Krishna-Gorai/simtix/docs/v3_plan.md

# SIMTiX v3: closing the gap to the Cortex-A53

Started 2026-10-28. Goal: raise SIMTiX's performance on the application suite
against one Cortex-A53 core at 1.2 GHz (measured on the ZCU102, best of `-O2`
and `-O3` NEON builds; `docs/zcu102_a53_run_O*.txt`), one measured change at a
time, so that every change has its own gain, area and frequency.

## Starting point (medium inputs, 8 lanes, 4 warps, 100 MHz, simulated)

| App | SIMTiX / best A53 time | IPC | Lane util. | L1 hit | Main loss |
|---|---|---|---|---|---|
| GEMM 64^3 | 5.0 | 0.71 | 100% | 93% | 7.4 warp instructions per FMA |
| Stencil 128^2 x4 | 10.1 | 0.54 | 100% | 91% | ~33 lane instructions per point |
| k-means 16384 | 4.6 | 0.72 | 100% | 96% | instruction count, clock |
| BFS 16384 | 4.1 | 0.41 | 43% | 57% | divergence, memory latency |
| SpMV 4096 | 5.6 | 0.34 | 59% | 75% | divergence, gathers |
| Scan 65536 | 47 | 0.51 | 95% | 74% | parallel algorithm, 7 launches |
| MLP b16 | 0.43 (SIMTiX faster) | 0.49 | 100% | 52% | -- |

Sources: `docs/board_sim.csv` (sim/board_sim.py --size board --lat 24) and the
A53 logs. The A53 has 32 KB L1 + 1 MB L2; SIMTiX has a 16 KB L1.

## Phases (in order; each ends with the checks below)

**A. Kernels (software).** Register-blocked GEMM (each thread a 2x4 block,
accumulation order over k unchanged, so bit-exact); stencil with reuse of loaded
neighbours; SpMV with several lanes per row (needs gold in the same summation
order); fewer scan launches; unrolled k-means. Keep the old kernels for the
ablation.

**B1. Banked scratchpad.** One bank per lane, conflicts serialised, instead of one
lane per cycle; enables tiled GEMM and stencil in shared memory.

**B2. Register scoreboard.** A warp keeps issuing independent instructions while
an FP, multiply, dot, shuffle or memory result is pending, instead of parking on
every multi-cycle unit.

**B3. Eight warps.** More latency hiding for BFS, SpMV and k-means (LUTRAM
register files grow with the warp count).

**B4. Memory hierarchy.** L1 to 64 KB in block RAM, 8-16 MSHRs, more tags,
next-line prefetch.

**B5. Clock.** 150-200 MHz: an operand-read stage and a split FPU stage 0 (the
current critical path); only together with B2 and B3.

**C. Multi-core.** Two or three 8-lane cores with a shared L2 and more HP ports
(the lane sweep showed that wider warps grow the memory engine with L^2).

**D. Domain units.** Wider INT8 dot products (two INT8 MACs per DSP), packed
FP16; extends the one application where SIMTiX already wins.

## Status (end of 2026-10-29)

| Phase | Change | State |
|---|---|---|
| A | GEMM register blocking (`gemm_rb.S`) | done 10-28 |
| A | segmented scan (`scan_seg.S`, `scan_segadd.S`) | done 10-29: 2.35x (B2) / 2.95x (B3+B4), bit-exact |
| A | stencil, SpMV, k-means kernels | not started |
| B1 | banked scratchpad | postponed 10-29: no application uses the scratchpad beyond a few words (see Findings) |
| B2 | step 1: FP/mul/dot/shuffle accept an instruction every cycle | done, simulation (xsim 28/28, Verilator, apps) |
| B2 | step 2: register scoreboard, warps sleep on a stall | done, simulation (xsim 28/28, apps); lost wake-up found by B3 and fixed 10-29 |
| B2 | step 3: non-blocking loads, 8 memory contexts | done, simulation (xsim 28/28, apps) |
| B2 | board build (Fmax, area, power on the XCZU7EV) | done 10-29: meets 100 MHz (see Findings) |
| B3 | eight warps | simulation done 10-29 (apps bit-exact, `apps_w8` test); board build to do (`warps8`) |
| B4 | memory hierarchy | sweep done 10-29: 64 KB L1, 16 MSHRs, 16 tags chosen; board build to do |
| B4 | next-line prefetch (`SIMTIX_L1_PF`) | implemented 10-29, L1 tests pass with it on and off; measurement pending |
| B5 | clock 150-200 MHz | planned 10-29 (see worklog): FPU stage 0 via retiming over the delay line; memory-engine request split |
| A | stencil (`stencil_rb.S`), k-means (`kmeans_u.S`), SpMV (`spmv_z.S`) | done 11-04, bit-exact (see Findings) |
| A' | Zba `sh1add`-`sh3add`, Zbb `min`/`max`(`u`), Zicond `czero.*` | done 11-04: decode + writeback mux, `zbtest` case |
| B5 | clock: request, input and resume registers in the memory engine, branch stage B | done 11-04 in simulation; build at 115 MHz to do |
| C | multi-core | not started |
| D | INT8/FP16 units | not started |

Every step's medium-size application results: `docs/v3_steps.csv` (column `step`).
Board builds run from a PowerShell window outside Claude Code (Claude Code stops
background jobs when the 8 GB PC runs low on memory):
`vivado -mode batch -source create_bd_ps.tcl -tclargs build zcu104 tag<name>` from
`fpga/`, after `Remove-Item Env:\NoDefaultCurrentDirectoryInExePath`.

## Findings

**2026-10-28, A (GEMM).** `gemm_rb.S` (a 4x4 block of C per thread, bit-exact
with `gemm.S`) cuts the warp instructions of GEMM 64^3 from 241,152 to 65,632
(3.7x) but its cycles only from 337,591 to 282,884 (1.19x): IPC falls from 0.71
to 0.23. The cause is in the warp pool, not the kernel: the FP unit is a
single-slot scoreboard (`fpc_state`, warp_pool.sv), so one FP warp instruction is
in flight in the whole accelerator and the 5-stage FPU holds one instruction at a
time, about one warp FMA per 7 cycles. The integer multiplier, dot-product,
shuffle and divide/sqrt units are built the same way. B2 therefore comes first
and is widened: the multi-cycle units accept a new warp instruction every cycle
(one result slot per pipeline stage), then a register scoreboard lets a warp keep
issuing independent instructions. Without it the kernel work of A cannot pay off
on FP and multiply-bound applications.

## Checks after every phase

1. xsim regression (sim/run_xsim.py, 28 configurations) and Verilator 5.020
   parity (CI).
2. Application suite bit-exact at small, board and (overnight) dram sizes;
   cycles, IPC, utilisation and L1 hit rate into docs/board_sim.csv.
3. Out-of-context synthesis and implementation on the XCZU7EV (LUT, FF, BRAM,
   DSP, Fmax, power); the board design for the ZCU104 must still close 100 MHz
   (or the new target clock).
4. A table row: phase, change, cycles per app, time at Fmax, ratio to the A53.

## Constraints

- The ZCU102's XCZU9EG needs a Vivado Enterprise license, so the accelerator
  does not run on the board: SIMTiX results come from simulation and XCZU7EV
  implementation; the A53 is measured.
- If SIMTiX becomes multi-core, the A53 comparison should include all four A53
  cores as well.
- Builds on the 8 GB PC: one Vivado run at a time, PC must not sleep.

**2026-10-29, B2 (register scoreboard) in three steps.** Medium inputs, 8 lanes,
4 warps, DDR model latency 24, all outputs bit-exact; cycles:

| App | v2 | Step 1 | Step 2 | Step 3 | Gain | SIMTiX / A53 time |
|---|---|---|---|---|---|---|
| GEMM-RB 64^3 | 282,884 | 145,067 | 96,939 | 80,443 | 3.52x | 4.19 -> 1.19 |
| GEMM 64^3 | 337,591 | 312,499 | 272,634 | 265,127 | 1.27x | 5.00 -> 3.93 |
| Stencil 128^2 x4 | 498,582 | 485,789 | 460,225 | 403,964 | 1.23x | 10.07 -> 8.16 |
| SpMV 4096 | 263,749 | 263,146 | 254,517 | 234,879 | 1.12x | 5.55 -> 4.94 |
| k-means 16384 | 993,810 | 942,594 | 913,366 | 899,601 | 1.10x | 4.63 -> 4.19 |
| Scan 65536 | 1,085,404 | 1,085,413 | 1,088,773 | 1,021,428 | 1.06x | 47.4 -> 44.6 |
| BFS 16384 | 1,771,198 | 1,771,800 | 1,770,554 | 1,724,941 | 1.03x | 4.08 -> 3.97 |
| MLP b16 | 1,973,694 | 2,012,258 | 2,152,311 | 1,936,909 | 1.02x | 0.43 -> 0.42 |

- Step 1. The FP, multiply, dot and shuffle units accept a warp instruction every
  cycle: a result queue per unit (`wp_resq`) carries the op's tag in step with the
  unit (latency FPU 6, multiply 7, dot 6, shuffle 1) and holds finished results until
  their write port is free.
- Step 2. The warp no longer parks on these units. Per-warp pending masks
  (`pend_x`, `pend_f`) hold back an instruction whose sources or destination are
  pending (decoded per opcode, so immediate fields never stall), whose unit is full
  (8 ops in flight per unit), or an ecall with results outstanding. Without more,
  MLP got 7% slower than step 1: the stalled warp was refetched every other cycle
  and took issue slots from the other warps. A stalled warp therefore sleeps until
  one of its own results is written (or, if its unit was full, any result); with
  that MLP recovered a third of the loss (`b2s2b_scoreboard_sleep` rows, measured for
  GEMM, GEMM-RB and MLP only).
- Step 3. Loads do not park the warp: rd is pending until the memory engine
  reports the load finished (`rs_ld`, `rs_rd`, `rs_fp`). Up to 2 loads per warp,
  8 memory contexts. A store, AMO, barrier or ecall waits until the warp has no load
  outstanding (a store never overtakes an earlier load of its warp; a barrier orders
  loads before it against stores after it). MLP is back below v2.
- What is left: GEMM-RB is within 1.19x of the A53 (NEON) at 100 MHz; the
  memory-bound applications (L1 hit 52-75%) gain only 2-12%, limited by the L1 and
  the request path (B4); scan needs a different algorithm (A).

**2026-10-29, B2 board build** (`create_bd_ps.tcl build zcu104 tagv3b2`,
`fpga/reports_ps_v3b2/`, against the v2 build in `fpga/reports_ps/`):

| | v2 | B2 |
|---|---|---|
| WNS at 10 ns | +0.098 ns | +0.093 ns (meets 100 MHz; Fmax 100.9 MHz) |
| LUTs | 81,060 | 84,459 (+4.2%) |
| Flip-flops | 23,910 | 32,969 (+38%) |
| CLBs | 13,703 (47.6%) | 14,640 (50.8%) |
| BRAM / DSP | 16 / 72 | 16 / 72 |
| SIMTiX power (vectorless) | 0.833 W | 1.049 W |

The flip-flops are the four result queues (4 x 8 x 256 bits, built from
flip-flops, not LUT-RAM) and the four extra memory contexts. The worst path moved
from FPU stage 0 (35 levels) to the memory engine: context pending lanes ->
coalescing / request select of the 8 contexts -> L1 input register (28 levels,
74% routing). B5 has to split both. GEMM-RB takes 3.5x fewer cycles at 1.26x the
power: about 2.8x less energy.

**2026-10-29, lost wake-up (B2) found by B3.** With 8 warps GEMM-RB hung. The issue
step decided "woken in the same cycle" with the reason of the warp's previous sleep
(`sb_wfull`); a warp whose last sleep was on a full FP unit then missed the
completion of the load it was now waiting for. Fixed (the stalling warp is judged by
this cycle's reason; the wake loop only touches sleeping warps). New regression test
`apps_w8` (medium GEMM-RB, 8 warps): fails on the old logic, passes now. With 4
warps the fix changes only GEMM-RB (80,443 -> 80,271 cycles); `b2_final` rows.

**2026-10-29, B3: eight warps** (`board_sim.py --warps 8`; 16 memory contexts,
2 per warp; `b3_8warps` rows):

| App | B2 (4 warps) | B3 (8 warps) | Gain | SIMTiX / A53 time |
|---|---|---|---|---|
| MLP b16 | 1,936,909 | 1,396,076 | 1.39x | 0.30 |
| Scan 65536 | 1,021,428 | 805,236 | 1.27x | 35.2 |
| Stencil 128^2 x4 | 403,964 | 322,010 | 1.25x | 6.51 |
| BFS 16384 | 1,724,941 | 1,444,288 | 1.19x | 3.33 |
| k-means 16384 | 899,601 | 841,946 | 1.07x | 3.92 |
| GEMM 64^3 | 265,127 | 249,518 | 1.06x | 3.70 |
| GEMM-RB 64^3 | 80,271 | 76,209 | 1.05x | 1.13 |
| SpMV 4096 | 234,879 | 237,185 | 0.99x | 4.99 |

More warps hide memory latency (MLP, stencil, scan, BFS); GEMM-RB is compute-bound;
SpMV's L1 hit rate falls (75% -> 72%) as 8 warps share the 16 KB L1, a B4 question.
Area and Fmax: board build `create_bd_ps.tcl build zcu104 tagv3b3 warps8` (the
block design is then synthesised globally so the define reaches SIMTiX).

**2026-10-29, B4: memory hierarchy sweep** (8 warps; speed-up over 8 warps with the
v2 memory system; all bit-exact; `b4_w8_*` rows):

| App | 8 MSHR | 16 tags | 16 MSHR + 16 tags | 32 KB L1 | 64 KB L1 | 64 KB + 16 MSHR + 16 tags |
|---|---|---|---|---|---|---|
| SpMV 4096 | 1.43 | 1.00 | 1.70 | 1.37 | 1.50 | 1.84 |
| BFS 16384 | 1.24 | 1.00 | 1.30 | 1.13 | 1.28 | 1.35 |
| GEMM-RB 64^3 | 1.01 | 1.01 | 1.03 | 1.08 | 1.07 | 1.08 |
| MLP b16 | 1.00 | 1.00 | 1.00 | 1.01 | 1.01 | 1.01 |
| GEMM, k-means, scan, stencil | 1.00 | 1.00 | 1.00 | 0.99-1.00 | 0.99-1.00 | 0.99-1.00 |

L1 hit rate with the combined change: SpMV 72% -> 87%, BFS 55% -> 74%, MLP 52% -> 59%
(its time does not move: the weights stream once per batch). The 4 miss registers
were the limit for the irregular applications; 16 tags help only together with more
miss registers. Stencil, scan, k-means and GEMM do not change at all, so next-line
prefetch (the remaining B4 item) has nothing to gain and is dropped. Choice: 64 KB
L1, 16 MSHRs, 16 tags. Board build for B3+B4: `create_bd_ps.tcl build zcu104
tagv3b34 warps8 l1kb64 mshr16 mtags16` (`mtags`, since `tag<name>` names the build).
16 tags widen the AXI ID to 5 bits: `simt_ps_wrap.v` had a hard-coded 4-bit ID,
now `IDW = log2(SIMTIX_MEM_TAGS) + 1` (default 4); both widths elaborate cleanly.

**2026-10-29, B1 postponed.** Of the eight applications only `scan.S` touches the
scratchpad, for the four warp totals of each block. A banked scratchpad (one bank
per lane) would speed up nothing in the suite; it pays off only for kernels that
tile through shared memory (GEMM, stencil), and B4's 64 KB L1 already serves
their reuse. B1 is reconsidered if phase A writes such a kernel.

**2026-10-29, A: segmented scan** (`scanseg` case: the same 65,536 inputs as
`scan`, seed shared). One warp scans a segment of 64 rows x 8 lanes: coalesced
row loads, a 3-step shuffle scan with the lane masks set up once, the running
total carried by one `shfl_idx`; 16 warp instructions per row. A second level scans
the 128 segment totals and `scan_segadd.S` adds them: 3 launches instead of 7.
Kernels in slots 10 and 11 (45 and 22 words); `a_scan_*` rows.

| Configuration | scan | scanseg | Gain | Warp instructions | SIMTiX / A53 time |
|---|---|---|---|---|---|
| B2, 4 warps | 1,021,751 | 433,947 | 2.35x | 549,736 -> 193,954 | 44.6 -> 19.0 |
| B3+B4 (8 warps, 64 KB, 16 MSHR, 16 tags) | 805,076 | 273,009 | 2.95x | same | 35.2 -> 11.9 |

The first pass now hits the L1 only 6% of the time (458 hits, 8,214 misses: every
line of the input is new) and the add pass misses again on the output (the L1
does not allocate on writes). That reverses the earlier conclusion on next-line
prefetch, which was drawn from kernels that reuse lines: streaming kernels such as
this one need it.

**2026-11-04, low-cost steps (kernels, ISA, clock).** The B3+B4 profile shows an
issue-bound core: IPC 0.68-0.96, lane use near 100% outside BFS and SpMV, and at most
20% of the HP0 port in use. One warp instruction per cycle on 8 lanes at 100 MHz is
0.8 G lane operations per second, below one A53 with NEON, so the cheap levers are
fewer instructions per result and a faster clock. Board inputs, 8 warps, 64 KB L1,
16 MSHRs, 16 tags, DDR model latency 24, all outputs bit-exact; cycles:

| App | Before | Kernel | + ISA | + clock stages | Gain |
|---|---|---|---|---|---|
| Stencil 128^2 x4 | 320,928 | 173,316 (strip of 16 rows) | -- | 148,935 (rows interleaved) | 2.15x |
| k-means 16384 | 841,609 | 652,224 (2 points/thread) | 548,667 (min, czero) | 537,806 (points interleaved) | 1.56x |
| SpMV 4096 | 129,287 | -- | 115,035 (pointer walk, sh2add) | 116,516 | 1.11x |
| other apps | -- | -- | -- | 0.96-0.99x | -- |

- `stencil_rb.S`: a thread computes 16 rows of one column; up, centre and down move
  down the column in registers, so a point loads 3 words instead of 5 and the
  per-thread setup is paid once per 16 points. The two rows of a loop pass are
  interleaved, which lifts IPC from 0.70 to 0.82.
- `kmeans_u.S`: two points per thread share each centroid load; the nearest-centroid
  update is `slt`, `min`, `czero.eqz`, `czero.nez`, `or` (5 instructions, 8 before).
- The three extensions add a 7-bit funct7 decode and one result mux per lane, on the
  register write only (not on the address path).
- Clock. A path analysis of the routed B2 build (`paths_named.tcl`) finds 38,680
  endpoints failing at 150 MHz, 12,087 at 125 MHz and 2,455 at 111 MHz, in four groups:
  warp issue -> memory-engine context registers, warp issue -> SIMT stack, memory
  engine -> L1 input register, and FPU stage 0 / last stage. 150 MHz would need an
  operand-read stage across the whole issue logic; the four groups are cut instead:
  the memory engine registers its request (choice, then address and data), its input
  and its warp resume (`BYP = 0` only), and a branch or jump updates the SIMT stack in
  a stage B one cycle after issue (the warp stays in flight). The FPU paths are left
  to synthesis retiming (`create_bd_ps.tcl ... retime`). Cost: 0.3-3.8% more cycles.
  Board build: `... tagv3b34 warps8 l1kb64 mshr16 mtags16 mhz116 retime`: the PS
  divides 1.5 GHz by 13 (115.37 MHz); it rounds a request down, so `mhz115` gives
  1.5 GHz / 14 = 107.1 MHz.
- Not addressed: reduce, scan and histogram. They stream one element per thread and
  are limited by instruction count, launches and global atomics; even the full HP0
  bandwidth at 100 MHz would not reach the A53 on reduce.

**2026-11-04, board run of the low-cost build** (`docs/zcu102_board_run_v3b34.txt`).
The build closes at 115.37 MHz with WNS +0.406 ns (est. Fmax about 121 MHz); 107,658
LUTs and 50,091 registers (the 100 MHz B3+B4 build had 110,970 and 48,383; B2 82,998
and 33,016); 16 BRAM tiles and 72 DSPs in each. All 28 cases are bit-exact, the
histogram included (the AXI ordering fix holds on the board). Time is the measured
accelerator time; A53/accel above 1 means the accelerator is faster.

| App | Size | B2 us | v3 us | v3 / B2 | A53/accel B2 | A53/accel v3 |
|---|---|---|---|---|---|---|
| GEMM | 64 | 2,584.8 | 2,165.0 | 1.19x | 1.04 | 1.25 |
| GEMM | 256 | 215,172.4 | 150,613.0 | 1.43x | 0.79 | 1.13 |
| GEMM, register-blocked | 256 | 49,662.0 | 37,780.7 | 1.31x | 3.42 | 4.49 |
| MLP | 256 | 278,560.9 | 189,783.3 | 1.47x | 2.62 | 3.85 |
| BFS | 262144 | 260,316.4 | 162,890.2 | 1.60x | 0.75 | 1.20 |
| Stencil, 16-row strip | 512 | 59,197.1 (stencil) | 18,945.1 | 3.12x | 0.36 | 1.12 |
| SpMV | 65536 | 46,634.9 | 20,204.9 | 2.31x | 0.39 | 0.90 |
| k-means, 2 points/thread | 262144 | 139,603.8 (kmeans) | 72,189.1 | 1.93x | 0.30 | 0.57 |
| Segmented scan | 1048576 | 54,667.9 | 35,474.8 | 1.54x | 0.08 | 0.13 |
| Histogram | 262144 | 7,897.4 | 5,653.5 | 1.40x | 0.25 | 0.35 |
| Scan | 1048576 | 145,148.9 | 108,019.7 | 1.34x | 0.03 | 0.04 |

PL power rises with the larger, faster design: idle 1.12 -> 1.24 W; accelerator
running 1.42-1.92 W (B2) -> 1.70-2.28 W.

`spmv_z` on the board (second run, 08:29; the other 28 cases repeat the first run within
1%): 4096 rows 116,949 cycles against 130,900 for `spmv` (1.12x, A53/accel 0.47);
65536 rows 2,233,648 against 2,332,695 (1.04x, A53/accel 0.94). The large case misses
the L1 on 40% of accesses, so fewer instructions help less there. It runs after the
other cases, so its random matrix differs from the `spmv` one (same size and density).

**Caution on the A53/accel column above:** it uses the board host's own A53 build
(`-O2`). Against the best A53 build (`-O3 -mcpu=cortex-a53`, NEON; `sw/a53_zcu102`) the
regular kernels move a lot (GEMM 3.6x, stencil 2.5x faster on the A53); see the table
of the afternoon below. The MLP's 3.85 is also against a reference that cannot
vectorize (below).

## 2026-11-04 (afternoon): everything on the board, new applications, AMO variants

Decisions (user): the TVLSI paper is retargeted to v3, and every result in it is
measured on the ZCU102: the AMO variants and the 4- and 16-lane designs as their own
bitstreams, and Vortex 3.0 as a PS peripheral of the same board. The paper shows both
A53 builds (`-O2` and `-O3` NEON).

**Board-build options** (`create_bd_ps.tcl`): `lanes<n>`, `agg<0|1>`, `apar<0|1>` set
`SIMTIX_NUM_LANES`, `SIMTIX_AMO_AGG`, `SIMTIX_AMO_PAR`; `simt_ps_top` takes its
`AMO_AGG` / `AMO_PAR` defaults from the two macros (a block-design module reference
cannot override parameters). `sim/v3_sweeps.py` runs `app_sweep.py` and
`amo_sweep.py` with the v3 defines (`docs/apps_agg_v3.csv`, `docs/amo_agg_v3.csv`;
15/15 runs pass).

**Host additions.** `main.c`: `hist_shared` (block-shared histogram) and
`amo_contend` (colliding `amoadd`/`amomax`/`amoswap`; every returned value and final
word checked against the serial lane order). `apps.c`: an overlay window in the
instruction RAM (`PC_OVL` = 0x000-0x1FF, 128 words; main.c's sync kernels are done
before the suite) into which `stencil_rb` and the new kernels are loaded at the start
of their application; a second, fair MLP reference (`A53T` rows: weights one
contiguous row per output, so GCC vectorizes the INT8 dot product). `gen_apps.py`:
`OVERLAY` kernels share one region after the resident ones and a case loads its
overlay kernel (a `KERNEL` line inside the case); `write_manifest()`.

**New application kernels** (all bit-exact in simulation at small and board sizes,
v3 defines, late write responses; and on the board):
- `conv8.S` (111 words): INT8 3x3 convolution, padding 1, requantization + ReLU as
  `mlp.S`; layout [row][channel/4][column] words so a layer's output is the next
  layer's input; a thread computes 4 adjacent pixels of one output channel (12
  `pdot8` per 9 loads). Board: 16 -> 32 -> 32 channels, 32x32 and 128x128 images.
  A53 reference: NHWC bytes, OHWI weights (contiguous channels, vectorized at -O3).
- `embag.S` (31 words): embedding-bag sum (recommendation inference), D = 32
  floats per row, summed in order from +0; two gathers in flight per warp. Board:
  16,384-row (2 MB) and 262,144-row (32 MB) tables, 256x16 and 4096x32 bags.
- `hashj.S` (26 words): hash-join probe, linear probing, 2^s slots {key, value},
  half full, half of the probe keys present; one backward branch, the hit test with
  Zicond. Board: s = 16 (16,384 probes) and s = 22 (32 MB, 1M probes).
- `mandel.S` (38 words): Mandelbrot escape counts, FP32, [-2, 0.5] x [-1.25, 1.25],
  M = 256. Board: 256^2 and 1024^2.
- `swat.S` (116 words): Smith-Waterman scores, affine gaps (+2/-1, open 3, extend 1),
  one DNA pair per thread, query in strips of 4 rows (H, E in registers, a packed
  boundary word per column between strips). Board: 2,048 and 16,384 pairs of 32 x 128.

**Board, `ser` bitstream (v3b34), against both A53 builds** (`docs/zcu102_board_run_v3_apps2.txt`,
`docs/zcu102_a53_run_O{2,3}_v3apps.txt`; large sizes; times in ms; > 1: SIMTiX faster):

| App | SIMTiX | A53 -O2 | A53 -O3 NEON | vs best A53 |
|---|---|---|---|---|
| Hash-join probe, 32 MB | 99.3 | 195.6 | 195.4 | 1.97 |
| CNN 128x128, 16-32-32 | 290.7 | 1,196.3 | 381.8 | 1.31 |
| GEMM-RB 256 | 37.8 | 169.6 | 47.2 | 1.25 |
| Embedding bag, 32 MB | 37.5 | 68.7 | 45.4 | 1.21 |
| BFS 262144 | 162.9 | 195.8 | 194.6 | 1.19 |
| SpMV-Z 65536 | 19.4 | 18.2 | 18.1 | 0.94 |
| k-means-U 262144 | 72.2 | 41.3 | 34.3 | 0.47 |
| Stencil-RB 512 | 18.9 | 21.3 | 8.6 | 0.45 |
| MLP 256, fair reference | 189.8 | 256.5 | 55.4 | 0.29 |
| Segmented scan 1M | 35.5 | 4.5 | 4.5 | 0.13 |

The `-O2` and `-O3` builds give the same arena hash for every application. SIMTiX
wins on memory-latency-bound work (hash join, embedding bag, BFS: one in-order A53
thread waits on each DRAM miss, SIMTiX keeps 64 threads and 16 misses in flight) and
on regular compute with reuse per thread (GEMM-RB, CNN). It loses on streaming kernels
with little work per element and on dense INT8 dot products, where NEON keeps up.
**MLP:** the original A53 reference reads the weights in the accelerator's packed
layout and cannot vectorize (730 ms at -O2 and -O3); with contiguous weights the A53
takes 256.5 ms at -O2 and 55.4 ms at -O3, so SIMTiX's 3.85x becomes 0.29x. The
paper must not use the old number. The MLP kernel itself does 0.32 G MAC/s (one
output per thread); a register-blocked version like `conv8.S` (0.78 G MAC/s in
simulation) would still trail the A53's ~1.1 G MAC/s. The A53 references are plain C
compiled by GCC, not a tuned library; a tuned NEON CNN would narrow the 1.31.

**AMO tests on the board** (`docs/zcu102_board_run_v3_ser.txt`; 262,144 elements;
`ser`): histogram 653,913 cycles (5.67 ms; A53 2.00 ms), block-shared histogram
1,186,938, contention 4,292,620 (37.2 ms; A53 6.2 ms); every contention return value
(786,432) and final word (524,288) matches the serial lane order. The L1 read counts
are exact: 3 reads per histogram warp (input line + one per bin line), 4 per contention
warp (input + one per AMO instruction). These kernels are memory-engine bound (the
port is held from an AMO's read to its write; ~20 cycles per histogram warp) and
measure the mechanism, not speed against the A53.

**`agg0` bitstream** (one read-modify-write per lane; `tagv3agg0 ... agg0 mhz116
retime`): WNS +0.349 ns at 115.37 MHz, 106,998 LUTs, 50,036 registers (aggregation
costs 660 LUTs, 0.6%, in context; 2,551 out of context in the v2 engine). Board
(`docs/zcu102_board_run_v3_agg0.txt`, all 0 errors), 262,144 elements, `agg0` -> `ser`:

| Kernel | agg0 cycles | ser cycles | Gain | L1 reads agg0 -> ser |
|---|---|---|---|---|
| Histogram | 1,618,167 | 652,783 | 2.48x | 294,912 -> 98,304 |
| AMO contention | 7,706,706 | 4,291,186 | 1.80x | 819,200 -> 131,072 |
| Block-shared histogram | 1,380,470 | 1,180,049 | 1.17x | 163,840 -> 49,152 |
| k-means-U | 8,937,737 | 8,331,755 | 1.07x | |
| k-means | 13,600,741 | 13,384,065 | 1.02x | |
| BFS | 18,826,816 | 18,792,724 | 1.00x | |

Without aggregation the block-shared histogram beats the plain one (textbook); with it
the plain one is 1.8x faster. The v2 paper's k-means gain of 1.29x shrinks to 1.02x
in v3 (8 warps, scoreboard and the 64 KB L1 make the final AMOs a small part).

**Mandelbrot and Smith-Waterman.** Small sizes pass (Mandelbrot IPC 0.92, 74% lane use;
Smith-Waterman IPC 0.97, 0.36 cells/cycle, about 42 M cells/s at 115 MHz). The first
board-size simulation failed only because `tb_apps` gave up after 2M status polls
(~10M cycles); the limit is now 20M and the rerun is in progress. A53 (board,
`docs/zcu102_a53_run_O{2,3}_v3apps2.txt`): Mandelbrot 1024^2 847.9 ms (-O2) / 845.7
(-O3); Smith-Waterman 16,384 pairs 922.1 ms (-O2) / 1,075.2 (-O3), 72.8 M cells/s.
Neither vectorizes.

**2026-11-06, both on the board** (`docs/zcu102_board_run_v3_apps3.txt`, `ser`, all
cases 0 errors; the board-size simulation passed first, 67,584 checks): Mandelbrot
256^2 7,876,275 cycles (68.3 ms; A53 best 52.9 ms, 0.77x), 1024^2 117,647,130 cycles
(1,019.7 ms; A53 best 845.7 ms, **0.83x**); Smith-Waterman 2,048 pairs 23,265,849
cycles (201.7 ms; A53 best 115.1 ms), 16,384 pairs 186,138,599 cycles (1,613.4 ms;
A53 best 922.1 ms, **0.57x**, 41.6 vs 72.8 M cells/s). Board and simulated cycles
agree within 0.1%. Total energy of the 18 rails, A53 best / SIMTiX: Mandelbrot 0.62,
Smith-Waterman 0.55 (SIMTiX phase 4.19 / 3.83 W, A53 phase 3.12-3.16 W).

**Energy, all applications (2026-11-05/06).** Sum of the 18 rails: idle 3.13-3.17 W
(A53 polling), SIMTiX phase 3.62-4.26 W (+0.5 to +1.1 W), A53 phase 3.18-3.38 W
(+0.05 to +0.2 W: the A53 already runs in the idle phase). Total energy, best A53 /
SIMTiX: hash join 1.50, CNN 1.02, BFS 0.96, embedding bag 0.94, GEMM-RB 0.94, SpMV-Z
0.73, Mandelbrot 0.62, Smith-Waterman 0.55, k-means-U 0.38, stencil-RB 0.34,
segmented scan 0.11. Energy above idle makes SIMTiX look 11-100x worse, because it
charges the accelerator its whole switching power and the A53 almost nothing; the
paper should report total energy first.
