Krishna-Gorai/simtix/docs/board_zcu104.md

# SIMTiX v2 on the ZCU104 (A53 host, DDR4)

The board build makes the accelerator a peripheral of the Zynq UltraScale+ PS:

```
Cortex-A53 --M_AXI_HPM0_FPD--> SmartConnect --AXI4-Lite--> simt_ps_top (0xA000_0000)
simt_accel --> l1_dcache --> axi_line_master --AXI4 128-bit--> S_AXI_HP0_FPD --> DDR4
```

| Window offset | Contents |
|---|---|
| `0x0000`–`0x00FF` | command / status registers (`REG_*` in `simtix_pkg.sv`) |
| `0x0100` / `0x0104` | L1 read hits / misses of the last kernel |
| `0x0108` | bit 0: an AXI error response was seen |
| `0x1000`–`0x1FFF` | kernel instruction RAM (1024 words); `REG_KERNEL_PC` is an offset into it |

Data buffers must lie below `0x4000_0000`: addresses with bits [31:30] = `01` are the
accelerator's scratchpad apertures. The HP0 port is not coherent with the A53
caches, so the host cleans its data cache before GO and invalidates it after DONE.
Writing GO also invalidates the L1.

## Build (on the PC)

1. Bitstream and hardware platform, from `fpga/` (launch Vivado from PowerShell):

   ```
   vivado -mode batch -source create_bd_ps.tcl -tclargs build
   ```

   writes `fpga/simtix_ps.xsa` and the reports in `fpga/reports_ps/`.

2. Host program (regenerate `kernels.h` only if a kernel changed):

   ```
   python sw/ps_host/gen_kernels.py
   vitis -s sw/ps_host/build_vitis.py
   ```

   builds `sw/ps_host/ws/ps_host/build/ps_host.elf`. Two gaps in a Vitis install
   without the Zynq UltraScale+ software components stop this step:

   - no `aarch64-none-elf-gcc`: install the Arm GNU Toolchain (14.2.rel1,
     `aarch64-none-elf`) and put its `bin` on `PATH`, or set `AARCH64_GCC_DIR`;
     the script defaults to `C:\toolchains\arm-gnu-14.2-aarch64-none-elf\bin`.
   - platform creation fails with "Application error processing RPC": the server
     is trying to copy QEMU files that were not installed. Creating the empty
     directories `Vitis\data\emulation\platforms\zynqmp\sw\{a53_linux,a53_standalone,r5_standalone}\qemu`
     is enough for a JTAG run.

## Run (in the lab)

1. Boot-mode switch SW6 to JTAG (all four ON); connect USB-JTAG and USB-UART;
   power on.
2. Open a terminal on the board's first USB-UART port at 115200 8N1.
3. From the repository root: `xsdb sw/ps_host/run_board.tcl` (`xsdb` is in `Vivado\bin`).

The program prints one CSV line per run and a final verdict:

```
BOARD,kernel,N,accel_cycles,accel_us,a53_us,l1_hits,l1_misses,errors
BOARD,reduce_shfl,1024,...
...
RESULT: PASS (0 errors)
```

`accel_cycles` is the accelerator's own cycle counter (100 MHz); `accel_us` is
the wall time from GO to DONE measured by the A53 (including register polling);
`a53_us` is the same computation on one A53 core.

After `reduce_shfl` and `histogram`, the application suite (`sw/ps_host/apps.c`,
the kernels of `kernels/apps/`) prints one row per application and size, with the
size in the `N` column: `gemm` (n x n FP32, n = 64, 256), `spmv` (rows, 16 nonzeros
at most per row), `stencil` (n x n, 4 sweeps), `kmeans` (points, 16 clusters),
`bfs` (vertices, degree 8) and `scan` (elements). Multi-launch applications
(stencil, BFS, scan) sum cycles and L1 counts over their launches, and `accel_us`
covers the first GO to the last DONE. The A53 baselines are ordinary sequential
codes (a queue for BFS, a running sum for scan, i-k-j GEMM), and every accelerator
output is compared exactly with them; the data lives in DDR4 at `0x1000_0000`.

Last comes a power pass (`sw/ps_host/power.c`) over the DRAM-sized input of each
application, if the board's monitors answer on the PS I2C1 bus: the INA226 on the
12 V input (U183, 5 mΩ shunt) and the five outputs of each IRPS5401 PMIC (U175 at
0x43, U180 at 0x44), behind the PCA9548 mux at 0x74. It first prints one
`POWERRAIL,<rail>,<mV>,<mW>` line per rail it found (the output voltages identify
the PMIC rails), then, per application, one row per phase and rail:

```
POWER,app,size,phase,rail,mV,mW,samples,reps,ms
```

Each phase is repeated for two seconds and sampled at most every 50 ms between
repetitions (and while the A53 polls the accelerator): `idle` is the A53 polling
the status register with the accelerator idle, `accel` the accelerator running
the application, `a53` the A53 running its reference. `reps / ms` gives the time
per repetition. Outputs are not checked in this pass. The program writes only the
mux's channel byte, the PMBus PAGE command and the INA226 configuration register.

## ZCU102 (2026-10-28)

The lab's board turned out to be a ZCU102 (XCZU9EG). `create_bd_ps.tcl`,
`power.c`, `build_vitis.py` and `run_board.tcl` take the board as an argument
(ZCU102 by default) and `power.c` has the ZCU102 monitor table (PS I2C0, PCA9544
mux at 0x75, 18 INA226). Vivado ML Standard cannot implement the XCZU9EG, so
until a license is available only the A53 side runs on that board:
`sw/a53_zcu102/README.md` (PS bring-up over JTAG, A53 references and power) and
`docs/zcu102_a53.md` (results).
