Krishna-Gorai/simtix/docs/zcu102_a53.md

# A53 on the ZCU102, and SIMTiX against it (2026-10-28)

The application suite's A53 references measured on a ZCU102 (XCZU9EG, board
revision 1.1), and SIMTiX's cycles for the same inputs from simulation. Procedure
and tools: `sw/a53_zcu102/README.md`. Raw data: `docs/zcu102_a53_run_O2.txt`,
`docs/zcu102_a53_run_O3.txt` (the first run, before the arena hash, is
`docs/zcu102_a53_run.txt`), and `docs/board_sim.csv`.

## Setup

- One Cortex-A53 core (A53 #0), bare metal, MMU and caches on (standalone BSP).
  APU clock 1200.0 MHz from the clock registers (APLL FBDIV 72, DIV2, ACPU
  divisor 1); 1199.6-1199.9 MHz measured with the PMU cycle counter against the
  system counter.
- System counter (IOU_SCNTRS): 94.76-94.79 MHz measured against the host clock
  over 10 s in every run (IOPLL 1516.7 MHz / 16), not the 93.84 MHz that
  psu_init writes into its base-frequency register. All A53 times use the
  measured value.
- PS initialised over JTAG from U-Boot's `zynqmp-zcu102-rev1.1/psu_init_gpl.c`
  (SHA-256 69dcb39b...); DDR4 tested over the debug port before every run.
- References: `sw/ps_host/apps.c` built `-DSIMTIX_A53_ONLY`: ordinary sequential
  algorithms (i-k-j GEMM, a queue for BFS, a running sum for the scan), the same
  FP operations in the same order as the kernels (`fp-contract=off`, explicit
  `fmaf`, compiled to `fmadd`). Two builds: `-O2` (the board host's own build)
  and `-O3 -mcpu=cortex-a53` (GCC vectorises with NEON; 108 vector instructions).
  Neither uses `-ffast-math`.
- The arena is cleared at start, and an FNV-1a hash of the arena (inputs and A53
  results) after each application is the same in both builds for all 14 cases:
  the NEON build computes the same results.
- The two A53 runs agree with the first `-O2` run within 0.5%.

## A53 run time

| App | Input | A53 -O2 (ms) | A53 -O3 NEON (ms) | -O3 gain | Same results |
|---|---|---|---|---|---|
| GEMM | 64^3 | 2.704 | 0.675 | 4.01x | yes |
| GEMM | 256^3 | 169.612 | 47.247 | 3.59x | yes |
| SpMV | 4,096 rows | 0.475 | 0.583 | 0.81x | yes |
| SpMV | 65,536 rows | 18.223 | 18.174 | 1.00x | yes |
| Stencil | 128^2, 4 sweeps | 1.316 | 0.495 | 2.66x | yes |
| Stencil | 512^2, 4 sweeps | 21.255 | 8.589 | 2.47x | yes |
| k-means | 16,384 points | 2.579 | 2.147 | 1.20x | yes |
| k-means | 262,144 points | 41.350 | 34.974 | 1.18x | yes |
| BFS | 16,384 vertices | 4.375 | 4.342 | 1.01x | yes |
| BFS | 262,144 vertices | 195.540 | 194.739 | 1.00x | yes |
| Scan | 65,536 | 0.285 | 0.229 | 1.25x | yes |
| Scan | 1,048,576 | 4.549 | 4.548 | 1.00x | yes |
| MLP | batch 16 | 46.113 | 46.135 | 1.00x | yes |
| MLP | batch 256 | 730.230 | 729.765 | 1.00x | yes |

NEON helps the regular compute-bound loops (GEMM, stencil); the memory-bound or
irregular ones (SpMV, BFS, scan, MLP) are unchanged. The comparison below uses
the faster build of each application.

## Power monitors

18 INA226 monitors on PS I2C0 behind the PCA9544 mux at 0x75 (channel 0: PS
rails, channel 1: PL rails), shunts 5 mOhm except U79 (2 mOhm). Rail names are
the reference designators; by voltage, U76 is the PS full-power-domain supply
(0.85 V) and U93 the 1.2 V DDR I/O supply. **To confirm against the ZCU102 user
guide (UG1182, INA226 table) before naming rails in the paper.**

| Rail | Bus | mV | mW (start of the O3 run) |
|---|---|---|---|
| ps_u76 | PS | 847 | 1209 |
| ps_u77 | PS | 847 | 247 |
| ps_u78 | PS | 1813 | 17 |
| ps_u87 | PS | 1203 | 52 |
| ps_u85 | PS | 847 | 82 |
| ps_u86 | PS | 1815 | 28 |
| ps_u93 | PS | 1193 | 202 |
| ps_u88 | PS | 1797 | 4 |
| ps_u15 | PS | 1812 | 7 |
| ps_u92 | PS | 1820 | 44 |
| pl_u79 | PL | 845 | 253 |
| pl_u81 | PL | 847 | 23 |
| pl_u80 | PL | 1795 | 419 |
| pl_u84 | PL | 1197 | 25 |
| pl_u16 | PL | 3297 | 105 |
| pl_u65 | PL | 1797 | 10 |
| pl_u74 | PL | 898 | 8 |
| pl_u75 | PL | 1197 | 10 |

The PL rails (about 0.85 W) are static power plus whatever design the board's
SD card loads; they do not involve these runs.

PS power on the DRAM-sized inputs, each phase repeated for 6 s. `idle` is the A53
polling a memory word (what it does while the accelerator runs), so the
difference is the cost of the work over a busy wait:

| App | Build | PS idle (mW) | PS A53 (mW) | Above idle (mW) | Samples |
|---|---|---|---|---|---|
| GEMM | -O2 | 1895 | 1905 | +10 | 35 |
| GEMM | -O3 | 1885 | 1966 | +81 | 61 |
| SpMV | -O2 | 1896 | 1967 | +71 | 101 |
| SpMV | -O3 | 1888 | 1965 | +77 | 102 |
| Stencil | -O2 | 1899 | 1932 | +33 | 87 |
| Stencil | -O3 | 1891 | 1997 | +106 | 105 |
| k-means | -O2 | 1902 | 1912 | +10 | 68 |
| k-means | -O3 | 1889 | 1911 | +22 | 81 |
| BFS | -O2 | 1893 | 1927 | +34 | 30 |
| BFS | -O3 | 1886 | 1927 | +41 | 31 |
| Scan | -O2 | 1898 | 2071 | +173 | 109 |
| Scan | -O3 | 1886 | 2068 | +182 | 108 |
| MLP | -O2 | 1898 | 1889 | -9 | 9 |
| MLP | -O3 | 1887 | 1892 | +5 | 9 |

The PS draws about 1.9 W either way; real work adds 10-180 mW, mostly on the
full-power-domain rail and, for streaming applications, the DDR I/O rail. MLP's
small difference is within the noise of its 9 samples (one pass takes 730 ms and
the rails are sampled between passes).

## SIMTiX against the A53 (medium inputs)

SIMTiX: `sim/board_sim.py --size board --lat 24`, the board top in xsim with an
AXI4 DDR4 model of 24 cycles of latency, 8 lanes, 4 warps, all outputs checked
bit-exactly; time at the board design's 100 MHz. **SIMTiX is simulated, the A53
measured.**

| Case | SIMTiX cycles | Warp instr. | IPC | Lane util. | L1 hit | SIMTiX at 100 MHz (ms) | Best A53 (ms) | SIMTiX / A53 time |
|---|---|---|---|---|---|---|---|---|
| bfs_16384x8 | 1,771,198 | 729,511 | 0.41 | 43% | 57% | 17.71 | 4.342 | 4.08 |
| gemm_64x64x64 | 337,591 | 241,152 | 0.71 | 100% | 93% | 3.38 | 0.675 | 5.00 |
| gemmrb_64x64x64 | 282,884 | 65,632 | 0.23 | 100% | 81% | 2.83 | 0.675 | 4.19 |
| kmeans_16384x16 | 993,810 | 714,752 | 0.72 | 100% | 96% | 9.94 | 2.147 | 4.63 |
| mlp_784x256x128x10_b16 | 1,973,694 | 968,992 | 0.49 | 100% | 52% | 19.74 | 46.113 | 0.43 |
| scan_65536 | 1,085,404 | 549,736 | 0.51 | 95% | 74% | 10.85 | 0.229 | 47.46 |
| spmv_4096x4096 | 263,749 | 89,080 | 0.34 | 59% | 75% | 2.64 | 0.475 | 5.55 |
| stencil_128x128x4 | 498,582 | 270,336 | 0.54 | 100% | 91% | 4.99 | 0.495 | 10.08 |

The A53 is 4-10x faster on six applications and 47x on the scan; SIMTiX is 2.3x
faster only on the INT8 MLP (`pdot8`). Reasons: 12x the clock, 1 MB of L2
against a 16 KB L1, many instructions per useful operation in the kernels, and
a single-slot FP unit (see `docs/v3_plan.md`, Findings). `gemmrb` is the
register-blocked GEMM of v3 phase A.

## Open

- DRAM-sized SIMTiX simulation (`--size dram`, `WORDS_LG = 24`): not run yet
  (several hours).
- Rail names from UG1182.
- The paper's presentation of the A53 comparison (to discuss with the co-author).
