Krishna-Gorai/simtix/docs/paper/simtix_vlsid.tex

%==============================================================================
% SIMTiX --- VLSID 2027 submission (6-page IEEE conference format).
% Floating-point timing-closure-focused variant of simtix.tex.
% Build:  pdflatex simtix_vlsid && pdflatex simtix_vlsid   (twice for xrefs)
% Figures produced by docs/plot_bench.py into docs/figs/.
%==============================================================================
\documentclass[10pt,conference]{IEEEtran}
\IEEEoverridecommandlockouts

\usepackage{cite}
\usepackage{amsmath,amssymb}
\usepackage{graphicx}
\usepackage{booktabs}
\usepackage{xcolor}
\usepackage{tikz}
\usetikzlibrary{positioning,fit,backgrounds,arrows.meta,calc}
\usepackage{url}
\usepackage[hidelinks]{hyperref}

\graphicspath{{../figs/}}

%------------------------------------------------------------------------------
% Uniform table style: same column padding, row height, and rule weights
% everywhere, with right-aligned numeric columns throughout.
%------------------------------------------------------------------------------
\setlength{\tabcolsep}{4pt}
\renewcommand{\arraystretch}{1.10}

% Uniform notation shortcut.
\newcommand{\Fmax}{$F_{\mathrm{max}}$}

%----- Double-blind toggle. VLSID 2027 reviews double-blind, so the submitted PDF
%----- must not identify the authors. This file defaults to the ANONYMOUS build,
%----- so a plain `pdflatex simtix_vlsid` always produces the submittable PDF.
%----- For the camera-ready once accepted, define CAMERAREADY on the command line:
%-----     pdflatex "\def\CAMERAREADY{}\input{simtix_vlsid}"
%----- Everything else in this file is shared by both builds; there is no second
%----- copy of the paper to keep in sync.
\newif\ifanon
\ifdefined\CAMERAREADY \anonfalse \else \anontrue \fi

\begin{document}

\title{SIMTiX: A Compact SIMT Accelerator for\\
RISC-V with a Pipelined FP32/FP16 Datapath}

\ifanon
\author{\IEEEauthorblockN{Anonymous Author(s)}
\IEEEauthorblockA{Affiliation withheld for double-blind review}}
\else
\author{\IEEEauthorblockN{Krishna Gorai}
\IEEEauthorblockA{Indian Institute of Technology Mandi\\
Email: kg05112001@gmail.com}
\and
\IEEEauthorblockN{Dr.~Bikram Paul}
\IEEEauthorblockA{Assistant Professor\\
Indian Institute of Technology Mandi\\
Email: bikram@iitmandi.ac.in}}
\fi

\maketitle

\begin{abstract}
We present SIMTiX, a compact Single-Instruction Multiple-Thread (SIMT)
accelerator for RISC-V whose complete path---RTL, simulation, synthesis,
place-and-route, and post-route gate-level sign-off---is carried out on a single
workstation. Eight lanes grouped into four resident warps attach to a five-stage
RISC-V host through a memory-mapped offload interface and implement the full SIMT
mechanism set: warp scheduling with a background memory engine, address
coalescing, a per-warp reconvergence stack, and an on-chip scratchpad. Placing the
vector register file and the scratchpad in distributed RAM reduces LUT usage by
$5.7\times$ and closes 100~MHz timing. Every lane carries a pipelined
floating-point unit covering FP32 and FP16 add, multiply, fused multiply-add, and
iterative divide and square root, verified bit-exact against an IEEE-754 reference
over $116{,}089$ vectors; half precision reuses the single-precision datapath
through NaN-boxed widen--compute--narrow at no cycle cost. The central result is a
\emph{placed} timing-closure study of this datapath on a Zynq UltraScale+ FPGA,
organized around an explicit delay model. The floating-point fabric is
interconnect-bound: we diagnose the limit, confirm it by de-congestion, localize
it to a single lane's fused-multiply-add cone, and close 100~MHz with a
three-stage unit that moves the critical path off the floating-point datapath. The
complete system-on-chip signs off at 103.7~MHz as a deployable, pin-constrained
bitstream with a clean design-rule check.
\end{abstract}

\begin{IEEEkeywords}
SIMT, GPGPU, RISC-V, hardware accelerator, floating-point, half precision,
fused multiply-add, timing closure, FPGA, place-and-route.
\end{IEEEkeywords}

%==============================================================================
\section{Introduction}
%==============================================================================
Graphics processing units execute thousands of scalar threads in lockstep groups
called \emph{warps} under a Single-Instruction Multiple-Thread (SIMT) model. The
mechanisms that make this efficient---warp scheduling for latency hiding, memory
coalescing, control-divergence handling, and on-chip scratchpads---are well
documented for commercial GPUs~\cite{hennessy,aamodt}, but what they cost once
placed and routed is not. Production GPUs are proprietary; open GPGPU cores such
as Vortex~\cite{vortex} are powerful but large, and report pre-placement
synthesis estimates; and small academic cores are often simulator-only or stop
short of a real implementation flow. The result is that the physical behavior of
the SIMT mechanism set---which structure actually bounds frequency, and why---is
largely unreported.

This paper presents SIMTiX, a deliberately compact SIMT accelerator for RISC-V
whose entire path, from RTL through bitstream and post-route gate-level sign-off,
runs on a single workstation with free or widely available tools. Compactness here
is a method rather than a goal: a design small enough to re-place and re-route in
full, in hours, is one whose frequency limit can be attributed to a named
structure and then \emph{tested} by changing only that structure and re-running
the flow---a controlled experiment impractical on a large core and unavailable in
a simulator. SIMTiX implements the complete SIMT mechanism set with a pipelined
floating-point unit per lane. Its headline result is a \emph{placed}
timing-closure study showing that, once the lanes carry floating point, the design
becomes interconnect- rather than logic-bound, and that 100~MHz is reached by
attacking the per-lane fused multiply-add (FMA) microarchitecture.

\noindent\textbf{Contributions.} We present (i)~a SIMT accelerator of eight lanes
and four resident warps implementing the complete mechanism set---warp scheduling,
coalescing, a reconvergence stack, and a scratchpad---integrated with a five-stage
RISC-V host as a self-contained system-on-chip
(Sections~\ref{sec:arch}--\ref{sec:impl}); (ii)~an implementation result showing
that moving the vector register file and scratchpad into distributed RAM cuts LUT
usage by $5.7\times$, with an analysis of why the register-file read multiplexer,
not the ALUs, dominates a naive SIMT datapath (Section~\ref{sec:impl});
(iii)~a per-lane FP32/FP16 extension in which half precision is obtained from the
single-precision path by NaN-boxed widen--compute--narrow, shown to be correctly
single-rounded and verified bit-exact over $116{,}089$ vectors
(Section~\ref{sec:fp}); and (iv)~a placed timing-closure study organized around an
explicit delay model that diagnoses the FP design as interconnect-bound, confirms
this by de-congestion, localizes the limit to one lane's FMA cone through a
control experiment the model predicts will fail, and closes 100~MHz with a
three-stage FMA, carrying the result to a system-on-chip signed off at 103.7~MHz
with full pin constraints and a clean design-rule check (Section~\ref{sec:fppa}).

%==============================================================================
\section{Architecture and Platform}\label{sec:arch}
%==============================================================================
A SIMT machine groups scalar \emph{threads} into \emph{warps} that share one
instruction stream and execute on a vector of \emph{lanes}. SIMTiX sets warp size
equal to lane count ($\mathrm{WARP\_SIZE}=\mathrm{NUM\_LANES}=8$) with
$\mathrm{NUM\_WARPS}=4$ resident warps time-sharing one fetch/decode/execute
datapath, so a warp stalled on memory is replaced by another. Unlike a packed-SIMD
vector unit such as the RISC-V ``V'' extension~\cite{riscvvector}, SIMTiX keeps a
scalar thread per lane with an independent program-counter abstraction managed by
the reconvergence stack, handling data-dependent control flow in hardware rather
than by software masking.

\textbf{Offload model.} The host programs a command block over a memory-mapped
interface---kernel PC, base pointers, and thread count $N$---writes a \texttt{GO}
bit, and polls \texttt{DONE}. On \texttt{GO} the accelerator launches
$\lceil N/8\rceil$ warps, seeding each thread's identifier and arguments at spawn.
Four mechanisms make up the platform.

\textbf{Warp pool and scheduler.} Four resident slots, each with its own PC,
active mask, register-file partition, and reconvergence stack, share one datapath
and one data port. A round-robin scheduler issues one runnable warp per cycle
while a background memory engine services accesses, so other warps' compute
instructions keep the datapath busy.

\textbf{Coalescing.} The data port is one cache line wide
($\mathrm{LINE\_WORDS}=8$, 256~bits). The memory engine groups the active lanes'
addresses by line and spends one transaction per distinct line, so a contiguous
warp access collapses to a single transaction and a fully scattered one costs up
to eight.

\textbf{Reconvergence stack.} Each warp owns a SIMT stack whose top frame defines
the live PC and active mask. A branch on which active lanes disagree pushes a
frame so the two lane groups run in turn and reconverge at a join PC, supporting
compiler-free single-sided \texttt{if} statements and divergent loops.

\textbf{Scratchpad.} A per-warp 64-word aperture serviced from on-chip RAM stages
data reused across a warp's lanes, cutting global traffic.

The active mask additionally drives a per-lane clock enable, so masked-off lanes
are not clocked; under a first-order activity model~\cite{gpuwattch} the
unused-lane fraction, 22.5\% of lane-datapath dynamic energy on a heavily
divergent kernel, is energy a divergence-aware design saves. Every mechanism is
instrumented with hardware counters and is therefore measured directly in RTL
rather than estimated in a software model~\cite{gpgpusim}.

%==============================================================================
\section{Implementation}\label{sec:impl}
%==============================================================================
SIMTiX is written in synthesizable SystemVerilog and integrated with a reused
five-stage RV32I host into a self-contained chip (\texttt{chip\_top},
Fig.~\ref{fig:arch}) comprising the host core, a driver ROM, the accelerator, and
an eight-bank on-chip shared memory. The host loads operands into shared memory,
launches the accelerator, and reads results back, so the entire
CPU$\rightarrow$memory$\rightarrow$accelerator$\rightarrow$memory$\rightarrow$CPU
loop runs in hardware.

\begin{figure}[t]
\centering
\resizebox{\columnwidth}{!}{%
\begin{tikzpicture}[
  font=\footnotesize,
  box/.style={draw,rounded corners=1.5pt,align=center,fill=gray!12,
              inner sep=3pt,minimum height=6.5mm},
  fp/.style ={draw,rounded corners=1.5pt,align=center,fill=blue!16,
              inner sep=3pt,minimum height=6.5mm},
  mem/.style={draw,rounded corners=1.5pt,align=center,fill=gray!28,
              inner sep=3pt,minimum height=6.5mm},
  lab/.style={font=\scriptsize\itshape,inner sep=1pt},
  tag/.style={font=\scriptsize\itshape,fill=white,inner sep=1.5pt},
  >=Latex
]
% ---- Host subsystem ----
\node[box,minimum width=3.3cm] (cpu) at (-1.65,7.3) {RV32I five-stage\\host core};
\node[mem,minimum width=2.5cm] (rom) at (1.85,7.3) {Driver ROM};
% ---- MMIO ----
\node[box,minimum width=6.4cm] (mmio) at (0,6.05)
  {MMIO offload interface:\,kernel PC, base ptrs, $N$, \texttt{GO}/\texttt{DONE}};
% ---- Accelerator internals ----
\node[box,minimum width=6.4cm] (sched) at (0,4.95)
  {Warp pool \& round-robin scheduler\\[-1pt]
   {\scriptsize 4 warps: PC, active mask, reconvergence stack}};
\node[box,minimum width=6.4cm] (alu) at (0,4.05) {Integer ALU\, $\times\,8$ lanes};
\node[fp,minimum width=6.4cm]  (fpu) at (0,3.45)
  {Five-stage FP32/FP16 unit\, $\times\,8$ lanes};
\node[mem,minimum width=2.0cm] (vrf)  at (-2.2,2.45) {Int VRF\\(LUTRAM)};
\node[fp,minimum width=2.0cm]  (frf)  at ( 0.0,2.45) {FP RF\\(LUTRAM)};
\node[mem,minimum width=2.0cm] (spad) at ( 2.2,2.45) {Scratchpad\\(LUTRAM)};
\node[box,minimum width=3.05cm] (memeng) at (-1.675,1.35) {Coalescing\\memory engine};
\node[fp,minimum width=3.05cm]  (sfu)    at ( 1.675,1.35) {Shared serial\\Div/Sqrt SFU};
% ---- Shared memory ----
\node[mem,minimum width=6.4cm] (smem) at (0,0.25)
  {Eight-bank on-chip shared memory (LUTRAM)};
% ---- Left rail label (kept as a node so the SoC border encloses it) ----
\node[lab,rotate=90,anchor=south] (oplab) at (-4.05,3.8) {operands\,/\,results};
% ---- Containers ----
\begin{scope}[on background layer]
  \node[fit=(cpu)(rom),draw,dashed,rounded corners,inner sep=2.2mm,
        fill=gray!5] (hostg) {};
  \node[fit=(sched)(alu)(fpu)(memeng)(sfu)(vrf)(frf)(spad),draw,rounded corners,
        inner sep=2.6mm,fill=blue!4] (accg) {};
  \node[fit=(hostg)(mmio)(accg)(smem)(oplab),draw,thick,rounded corners,
        inner sep=3.0mm] (chip) {};
\end{scope}
% ---- Group tags, drawn on the border so nothing is ever overlapped ----
\node[tag,anchor=west] at ($(accg.north west)+(4mm,0)$) {SIMT accelerator};
\node[tag,anchor=west] at ($(chip.north west)+(4mm,0)$)
  {\texttt{chip\_top}: self-contained SoC};
% ---- Edges ----
\draw[<->] (cpu.south) -- (cpu.south|-mmio.north)
           node[tag,midway,right,xshift=1.5pt] {offload\,/\,poll};
\draw[->]  (mmio.south) -- (sched.north);
\draw[->]  (sched.south) -- (alu.north);
\draw[<->] (fpu.south) -- (frf.north)
           node[lab,midway,right,xshift=2pt] {operands};
\draw[<->] (memeng.south) -- (memeng.south|-smem.north)
           node[tag,midway,left,xshift=-2pt] {coalesced};
\draw[<->] (cpu.west) -- ++(-0.75,0) |- (smem.west);
\end{tikzpicture}}
\caption{SIMTiX system architecture. The five-stage RISC-V host drives the SIMT
accelerator over a memory-mapped offload interface and exchanges operands and
results through the eight-bank on-chip shared memory. Floating-point blocks are
tinted blue; register files and the scratchpad live in distributed RAM (LUTRAM).
The FP unit is drawn as deployed: the three-stage FMA that closes 100~MHz
(Section~\ref{sec:fppa}) becomes five stages in the final chip once the
significand multiply is fully pipelined onto DSP blocks.}
\label{fig:arch}
\end{figure}

\textbf{From flip-flops to LUTRAM.} The first synthesis of the accelerator on a
Zynq UltraScale+ (\texttt{xczu7ev}) consumed $170{,}868$ LUTs, 74\% of the device,
at only 10\% of its flip-flops. The cause is structural: a flip-flop vector
register file (VRF) of $4\times8\times32$ 32-bit words is $32{,}768$ registers
read as \texttt{vrf[warp][lane][reg]} with \emph{both} indices variable---a
128-to-1 multiplexer per lane per read port. That multiplexer fabric, not the
ALUs, dominates area and sets the critical path. Re-expressing the VRF as one
distributed-RAM bank per lane, and likewise the scratchpad, removes essentially
all those registers: LUTs fall $5.7\times$ to $30{,}088$ (13\%), flip-flops to
$4{,}590$ (1.0\%), closing 100~MHz with positive slack at 0.81~W. The complete
chip, taken through opt/place/phys-opt/route to a bitstream, meets timing at
100~MHz using $34{,}850$ LUTs (15.1\%), $6{,}130$ flip-flops, 24 DSPs, and zero
block RAM at 1.09~W, the accelerator being roughly 87\% of the logic.

\textbf{Verification ladder.} Correctness is established at four levels:
cycle-accurate RTL simulation with self-checking testbenches
(Verilator~\cite{verilator}); vendor behavioral simulation; place-and-route with
post-route timing sign-off; and post-implementation gate-level functional
simulation of the routed netlist. The benchmark suite adds a fifth,
breadth-oriented level.

%==============================================================================
\section{Platform Evaluation}\label{sec:results}
%==============================================================================
The integer platform is characterized with six kernels stressing distinct
mechanisms: \texttt{vadd} ($C_i=A_i+B_i$, streaming), \texttt{saxpy}
($3A_i+B_i$, coalescing), \texttt{fir} ($A_i+2A_{i+1}+A_{i+2}$, stencil),
\texttt{relu} (light divergence), \texttt{collatz} (heavy data-dependent
divergence), and \texttt{reduce} (scratchpad reduction). Each is assembled from
RISC-V source with a stock toolchain, run at $N\in\{8,64,256,1024\}$ threads, and
checked bit-exact against a golden model; for an apples-to-apples speedup every
kernel is also written as a scalar loop and run on the same five-stage host in
RTL.

Table~\ref{tab:speedup} gives the headline platform result. Throughput ramps with
occupancy through latency hiding and saturates near 6.7 work-items per cycle,
below the eight-lane ideal because of the single shared data port. Streaming
kernels reach $7$--$10\times$ over the scalar host; \texttt{fir} is lower
($6.99\times$) because its stencil coalesces only partially; \texttt{collatz}
achieves $2.76\times$ as heavy divergence erodes, but does not eliminate, the SIMT
advantage; and \texttt{reduce} falls below break-even at $0.72\times$, since a
single-lane collapse on a single-ported scratchpad is slower than the scalar core
and calls for a dedicated cross-lane reduction primitive. A sweep over
$\mathrm{NUM\_LANES}\in\{4,8,16,32\}$ and $\mathrm{NUM\_WARPS}\in\{2,4,8\}$, all
twelve configurations elaborating and verifying bit-exact, shows throughput
scaling near-linearly with lanes ($\sim\!1.97\times$ per doubling), while
occupancy beyond two warps pays off only under realistic multi-cycle memory.

\begin{table}[t]
\caption{Measured cycles and speedup over the five-stage RV32I host running
identical work.}
\label{tab:speedup}
\centering
\footnotesize
\begin{tabular}{lrrrrr}
\toprule
Kernel & $N$ & Accel. & CPU & Speedup & Lane util.\\
       &     & (cycles) & (cycles) & & \\
\midrule
\texttt{vadd}    & 1024 & 1{,}413 & 13{,}322 & $9.43\times$ & 100\%\\
\texttt{saxpy}   & 1024 & 1{,}669 & 16{,}394 & $9.82\times$ & 100\%\\
\texttt{fir}     & 1024 & 2{,}053 & 14{,}345 & $6.99\times$ & 100\%\\
\texttt{relu}    & 1024 & 1{,}284 & 12{,}809 & $9.98\times$ & 93.7\%\\
\texttt{collatz} &  256 & 9{,}637 & 26{,}601 & $2.76\times$ & 68.3\%\\
\texttt{reduce}  & 1024 & 6{,}023 &  4{,}363 & $0.72\times$ & 39.8\%\\
\bottomrule
\end{tabular}
\end{table}

%==============================================================================
\section{Floating-Point Extension}\label{sec:fp}
%==============================================================================
The base engine is integer-only. It is extended with FP32 and FP16 while keeping
the same SIMT structure: the extension is a per-lane execute unit and a second
per-lane register file, not a new pipeline. Each lane gains a compact
fixed-latency FP unit beside its integer ALU, and a second register file holds the
32 floating-point registers in distributed RAM, addressed by \{warp, register\}
exactly like the integer VRF, with an independent write port so an FP result and
an integer load can retire together. The unit implements add, subtract, multiply,
the fused multiply-add in all four sign variants, sign-injection, min/max, the
ordered compares, integer$\leftrightarrow$float and FP32$\leftrightarrow$FP16
conversion, the bit-moves, and classify, in both precisions. Rounding is
round-to-nearest-even per IEEE~754~\cite{ieee754} and subnormals flush to zero,
keeping each lane small.

\textbf{Half precision via widen--compute--narrow.} A 16-bit half lives in a
32-bit register NaN-boxed, the upper 16 bits all ones; a mis-boxed value reads as
a canonical NaN per the RISC-V convention~\cite{riscv}. For an FP16 operation the
unit widens the operand exactly to FP32, runs the single-precision datapath, and
rounds back. This is correct rather than approximate: because the FP32
intermediate carries a 24-bit significand and $24\ge 2\cdot11+2$, rounding to FP32
then to FP16 equals rounding directly to FP16~\cite{figueroa}, so FP16 add,
subtract, multiply, FMA, and the conversions are correctly single-rounded. Half
precision thus reuses the verified single-precision logic almost entirely, adding
only widen, narrow, and box steps and, as Fig.~\ref{fig:fpthr} shows, no extra
cycles.

\textbf{Fused multiply-add.} The FMA computes $\pm(a\cdot b)\pm c$ with a single
rounding~\cite{muller}, so it cannot be built by chaining the multiplier and the
adder. The unit forms the exact 48-bit product, anchors it in a wide fixed-point
accumulator, aligns the addend while capturing a sticky bit, and normalizes and
rounds once. When the addend out-ranges the product beyond the rounding window the
product is provably below half a unit in the last place, yielding the addend
exactly and bounding the alignment shifter. Section~\ref{sec:fppa} pipelines this
chain for timing closure.

\textbf{Multi-cycle divide and square root.} Division and square root produce one
quotient or root bit per cycle by a digit recurrence~\cite{ercegovac} and are the
engine's only multi-cycle operations. Because such a core is comparatively large,
the engine has a single shared instance: a warp issuing a divide or square root
has its lanes' operands captured and is parked on a stall scoreboard---the same
park-and-resume mechanism the memory engine uses---while the active lanes are
sequenced through the shared core one at a time and the scheduler issues other
warps onto the idle datapath. Section~\ref{sec:fppa} quantifies that trade.

\textbf{Verification.} Each unit is verified standalone against a DPI-C IEEE-754
reference: FP32 against the host's correctly-rounded \texttt{float} operations
including \texttt{fmaf} and \texttt{sqrtf}, FP16 against a \texttt{double}-based
reference cross-checked with \texttt{\_Float16}. Over random vectors spanning the
product-dominant, balanced (cancellation), and addend-dominant regimes, plus
directed infinity, NaN, zero, flush, overflow, divide-by-zero,
square-root-of-negative, mis-boxed-operand, and conversion corners, the pipelined
unit passes $96{,}066$ checks and the iterative unit a further $20{,}023$:
$116{,}089$ bit-exact comparisons, zero mismatches.

\textbf{Throughput and application kernels.} The FP unit is pipelined
(Section~\ref{sec:fppa}); an FP instruction commits a fixed number of cycles after
issue and the issuing warp parks a single slot until it does, a latency SIMT
interleaving hides on streaming work. Fig.~\ref{fig:fpthr} plots throughput
against problem size for streaming add and multiply-add in both precisions: the
ramp matches the integer suite and saturates near 7 work-items per cycle at 100\%
utilization, the FP16 points falling exactly on the FP32 curves because half
precision shares the pipelined datapath.

\begin{figure}[t]
\centering
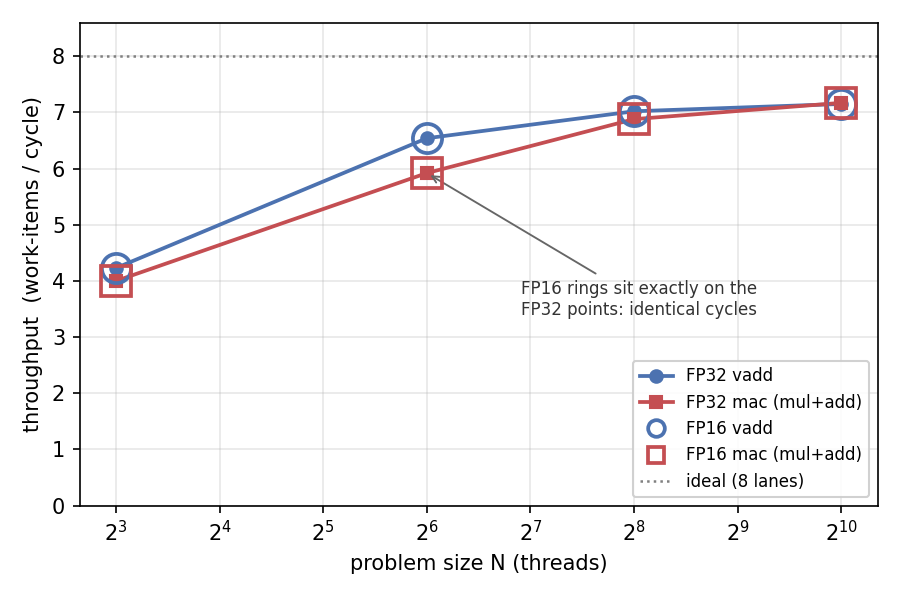
[picture p4: docs/figs/fp_throughput.png]

\caption{Floating-point throughput versus problem size for streaming add and
multiply-add kernels. The hollow FP16 markers sit exactly on the FP32 curves
because both precisions use the same pipelined datapath.}
\label{fig:fpthr}
\end{figure}
Four bit-exact kernels at $N{=}256$ isolate two further effects. Streaming
\texttt{fsaxpy} ($\alpha A_i+B_i$) takes 419 cycles at 100\% utilization, its FP16
form 451. Against that baseline the iterative unit is plainly visible:
\texttt{fnorm} $=A_i/\sqrt{B_i}$ takes $2{,}396$ cycles, about $6\times$
\texttt{fsaxpy}, the price of correctly-rounded iteration. Divergence interacts
with the larger lane datapath: \texttt{fdot}'s cross-lane reduction ($1{,}991$
cycles) leaves one of eight lanes active during the collapse, at 45\% utilization,
so the absolute energy a mask-gated design saves grows with the FP-enlarged lane.

%==============================================================================
\section{Placed Timing Closure of the FP Datapath}\label{sec:fppa}
%==============================================================================
Floating point raises the accelerator from $30{,}088$ to $74{,}342$ LUTs
($2.5\times$), flip-flops from $4{,}590$ to $7{,}894$, and DSPs from 24 to 40, at
1.34~W. The increase is dominated by the common-case arithmetic unit---eight
per-lane copies of the add/multiply/FMA/convert datapath, the FMA largest among
them---not by the iterative divide/square-root cores, only 689 LUTs each or about
7\% of the design. The FMA is also the longest combinational chain: as a
single-cycle block its raw path is 16.2~ns (61~MHz), making it the bottleneck.

\textbf{A delay model, and what it predicts.} The steps below are predictions of
one model rather than independent attempts. Write the placed period of the FMA
path as $T_{\text{placed}} = T_{\text{logic}}/S + t_{\text{reg}} +
T_{\text{route}}(A_{\text{local}})$, with $S$ the stages the chain is split
across, $t_{\text{reg}}$ the register overhead, and $A_{\text{local}}$ the placed
density of the region holding that cone. Conventional sizing uses only the first
two terms: halving a 16.2~ns chain leaves 8.1~ns plus overhead, inside the 10~ns
budget, so two stages should suffice. That is the argument Step~1 applies and the
argument Step~1 falsifies. The third term is why---it does not shrink with $S$ and
follows \emph{local} density rather than total design size, yielding two opposite
testable predictions: removing logic from inside the congested lane should raise
\Fmax\ with the arithmetic untouched, whereas removing whole lanes should not.
Step~2 tests the first and the design-space point the second; the model earns its
place by predicting the negative result as well as the positive one.

Table~\ref{tab:fpclose} summarizes the placed utilization and frequency of every
step: Steps~1--3 are out-of-context runs at eight lanes, the DSE row trims to
four, and the final row is the complete system-on-chip implemented in-context with
full pin constraints. Fig.~\ref{fig:fpclosure} splits each placed critical path
into logic and routing delay; the routing share never drops below half.

\begin{figure}[t]
\centering

\caption{Placed critical path at each closure step, split into logic and routing
delay (worst path of each sign-off timing report, with the achieved \Fmax\ above
each bar). Every step is routing-dominated.}
\label{fig:fpclosure}
\end{figure}

\begin{table*}[t]
\caption{Placed post-route results across the timing-closure steps, the four-lane
DSE point, and the final deployable system-on-chip.}
\label{tab:fpclose}
\centering
\footnotesize
\setlength{\tabcolsep}{6pt}
\begin{tabular}{clrrrrrrrlr}
\toprule
\# & Configuration & Lanes & LUT & LUT\% & LUTRAM & FF & DSP & Power (W)
   & \multicolumn{1}{c}{\Fmax\ (MHz)} & LUT/lane$\cdot$MHz \\
\midrule
1 & Two-stage FMA               & 8 & 72{,}573 & 31.5 & 3{,}348 & 12{,}347 & 40 & 1.53 & \phantom{0}78.0 & 116.3 \\
2 & \quad + shared serial SFU   & 8 & 68{,}914 & 29.9 & 3{,}348 & 11{,}153 & 40 & 1.22 & \phantom{0}84.1 & 102.4 \\
3 & \quad + three-stage FMA     & 8 & 69{,}987 & 30.4 & 3{,}348 & 14{,}954 & 40 & 1.22 & \textbf{100.7} & \textbf{86.9} \\
\midrule
  & DSE point: four lanes       & 4 & 36{,}785 & 16.0 & 1{,}748 & \phantom{0}6{,}953 & 20 & 0.98 & \phantom{0}79.7 & 115.4 \\
\midrule
  & Deployable SoC (in-context) & 8 & 71{,}567 & 31.1 & 7{,}244 & 17{,}834 & 40 & 1.20 & \textbf{103.7} & \textbf{86.3} \\
\bottomrule
\end{tabular}

\vspace{3pt}
\begin{minipage}{0.90\textwidth}
\footnotesize
Target \texttt{xczu7ev} ($230{,}400$ LUTs, $460{,}800$ FFs, $1{,}728$ DSPs) at a
100~MHz constraint; every build uses zero block RAM. LUTRAM is the distributed-RAM
subset of the LUT column, including the shared memory in the SoC row. Placed
critical path by row: the FMA cone in rows~1, 2 and the DSE point; the VRF LUTRAM
read multiplexer in row~3; the FP control broadcast in the SoC row. The last
column is a normalized area-time product, LUT divided by peak lane throughput
(lanes $\times$ \Fmax), lower being better.
\end{minipage}
\end{table*}

\textbf{Step 1: two-stage FMA, 78~MHz.} Two stages is the minimum depth the
conventional sizing argument admits, so the closure starts there. The split point
is chosen by balance: the FMA accumulator (\texttt{mag}) boundary is the one cut
leaving product and alignment on one side, normalization and rounding on the
other, with comparable delay---an unbalanced cut is worth nothing because the
deeper stage sets the period. The warp pool absorbs the extra cycle with a
single-slot scoreboard (\texttt{W\_FPC}), the park-and-resume mechanism used for
memory and the SFU, so no new structural hazard arises. Timing-driven synthesis
with retiming cuts the FP logic depth to 5.3~ns, yet place-and-route closes at
12.8~ns (78~MHz), the critical path still the first FMA stage but now
routing-dominated at 7.4 of 12.8~ns (58\%) in wire delay. The sizing argument was
not wrong about the logic---5.3~ns is well inside the budget---it was incomplete:
in the FP-enlarged fabric ($2.5\times$ the integer LUTs across eight wide lanes)
the routing term exceeds the logic term, and no splitting reduces it.

\textbf{Step 2: confirming the diagnosis, 84~MHz.} The model says that removing
logic from inside the congested lane should raise \Fmax\ with the arithmetic
untouched. The divide/square-root cores are the ideal instrument: they sit inside
each lane, they are large at 689 LUTs each, and they are off the FMA path
entirely, so folding the eight of them into a single shared serial unit fed lane
by lane changes $A_{\text{local}}$ and nothing else. Sharing also carries its own
break-even. Serialization stretches a divide or square root by at most the lane
count, so if $r$ is the fraction of runtime a workload spends in these operations
with private units, sharing costs $1+(L-1)r$ in cycles and returns $1.078$ in
frequency: a net win whenever $r < 0.078/7 \approx 1.1\%$. The bound is
pessimistic, assuming none of the serialization is hidden when the parked warp
lets the scheduler issue three others. Against the measured mix the decision is
not close---the streaming kernels of Section~\ref{sec:fp} issue no divides or
square roots at all, and only \texttt{fnorm} pays, which is where its $6\times$
cost appears. The predicted frequency effect follows: sharing removes about
$3.7$k LUTs and $1.2$k flip-flops, drops power from 1.53 to 1.22~W, leaves the FMA
path structurally unchanged yet cuts its routing delay from 7.4 to 6.5~ns, raising
the placed maximum to 84~MHz and near-critical endpoints from $8.7$k to $3.2$k.
Same logic, less congestion, higher frequency; the area-time product improves from
116 to 102.

\textbf{Localizing the limit: the control experiment.} Step~2 alone cannot
separate the two readings of its own result---that congestion is local to the
lane, or merely that a smaller design routes better. The model distinguishes them,
predicting that cutting total area without cutting density around the FMA cone
buys nothing. The four-lane point (Table~\ref{tab:fpclose}, DSE row) does exactly
that: it halves the area, $36{,}785$ versus $68{,}914$ LUTs and 20 versus 40 DSPs,
yet reaches only 79.7~MHz, marginally \emph{below} the eight-lane 84.1~MHz, with
the router still reporting CLB congestion. The critical path is a single lane's
FMA cone, whose logic depth and locally dense 128-bit datapath are independent of
lane count; halving the lanes replicates that cone fewer times but packs the
smaller design into a denser region, giving the lone FMA no relief. The negative
result is the informative one: it rules out total area as the lever, and the
area-time product prices the trade without ambiguity, 115.4 at four lanes against
102.4 at eight, so eight lanes Pareto-dominates at equal frequency and twice the
throughput. What remains is the FMA microarchitecture itself.

\textbf{Step 3: closing 100~MHz with a three-stage FMA.} Acting on that finding,
the FMA is split across three stages---product, 128-bit align-and-add, and
normalize-and-round---so that no single stage carries the whole cone. The warp
pool absorbs the extra cycle with the same single-slot scoreboard, a two-cycle
writeback latency SIMT interleaving continues to hide. The added registers raise
flip-flops to $14{,}954$ while leaving LUTs ($69{,}987$), DSPs, power (1.22~W),
and the bit-exact results unchanged. Place-and-route now meets timing at 100~MHz
with $+0.071$~ns worst slack, tracing $78\rightarrow84\rightarrow100.7$~MHz and
the area-time product from 116.3 to 86.9, and the critical path moves off the FMA
onto the vector-register-file LUTRAM read multiplexer, the same structure bounding
the integer design (Section~\ref{sec:impl}). The FP datapath is no longer the
limiter, confirming that FMA logic depth---the lever the exploration
identified---was the true constraint.

That observation is also the stopping criterion. A fourth stage would subdivide a
cone that is no longer the longest path, so it cannot lower $T_{\text{placed}}$ at
all while still adding a cycle of writeback latency to every FP instruction.
Deeper pipelining stops paying exactly where the structure being pipelined stops
being critical---a bound set by the design rather than the budget.

\textbf{From out-of-context closure to a deployable SoC.} Closing the accelerator
out-of-context is not yet a chip. Integrated into \texttt{chip\_top} with the host
core and the eight-bank shared memory, the FP-enlarged SoC first places at only
82.5~MHz. The same model applies at a new site: the worst path is congestion-bound
through the warp scheduler's fetch--execute cloud, where fetch from asynchronous
LUTRAM, decode, register-file read, execute, and writeback all complete in one
combinational cycle, 82\% of the placed path routing on its two highest-fanout
broadcast nets. Registering FP operands at issue, replicating those nets, and
fully pipelining the DSP multiplies recover part of the gap (96.4~MHz).
The last also deepens the FP unit: \texttt{fmul} and the FMA need the same 48-bit
significand product, so it is computed once on a \emph{shared} $24\times24$ DSP
cascade, placing the product four cycles after the operands and making the
deployed unit five stages deep rather than three, the arithmetic untouched and
\texttt{W\_FPC} counting out the longer latency. Splitting the cloud itself with a
fetch/execute pipeline register---a per-warp in-flight bit preserves re-issue
semantics exactly---applies the latency-hiding argument at instruction grain: with
two or more runnable warps the pipeline stays full, at a cycle cost of at most
0.3\%. The full chip then places at 107.3~MHz unconstrained and, pin-constrained
for the ZCU104 with a warning-free design-rule check and no waivers, signs off at
$+0.360$~ns worst slack (103.7~MHz), $71{,}567$ LUTs (31\%), 40 DSPs, zero block
RAM, and 1.20~W: a deployable bitstream.

%==============================================================================
\section{Related Work}\label{sec:related}
%==============================================================================
\begin{table}[t]
\caption{Vortex per-core numbers next to the complete SIMTiX SoCs.}
\label{tab:related}
\centering
\footnotesize
\begin{tabular}{lccrrrr}
\toprule
Design & W$\times$L & FP & LUT & FF & BRAM & MHz\\
\midrule
Vortex~\cite{vortex}   & 4$\times$4 & FP32     & 21.5k & 32.7k & 131 & 233$^{\dagger}$\\
Vortex~\cite{vortex}   & 4$\times$8 & FP32     & 37.9k & 57.6k & 247 & 224$^{\dagger}$\\
Ventus~\cite{ventus25} & 1 SM       & FP32     & 329k\phantom{0} & 80.4k & 108 & ---$^{\S}$\\
SIMTiX, integer        & 4$\times$8 & ---      & 34.9k & \phantom{0}6.1k & 0 & 100$^{\ddagger}$\\
SIMTiX, FP             & 4$\times$8 & FP32/16  & 71.6k & 17.8k & 0 & 103.7$^{\ddagger}$\\
\bottomrule
\end{tabular}

\vspace{3pt}
\begin{minipage}{\columnwidth}
\footnotesize
W$\times$L denotes resident warps $\times$ lanes.
$^{\dagger}$ Synthesis estimate on an Intel fabric~\cite{vortex}, Table~3; each
core includes its L1 caches and shared memory. The demonstrated system runs at
200~MHz. $^{\S}$ One streaming multiprocessor without tensor core, Xilinx
VCU128~\cite{ventus25}; no FPGA frequency reported. $^{\ddagger}$ Post-route on
UltraScale+, complete SoC including host CPU, driver ROM, and shared memory,
against a 100~MHz target met with positive slack.
\end{minipage}
\end{table}
Open RISC-V GPGPU cores include Vortex~\cite{vortex}, a full OpenCL-capable
multi-core design, and Ventus~\cite{ventus,ventus25}, which maps GPGPU threads
onto the RISC-V vector extension and adds a tensor core; both target performance
and scale and are correspondingly large. MIAOW~\cite{miaow} implements the AMD
Southern Islands ISA as an FPGA soft GPGPU, but its memory subsystem---L2 cache,
on-chip network, and memory controller---is modeled behaviorally in C/C++ rather
than RTL, so it does not carry a complete design through an implementation flow.
Simty~\cite{simty} demonstrates generalized SIMT execution of the RISC-V ISA,
integer-only and reporting synthesis area on an Intel Cyclone~IV, and Nyuzi
(published as Nyami)~\cite{nyuzi} is a synthesizable vector GPGPU for graphics.

Table~\ref{tab:related} places SIMTiX next to the published FPGA numbers for these
designs: the complete SIMTiX SoC, host CPU, driver ROM, and shared memory
included, fits in the logic budget of roughly one Vortex core of equal warp and
lane geometry, and in under a quarter of one Ventus streaming multiprocessor. The
frequency columns are not directly comparable and we do not read the gap as a
speed deficit: the Vortex entries are pre-placement synthesis estimates on an
Intel fabric and the system demonstrated in~\cite{vortex} runs at 200~MHz, whereas
the SIMTiX entries are post-route and bounded by the 100~MHz target we constrain
to rather than a swept maximum. A pre-placement number says little about the
placed one---Section~\ref{sec:fppa} reports our FP design synthesizing to a 5.3~ns
logic depth yet closing at 12.8~ns placed---and that placed closure study is not
reported for the larger cores.

Two observations from that literature corroborate ours. Ventus reports the vector
register file as the largest block of its streaming multiprocessor, 54.4\% of
area~\cite{ventus25}; SIMTiX reaches the same structure from the timing side, its
read multiplexer bounding both the integer design and, once the FMA is pipelined,
the FP one. Ventus also measures 0.47, 0.40, and 0.32 instructions per cycle at 4,
8, and 16 threads, counting one warp-wide operation as one instruction; SIMTiX
averages 0.78 by that convention across Table~\ref{tab:speedup} (0.68--0.87).
These are not like-for-like---ours excludes the memory-hierarchy stalls that
dominate Ventus's, being taken under a single-cycle behavioral memory model---so
it bounds what the scheduler achieves, not what a cached system would. Open floating-point units such as FPnew~\cite{fpnew} offer
multiformat arithmetic as standalone IP; SIMTiX instead integrates a per-lane FP
datapath into the SIMT pipeline and studies its placed timing. Control-divergence
handling via reconvergence stacks is long studied~\cite{fung,tesla}; SIMTiX uses
the standard stack mechanism and reuses its mask for lane clock-gating.

%==============================================================================
\section{Conclusion}
%==============================================================================
SIMTiX shows that the full SIMT mechanism set fits in a compact RISC-V
accelerator running end-to-end through a real implementation flow, with a
distributed-RAM register file the key to making it small and fast on FPGA and a
per-lane unit adding FP32 and FP16 verified bit-exact over $116{,}089$ vectors.
The central result is a placed
timing-closure study driven by one delay model: the FP-enlarged fabric is
interconnect-bound, a limit diagnosed, confirmed by de-congestion, localized by a
control experiment the model predicts will fail, then closed at 100~MHz with a
three-stage FMA that moves the critical path onto the register-file read
multiplexer bounding the integer design, improving the area-time product by 25\%.
A fetch/execute pipeline carries the closure to the SoC, signed off at 103.7~MHz
with full pin constraints and a clean design-rule check at under 0.3\% cycle cost.
The broader lesson: on a design small enough to re-place in full, a frequency
limit can be named, tested against a prediction that could have failed, and
removed---a loop a synthesis-only estimate cannot close.

%==============================================================================
%----- REQUIRED BY THE VLSID CFP: "You must explicitly declare the use of AI in
%----- the acknowledgments section of your manuscript." The declaration is
%----- required in the SUBMITTED (double-blind) version, so it must stay outside
%----- the \ifanon guard. Only identifying thanks (funding, colleagues) belong in
%----- the \else branch, which is empty for now.
\section*{Acknowledgment}
%==============================================================================
Per the conference policy on artificial intelligence, the authors declare that a
large language model (Anthropic Claude) assisted with preparing this manuscript
and with supporting build and analysis scripting. The RTL and testbench code, and
all design and experimental decisions, were the authors' own; every reported
result was produced by the tools named in the text and checked by the authors, who
take full responsibility for this paper.
\ifanon\else
%----- Camera-ready only: funding and personal acknowledgments go here.
\fi

%==============================================================================
\begin{thebibliography}{99}
\bibitem{vortex} B.~Tine, K.~P.~Yalamarthy, F.~Elsabbagh, and H.~Kim,
``Vortex: Extending the RISC-V ISA for GPGPU and 3D-Graphics,'' in
\emph{Proc. IEEE/ACM MICRO}, 2021.
\bibitem{ventus} F.~Zhang \emph{et al.}, ``Ventus: a RISC-V based GPGPU,''
open-source project, 2022.
\bibitem{ventus25} J.~Li \emph{et al.}, ``RISC-V-Based GPGPU With Vector
Capabilities for High-Performance Computing,'' \emph{IEEE Trans. VLSI Syst.},
vol.~33, no.~8, pp.~2239--2252, Aug. 2025.
\bibitem{miaow} R.~Balasubramanian \emph{et al.}, ``Enabling GPGPU Low-Level
Hardware Explorations with MIAOW: An Open-Source RTL Implementation of a GPGPU,''
\emph{ACM Trans. Archit. Code Optim.}, vol.~12, no.~2, 2015.
\bibitem{simty} S.~Collange, ``Simty: Generalized SIMT execution on RISC-V,''
in \emph{Workshop on Computer Architecture Research with RISC-V (CARRV)}, 2017.
\bibitem{nyuzi} J.~Bush, P.~Dexter, T.~N.~Miller, and A.~Carpenter,
``Nyami: a synthesizable GPU architectural model for general-purpose and
graphics-specific workloads,'' in \emph{Proc. IEEE ISPASS}, 2015.
\bibitem{fung} W.~W.~L.~Fung, I.~Sham, G.~Yuan, and T.~M.~Aamodt,
``Dynamic Warp Formation and Scheduling for Efficient GPU Control Flow,'' in
\emph{Proc. IEEE/ACM MICRO}, 2007.
\bibitem{tesla} E.~Lindholm, J.~Nickolls, S.~Oberman, and J.~Montrym,
``NVIDIA Tesla: A Unified Graphics and Computing Architecture,''
\emph{IEEE Micro}, vol.~28, no.~2, 2008.
\bibitem{aamodt} T.~M.~Aamodt, W.~W.~L.~Fung, and T.~G.~Rogers,
\emph{General-Purpose Graphics Processor Architectures}. Morgan \& Claypool,
2018.
\bibitem{hennessy} J.~L.~Hennessy and D.~A.~Patterson, \emph{Computer
Architecture: A Quantitative Approach}, 6th ed. Morgan Kaufmann, 2017.
\bibitem{gpgpusim} A.~Bakhoda \emph{et al.}, ``Analyzing CUDA Workloads Using a
Detailed GPU Simulator,'' in \emph{Proc. IEEE ISPASS}, 2009.
\bibitem{gpuwattch} J.~Leng \emph{et al.}, ``GPUWattch: Enabling Energy
Optimizations in GPGPUs,'' in \emph{Proc. ACM/IEEE ISCA}, 2013.
\bibitem{fpnew} S.~Mach, F.~Schuiki, F.~Zaruba, and L.~Benini, ``FPnew: An
Open-Source Multiformat Floating-Point Unit Architecture for Energy-Proportional
Transprecision Computing,'' \emph{IEEE Trans. VLSI Syst.}, vol.~29, no.~4,
pp.~774--787, 2021.
\bibitem{riscv} A.~Waterman and K.~Asanovi\'c, ``The RISC-V Instruction Set
Manual, Volume I: Unprivileged ISA,'' RISC-V International, 2019.
\bibitem{riscvvector} RISC-V International, ``RISC-V ``V'' Vector Extension,
Version 1.0,'' specification, 2021.
\bibitem{ieee754} IEEE, ``IEEE Standard for Floating-Point Arithmetic,''
\emph{IEEE Std 754-2019}, 2019.
\bibitem{muller} J.-M.~Muller \emph{et al.}, \emph{Handbook of Floating-Point
Arithmetic}, 2nd ed. Birkh\"auser, 2018.
\bibitem{ercegovac} M.~D.~Ercegovac and T.~Lang, \emph{Digital Arithmetic}.
Morgan Kaufmann, 2004.
\bibitem{figueroa} S.~A.~Figueroa, ``When is double rounding innocuous?,''
\emph{ACM SIGNUM Newsletter}, vol.~30, no.~3, pp.~21--26, 1995.
\bibitem{verilator} W.~Snyder, ``Verilator,'' Veripool,
\url{https://www.veripool.org/verilator}.
\end{thebibliography}

\end{document}
