Krishna-Gorai/simtix/docs/figs/simtix_datapath_tikz.pdf

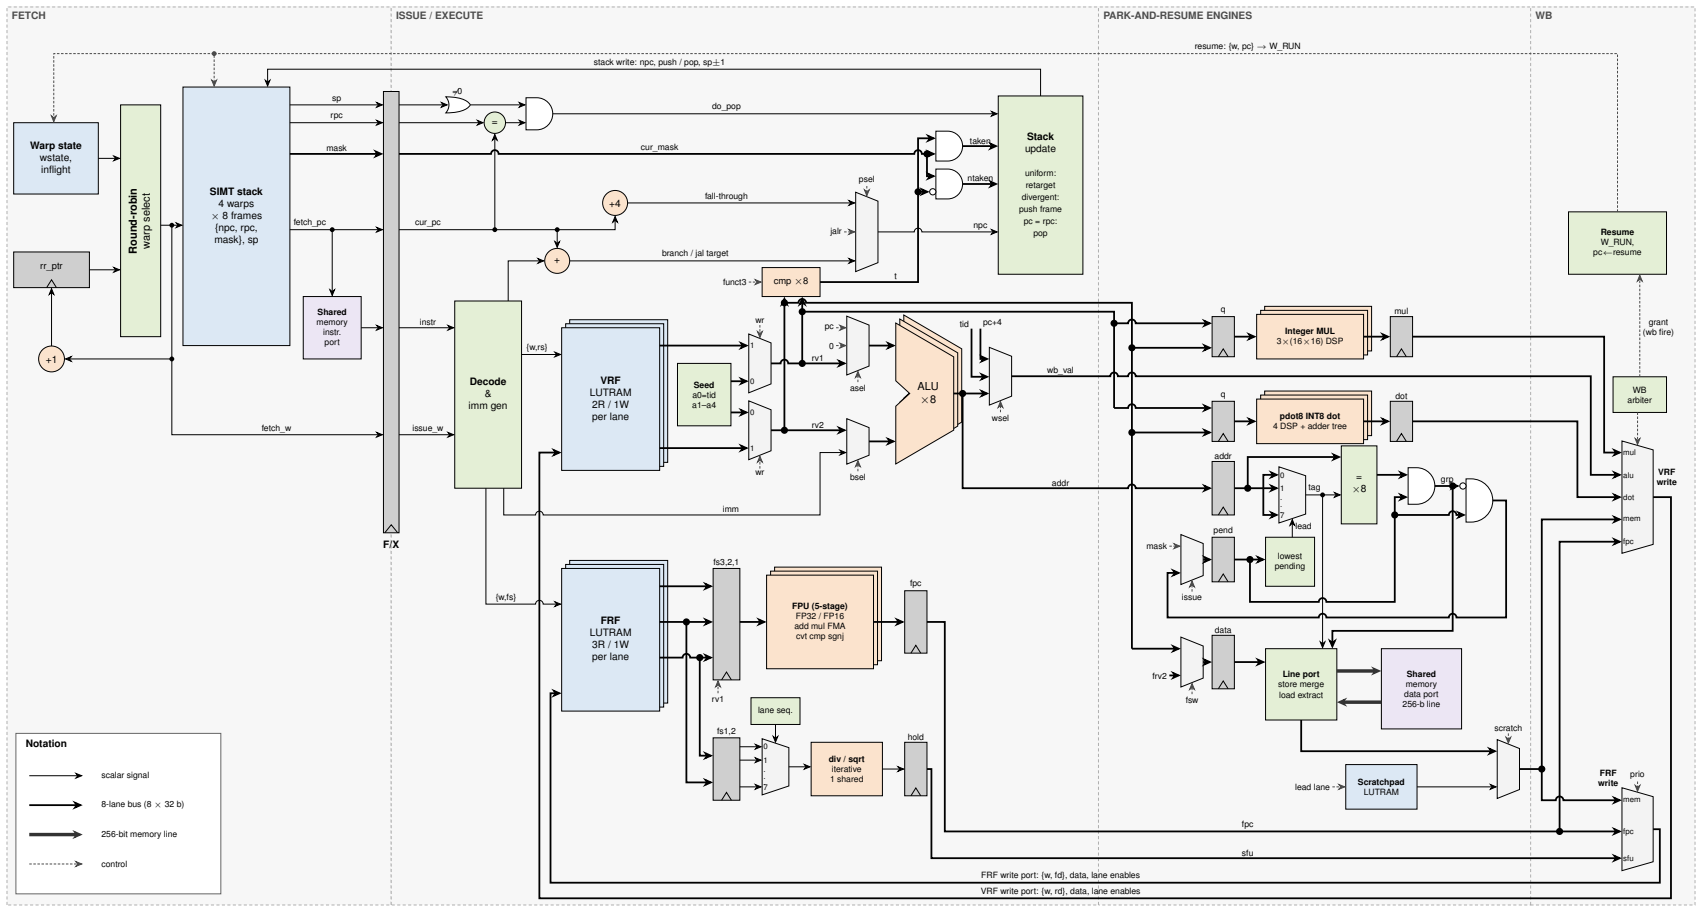
[picture p8: page 1]
FETCH; ISSUE / EXECUTE; PARK-AND-RESUME ENGINES; Warp state wstate, inflight; rr_ptr; Round-robin warp select; SIMT stack 4 warps × 8 frames {npc, rpc, mask}, sp; Shared memory instr. port; Decode & imm gen; VRF LUTRAM 2R / 1W per lane; FRF LUTRAM 3R / 1W per lane; Seed a0=tid a1–a4; ALU ×8; cmp ×8; Stack update; uniform: retarget divergent: push frame pc = rpc: pop; lane seq.; div / sqrt iterative 1 shared; Integer MUL 3×(16×16) DSP; lowest pending; Line port store merge load extract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

stack write: npc, push / pop, sp±1

branch / jal target

pdot8 INT8 dot
4 DSP + adder tree

FPU (5-stage)
add mul FMA
cvt cmp sgnj

256-bit memory line

FRF write port: {w, fd}, data, lane enables
VRF write port: {w, rd}, data, lane enables

## How the datapath operates, step by step

Block names are in bold, signal names as signal, both exactly as labelled in the figure. The steps follow one instruction from fetch to write-back, then the side engines, memory and write-back.

### 0 The big picture

SIMTiX runs a grid of N threads. Threads are grouped into warps of 8; the 8 threads of a
warp are the 8 lanes and execute the same instruction in lockstep, each on its own data.
Four warps are resident at once (4 warp slots). All four share one fetch/decode path, one ALU row (×8 lanes) and one memory port, and take turns cycle by cycle.
The datapath has four regions, left to right:
- Fetch picks a warp and reads its next instruction.
- Issue / execute decodes it, reads registers, runs the ALU and resolves branches in one cycle.
- Park-and-resume engines hold long operations (multiply, dot product, floating point, divide, memory). The warp waits there (parks) while the other warps keep issuing: this is how SIMTiX hides latency.
- Write-back decides which result writes the register files each cycle and wakes (resumes) the warp.
Each warp slot is in one state (wstate): W_EMPTY, W_RUN, parked in W_MEM / W_FPC / W_SFU / W_MUL / W_DOT, or W_DONE.

### 1 Launch: filling the warp slots

The host CPU writes the kernel PC, three base pointers and N through memory-mapped registers and sets GO. The pool latches these values and computes the number of warps, ⌈N/8⌉. Every cycle in which a slot is free (W_EMPTY or W_DONE) and warps remain, the next warp is placed in that slot:
- its base thread id is warp × 8 (used by Seed for a0 = tid);
- the base frame of its SIMT stack gets npc = kernel PC, rpc = FFFF_FFFF (never reached, so the base frame is never popped) and a mask of the lanes with tid < N (the last warp may be partial);
- all its “written” bits are cleared, so every register reads its seed value;
- its state becomes W_RUN.
A slot is recycled as soon as its warp retires, so grids larger than 4 warps run without host help.

### 2 Fetch: choosing a warp

Warp state holds wstate and an inflight bit per slot. A warp is runnable when it is in W_RUN and has no instruction in the X stage. Round-robin warp select is a priority encoder that starts its search at slot rr_ptr and returns the first runnable warp as fetch_w. Starting after the last-fetched warp makes the choice fair: no warp can starve the others. +1 computes fetch_w+1, which becomes the new rr_ptr on the clock edge.

### 3 Fetch: reading the stack and the instruction

fetch_w addresses the SIMT stack. The warp’s top frame (index sp) supplies:
- fetch_pc: the PC of this warp’s next instruction;
- mask: which of the 8 lanes are active on this path;
- rpc: the join (reconvergence) PC of the current frame;
- sp: the frame index itself.
fetch_pc goes to the shared memory instruction port, which returns instr in the same cycle (asynchronous LUTRAM read).

### 4 The F/X pipeline register

On the clock edge F/X captures instr, fetch_w (renamed issue_w) and the top-frame values (renamed cur_pc, cur_mask, cur_rpc, cur_sp). The warp’s inflight bit is set. Splitting fetch from execute halves the longest combinational path; the price is that one warp can issue at most every other cycle. With two or more runnable warps, F and X work on different warps and one instruction still issues every cycle. X always resolves its instruction in one cycle. It either commits it, parks the warp on an engine, or does nothing (engine busy, or write port lost) so the warp simply fetches the same instruction again. Nothing is committed on a retry, so re-execution is harmless. inflight is cleared in every case.

### 5 Decode and register read

Decode & imm gen splits instr into opcode, rd, rs1, rs2, rs3, funct3 and funct7 and builds the sign-extended immediate imm (I, S, B, U or J format). It also produces the mux selects (asel, bsel, wsel, psel) and the instruction class (ALU, branch, jump, memory, MUL, DOT, FP, div/sqrt, ecall).
The read addresses are {w,rs} and {w,fs}: warp number (issue_w) concatenated with the register number. Each lane has its own LUTRAM bank, so the VRF (2 read ports) and FRF (3 read ports) deliver the value for all 8 lanes in parallel. FP16 values live NaN-boxed in the low half of FP registers.

### 6 Seed muxes: registers without a reset

A LUTRAM cannot clear 32 registers in one cycle, so registers are not cleared at launch. A per-register wr (written) bit is kept instead. Each of the two seed muxes, one per read port (rs1 and rs2), passes:
- the VRF value if wr = 1 (written since launch);
- otherwise the register’s Seed: a0 = thread id (base id + lane), a1–a4 = kernel arguments, anything else 0.
x0 always reads 0. The outputs are the operands rv1 and rv2, 8 lanes wide. The FRF has no seeds: an unwritten FP register reads 0.

### 7 Operand select and the ALU

Operand A mux (asel): rv1, pc (auipc) or 0 (lui). Operand B mux (bsel): rv2 or imm. ALU ×8 computes add, sub, and, or, xor, shifts and set-less-than in every lane. For loads and stores it computes the effective address, so its result also goes to the memory engine as addr.

### 8 Write-back value

Write-back value mux (wsel) chooses what a single-cycle instruction writes:
- the ALU result;
- pc+4, the link address of jal / jalr;
- tid, for csrr rd, tid.
The result wb_val goes to the VRF write arbiter. Lanes that are masked off, and writes to x0, never write.

### 9 Branch resolution per lane

cmp ×8 evaluates the branch condition selected by funct3 (beq, bne, blt, bge, bltu, bgeu) on rv1, rv2 in every lane, giving the 8-bit vector t.
- AND gives taken = t AND cur_mask: active lanes that take the branch.
- AND with inverted input gives ntaken = cur_mask AND NOT t: active lanes that fall through.
Inactive lanes are in neither set; they are waiting on another path.

### 10 Next-PC candidates

- +4: fall-through = cur_pc+4.
- +: branch / jal target = cur_pc+imm.
- jalr: rv1 of the lowest active lane + imm, bit 0 cleared (jumps through a register are assumed uniform).
Next-PC mux (psel) forms npc for uniform control flow. It chooses fall-through for ordinary instructions and not-taken branches, the target for taken branches and jal, and the jalr target for jalr.

### 11 Pop check: reaching the join point

A pushed frame ends when its lanes reach the frame’s join PC.
- ̸=0 (OR): OR of the 3 bits of cur_sp, true when the warp is inside a pushed frame (sp ̸= 0).
- =: compares cur_pc with cur_rpc.
- AND: both true gives do_pop.
When do_pop is set the instruction is not executed. The frame is popped (sp−1), and the frame below, whose PC is already the join PC and whose mask is the union of both paths, becomes the top. The warp continues there with all its lanes.

### 12 Stack update

Stack update receives taken, ntaken, npc and do_pop and writes the stack (stack write). The top frame of warp issue_w changes as follows:
- Ordinary instruction, jump, or uniform branch (taken equals cur_mask, or is 0): top npc
← npc.
- Divergent forward branch (an if, target > pc): top npc ← target (the join) with the full mask. A frame is pushed with npc = fall-through, mask = ntaken, rpc = target. The fall-through lanes run the if body first, then pop at the join.
- Divergent backward branch (a loop): top npc ← fall-through (the loop exit). A frame is pushed with npc = target, mask = taken, rpc = fall-through. The looping lanes run until each exits.
- Pop: sp ← sp−1.
Nesting is allowed up to 8 frames.

### 13 Example: if (tid & 1) x += 1000

The compiler computes t0 = tid & 1 and emits beqz t0, skip around the body, so the branch is taken by the even lanes. Writing lane masks as lane 7 . . . lane 0, for a full warp t = 01010101, so taken = 01010101 and ntaken = 10101010: the branch diverges. The top frame becomes {skip, full mask}, and a frame {body, 10101010, rpc = skip} is pushed. The odd lanes execute the body with the even lanes masked off (their writes are suppressed). At skip, pc = rpc, so the pop check fires and the warp continues from skip with all 8 lanes.

### 14 Parking on an engine

Long operations are not executed in X. If the needed engine is idle, X:
- copies the operands into that engine’s capture register q;

- records the destination register, the lane write enables (cur_mask and rd ̸= x0) and the resume PC (pc+4);
- sets the warp’s state to the engine’s W_ state.
The scheduler then fetches from the other warps. Capture is needed because rv1, rv2 and frv follow whichever warp is in X, and change next cycle. If the engine is busy, the warp stays W_RUN and retries. Each engine holds one operation at a time.

### 15 Integer multiply and pdot8

Integer MUL (RV32M mul): the low 32 bits of rv1×rv2 per lane. It is built from three 16×16 DSP products, aL·bL + ((aL·bH + aH·bL) ≪ 16), because the high product aH·bH does not affect the low 32 bits. The pipeline is fully registered and the result arrives 7 cycles after issue. pdot8 INT8 dot (custom-0 pdot8): each 32-bit operand holds four INT8 values. It computes the sum of the four byte products per lane (signed×signed, unsigned×unsigned, or signed×unsigned, selected by funct3) with four DSP multipliers and an adder tree, also in 7 cycles. Both results wait in their hold registers (mul, dot) for the VRF write port.

### 16 The FPU

The FRF operands frv3, frv2, frv1 (and rv1 for int-to-float and fmv.w.x) are captured. The FPU (5-stage) computes FP32 or FP16:
- add, sub, mul, fused multiply-add (one rounding);
- convert, compare, sign-inject, min/max, move, classify.
The result fpc is ready 5 cycles later. FP16 is widened to FP32, computed, and rounded back, which gives exactly the FP16 result. fpc goes to the FRF, or to the VRF for compares, fcvt.w and fmv.x.w.

### 17 div / sqrt: one shared core

Divide and square root are rare and large, so there is a single core instead of eight.
- The capture register holds frv1, frv2 of all lanes.
- The lane seq. (lane sequencer) steps lane through the active lanes.
- The lane mux (0 . . . 7) feeds that lane’s operands to div / sqrt. The core produces one quotient bit per cycle (26 iterations) or one root bit per cycle (37 iterations).
- Each lane’s result is stored in its slot of the hold register (sfu).
The latency is roughly (number of active lanes) × (26 or 37) cycles. This is acceptable because other warps keep running, and it saves 7 cores’ area and routing.

### 18 Memory engine: accepting a load or store

One memory instruction can be in flight. At issue the engine captures:
- addr of all 8 lanes into addr;
- store data into data, via the store-data mux (fsw: rv2 for sw/sh/sb, frv2 for fsw);
- cur_mask into pend, through the pending mux (issue): the lanes still to serve;
- size (funct3), destination register, and whether the access is to the scratchpad (scratch: address bits 31:30 = 01).

### 19 Memory engine: coalescing

The memory port moves one whole 32-byte (256-bit) line per cycle. Each cycle:
- Lowest pending picks the lowest-numbered pending lane, lead.
- The lead-lane mux (0 . . . 7) selects that lane’s address; its line tag (bits 31:5) is tag.
- = ×8 compares every lane’s line tag with tag, and AND with pend gives grp: all pending lanes on the same line.
- All grp lanes are served in this single transaction.
- AND (inverted input) computes pend AND NOT grp. It returns through the pending mux as the next pend.

The engine finishes when pend becomes 0. A contiguous access (A[tid], 8 words) costs 1 transaction; a fully scattered one costs up to 8.

### 20 Memory engine: line port, shared memory, scratchpad

Line port, for a store: places each grp lane’s data at its word and byte position in a 256-bit line and sets matching byte enables for sb, sh or sw. For a load: extracts each grp lane’s word (address bits 4:2), selects byte or halfword (bits 1:0) and sign- or zero-extends it. Shared memory data port: the 256-bit line interface to the 8-bank shared memory, one bank per word of the line, so a whole line is accessed in one cycle. Scratchpad: per-warp on-chip RAM (64 words per warp). It is single-ported, so it serves one lane (lead lane) per cycle and never touches the shared memory; reused data staged here saves line transac-tions. Result mux (scratch) delivers mem, the load result, to write-back. When the last lane is served, the warp is resumed at pc+4.

### 21 Write-back arbitration

Each register file has a single write port per lane, but several producers can finish in the same cycle. VRF write arbiter, priority highest first:
1. mem: loads, which cannot wait because the line is only present for one cycle;
2. fpc: FP results with an integer destination;
3. mul;
4. dot;
5. alu (wb_val).
FRF write arbiter: mem (flw), then sfu, then fpc. WB arbiter computes these selects (prio). An engine that loses keeps its result in its hold register and tries again next cycle. A losing single-cycle ALU instruction is squashed: nothing is written and the warp re-issues it next cycle, which gives the same result. The winner drives the VRF write port or FRF write port: {warp, register}, 8 lane values and 8 lane enables (only lanes active at issue write). The register’s wr bit is set, so from now on it reads the VRF instead of its seed.

### 22 Resume

When an engine’s result is granted the port (grant (wb fire)), Resume writes the warp’s resume PC (pc+4 of the parked instruction) into the top frame of its SIMT stack and sets its state back to W_RUN (resume). The warp is runnable again from the next cycle. The memory engine resumes its warp in the same way when its last lane has been served.

### 23 Retire and completion

ecall moves the warp to W_DONE and frees its slot for the next warp of the grid. When no warps remain to spawn and no slot is running or parked, the pool pulses done. The accelerator then records the kernel’s cycle count and sets STATUS.DONE for the host to read.

### 24 Latency summary

ALU, branch, jump 1 cycle in X
integer mul, pdot8 7 cycles
FPU | 5 cycles after capture
div / sqrt | ≈26 / 37 per active lane
load / store | 1 cycle per distinct line
scratchpad | 1 cycle per active lane
While one warp waits on any of these, the other resident warps keep the fetch and ALU path busy. This overlap of one warp’s wait with other warps’ work is the core idea of a SIMT machine.

## Connection reference: every block, its inputs, its outputs

Read a row as “this block receives these signals from these blocks, and sends these signals to these blocks”. Italic names are blocks; bold names are signals, as labelled in the figure.

Block | Inputs ← from | Outputs → to | Role in the datapath
Fetch (F)
Warp state | resume ← Resume; spawn, park and retire updates from the launch logic and the X stage | runnable → Round-robin warp select | Remembers what every warp slot is doing, so only warps that can make progress are fetched.
rr_ptr | fetch_w+1 ← +1 | rr_ptr → Round-robin warp select | Rotates the search start so every warp gets its turn.
+1 | fetch_w ← Round-robin warp select | → rr_ptr | Makes the warp after the one just fetched the first candidate next cycle.
Round-robin warp select | runnable ← Warp state; rr_ptr ← rr_ptr | fetch_w → SIMT stack (read address), F/X (becomes issue_w), +1 | Chooses the one warp that uses the shared fetch/decode/ALU path in the next cycle.
SIMT stack | fetch_w (read) ← Round-robin warp select; stack write ← Stack update; resume ← Resume | sp, rpc, mask, fetch_pc → F/X; fetch_pc → Shared memory instr. port | Holds each warp’s control flow: the PC and active-lane mask of every open path, so divergent lanes can run in turn and rejoin.
Shared memory instr. port | fetch_pc ← SIMT stack | instr → F/X | Supplies the kernel instruction for the selected warp.
F/X | instr, fetch_w, sp, rpc, mask, fetch_pc from the fetch stage | instr, issue_w → Decode; cur_sp → ̸=0; cur_rpc → =; cur_pc → =, +, +4; cur_mask → AND, AND (inverted input), lane write enables | Pipeline boundary: everything the X stage needs about the fetched warp, frozen for one cycle.

Issue / execute (X): decode, registers, ALU
Decode & imm gen | instr, issue_w ← F/X | {w,rs} → VRF; {w,fs} → FRF; imm → +, Operand B mux; asel, bsel, wsel, psel, funct3 → muxes and cmp ×8 | Turns the instruction bits into register addresses, an immediate, and the control settings of every mux.
VRF | {w,rs} ← Decode; VRF write port ← VRF write arbiter | two read values (all 8 lanes) → Seed muxes | Integer registers of all threads, one LUTRAM bank per lane.
Seed | warp base id, lane number, kernel arguments (latched at launch) | seed of rs1, seed of rs2 → Seed muxes | Supplies the launch value of a register not yet written.
Seed muxes (two, one per read port) | VRF data ← VRF; seed ← Seed; wr (written bit) | rv1, rv2 → Operand A/B muxes, cmp ×8, MUL and pdot8 captures; rv2 → Store-data mux; rv1 → FPU capture | Produce the true register value without ever clearing the VRF.
Operand A mux | rv1, pc, 0; asel ← Decode | → ALU input a | Selects rs1, the PC (auipc) or zero (lui).
Operand B mux | rv2, imm; bsel ← Decode | → ALU input b | Selects rs2 or the immediate.
ALU ×8 | operands ← Operand A/B muxes | result → Write-back value mux; addr → memory addr register | Integer arithmetic for all lanes; also the load/store address generator.
Write-back value mux | ALU result, pc+4, tid; wsel ← Decode | wb_val → VRF write arbiter (input alu) | Result of any single-cycle instruction.
Issue / execute (X): control flow
̸=0 (OR) | cur_sp (3 bits) ← F/X | → AND (pop) | True when the warp is inside a pushed (divergent) frame.
= (pop compare) | cur_pc, cur_rpc ← F/X | → AND (pop) | True when the path has reached its join PC.
AND (pop) | outputs of ̸=0 and = | do_pop → Stack update | Decides to pop the frame instead of executing.
+ | cur_pc ← F/X; imm ← Decode | branch / jal target → Next-PC mux | PC-relative target.
+4 | cur_pc ← F/X | fall-through → Next-PC mux | Next sequential PC (also the link value pc+4).
Next-PC mux | fall-through, jalr, branch / jal target; psel | npc → Stack update | The next PC for uniform control flow.
cmp ×8 | rv1, rv2 ← Seed muxes; funct3 ← Decode | t → AND, AND (inverted input) | Evaluates the branch condition separately in every lane.
AND (taken) | t; cur_mask ← F/X | taken → Stack update | Active lanes that take the branch.
AND (inverted input) | cur_mask; t (inverted) | ntaken → Stack update | Active lanes that fall through.
Stack update | taken, ntaken, npc, do_pop | stack write → SIMT stack (top channel) | Retargets, pushes (on divergence) or pops (at the join) the warp’s stack.
Floating point (beside the FRF)
FRF | {w,fs} ← Decode; FRF write port ← FRF write arbiter | frv3, frv2, frv1 → FPU capture; frv1, frv2 → div/sqrt capture; frv2 →
| | Store-data mux | Floating-point registers (FP32, FP16 NaN-boxed), 3 read ports for FMA.
FPU capture q | fs3, fs2, fs1 ← FRF; rv1 ← Seed mux | → FPU | Freezes the operands of the parked warp.
FPU (5-stage) | captured operands | → fpc hold | All FP arithmetic except div/sqrt.
fpc hold | FPU result | fpc → FRF write arbiter, VRF write arbiter | Keeps the result until a write port is granted.
div/sqrt capture q | fs1, fs2 ← FRF | lanes 0 . . . 7 → Lane mux | Freezes all lanes’ operands for the sequential core.
lane seq. | active mask of the parked warp | lane → Lane mux select, hold register slot | Walks the active lanes one by one.
Lane mux (0 . . . 7) | captured lanes; lane | → div / sqrt | Feeds one lane at a time into the single core.
div / sqrt | one lane’s operands | → hold | Iterative divide (26 steps) or square root (37 steps).
hold | div / sqrt result, slot lane | sfu → FRF write arbiter | Collects all lanes before one write-back.

Block | Inputs ← from | Outputs → to | Role in the datapath
Park-and-resume engines
MUL capture q | rv1, rv2 (rails) | → Integer MUL | Freezes the multiply operands.
Integer MUL | captured operands | → mul hold | 32×32 multiply, low word, 7 cycles.
mul hold | product | mul → VRF write arbiter | Waits for the VRF port.
pdot8 capture q | rv1, rv2 (rails) | → pdot8 INT8 dot | Freezes the packed INT8 operands.
pdot8 INT8 dot | captured operands | → dot hold | Sum of four INT8 products, 7 cycles.
dot hold | dot product | dot → VRF write arbiter | Waits for the VRF port.
Coalescing memory engine
addr register | addr ← ALU | lanes 0 . . . 7 → Lead-lane mux; all lanes → = ×8 | Per-lane addresses of the in-flight access.
Pending mux | mask (cur_mask) at issue; next pending ← AND (inverted input) | → pend | Starts with the active lanes, then removes served lanes.
pend register | ← Pending mux | pend → Lowest pending, AND → grp, AND (inverted input) | Lanes still to be served.
Lowest pending | pend | lead → Lead-lane mux select | Picks the lane whose line is served this cycle.
Lead-lane mux (0 . . . 7) | lane addresses; lead | tag → = ×8, Line port | The line address of this cycle’s transaction.
= ×8 | all lane addresses; tag | → AND → grp | Finds every lane on the same 32-byte line.
AND → grp | compare results; pend | grp → Line port, AND (inverted input) | Lanes coalesced into this transaction.
AND (inverted input) | grp (inverted); pend | → Pending mux | Removes the served lanes.
Store-data mux | rv2, frv2; fsw | → data register | Integer or FP store data.
data register | store data | → Line port | Per-lane store data of the in-flight access.
Line port | data; tag; grp; read line ← Shared memory | 256-bit line (address, data, byte enables) → Shared memory; load data
| | → Result mux | Merges stores into one line; extracts and sign-extends loads.
Shared memory data port | line address, write data, byte enables ← Line port | read line → Line port | The 8-bank shared memory, one 256-bit line per cycle (outside warp_pool).
Scratchpad | lead lane address and data | read data → Result mux | Per-warp on-chip RAM, one lane per cycle.
Result mux | line-port load data, scratchpad data; scratch | mem → VRF write arbiter, FRF write arbiter | Load result of the access.
Write-back
VRF write arbiter | mul, alu (wb_val), dot, mem, fpc; select ← WB arbiter | VRF write port → VRF (bottom channel) | One integer result per cycle; priority mem, fpc, mul, dot, alu.
FRF write arbiter | mem, fpc, sfu; prio | FRF write port → FRF (bottom channel) | One FP result per cycle; priority mem, sfu, fpc.
WB arbiter | results waiting in the hold registers | select → VRF write arbiter; grant (wb fire) → Resume | Grants the port; the loser waits (engine) or re-issues (ALU).
Resume | grant (wb fire) ← WB arbiter | resume → SIMT stack, Warp state (top channel) | Returns the parked warp to W_RUN at its resume PC.

## SIMTiX warp_pool datapath: blocks and signals

8 lanes (SIMT threads), 4 resident warps, RV32IMF + Zfh + custom pdot8. “Lane” = one of the 8 threads executed in lockstep; “×8” marks per-lane replicated hardware; a thick line carries one 32-bit value per lane.

Blocks: fetch
Warp state | Per warp slot: wstate (EMPTY, RUN, MEM, SFU, FPC, MUL, DOT, DONE) and inflight (warp has an instruction in the X stage).
rr_ptr | Round-robin pointer: the warp slot where the next fetch search starts.
+1 | Increments the fetched warp id to form the next rr_ptr.
Round-robin warp select | Priority encoder: the first warp from rr_ptr that is in W_RUN and not in flight.
SIMT stack | Per-warp reconvergence stack, 8 frames of {npc, rpc, mask} plus stack pointer sp. The top frame gives the warp’s PC and active mask.
Shared memory instr. port | Read port of the on-chip shared memory that returns the kernel instruction at fetch_pc (outside warp_pool).
F/X | Pipeline register between fetch and execute: instr, issue_w and the top-of-stack context.

Blocks: issue / execute
Decode & imm gen | Decodes the instruction, forms register-file read addresses and the immediate.
VRF | Integer vector register file: one LUTRAM bank per lane, 4 warps × 32 registers, 2 read and 1 write port.
FRF | Floating-point register file, same organisation, 3 read ports (FMA). FP16 values are NaN-boxed.
Seed | Launch values: a0 = thread id, a1–a4 = kernel arguments, others 0.
Seed mux (wr) | Reads the RAM if the register was written in this grid, else its seed value.

Operand A mux (asel) rv1, pc (auipc) or 0 (lui).
Operand B mux (bsel) rv2 or the immediate.
ALU ×8 | One 32-bit ALU per lane. Its result is also the load/store address.
Write-back value mux (wsel) | ALU result, pc+4 (jal/jalr link) or tid (csrr).
̸=0 (OR) | OR-reduction: cur_sp is non-zero (inside a pushed frame).
= (pop check) | cur_pc equals cur_rpc (reached the join point).
+ | Branch / jal target: cur_pc + imm.
+4 | Fall-through PC.
Next-PC mux (psel) | Fall-through, jalr target or branch / jal target.
cmp ×8 | Per-lane branch comparator (beq, bne, blt, bge, bltu, bgeu).
Stack update | Uniform branch: retarget the top frame. Divergent: push a frame so the two lane groups run in turn. pc = rpc: pop and reconverge.

Blocks: floating point (beside the FRF)
FPU (5-stage) | Per-lane pipelined FP32/FP16 unit: add, sub, mul, FMA, convert, compare, sign-inject, min/max, move, classify. Result 5 cycles after issue.
lane seq. | Lane sequencer: steps through the active lanes one at a time for the shared div/sqrt.
Lane mux (0 . . . 7) | 8:1 mux that feeds the selected lane’s captured operands to div/sqrt.
div / sqrt | One shared iterative divide / square-root core, about 26 (div) or 37 (sqrt) cycles per lane.

Blocks: park-and-resume engines
q (capture register) | Operands latched when the instruction issues and held while its warp is parked.
mul, dot, fpc, hold | Result hold registers: keep a finished result until its write port is granted.
Integer MUL | RV32M mul (low 32 bits) from three 16×16 DSP products, 7 cycles.
pdot8 INT8 dot | Custom-0 instruction: 4-way INT8 dot product, four DSP products and an adder tree.

Blocks: coalescing memory engine
addr, data, pend | Latched per-lane address, per-lane store data and pending-lane mask of the one memory instruction in flight.
Pending mux (issue) | Loads cur_mask at issue, afterwards pending AND NOT grp.
lowest pending | Priority encoder: the lowest-numbered pending lane (the lead lane).
Lead-lane mux (0 . . . 7) | 8:1 mux that selects the lead lane’s address. Its line tag is the line fetched this cycle.
= ×8 (tag compare) | Per-lane comparator: does this lane’s 32-byte line tag equal the lead tag?
AND → grp | Lanes both pending and on the lead line: served together in one transaction.
AND (inverted input) | Next pending mask = pending AND NOT grp.
Store-data mux (fsw) rv2 for sw/sh/sb, frv2 for fsw.
Line port | Merges the grp lanes’ store data into one 256-bit line with byte enables. Extracts and sign-extends each lane’s load.
Shared memory data port | 256-bit line port of the 8-bank shared memory (outside warp_pool).
Scratchpad | Per-warp on-chip LUTRAM, 64 words per warp at 0x4000_0000, served one lane per cycle.

Result mux (scratch) Load data from the line port or from the scratchpad. Blocks: writeback
VRF write arbiter | Priority mux onto the single VRF write port: mem, fpc (integer destination), mul, dot, ALU. A losing ALU write is squashed and the instruction re-issues.
FRF write arbiter | Priority mux onto the FRF write port: mem (flw), sfu, fpc.
WB arbiter | Computes the arbiter selects and grants the port to one engine.
Resume | A granted engine’s warp returns to W_RUN with its resume PC written to the stack.

Signals: fetch and control
runnable | Warps in W_RUN that are not in flight.
fetch_w | Warp chosen for fetch this cycle.
sp, rpc, mask | Top-of-stack pointer, reconvergence PC and active-lane mask of the fetched warp.
fetch_pc | Top-of-stack next PC: the instruction address.
instr | Fetched 32-bit instruction.
issue_w | Warp executing in the X stage.
cur_pc, cur_rpc, cur_sp, cur_mask | The X-stage copies of pc, rpc, sp and mask.
do_pop | Top frame has reached its join: pop it.
t | Per-lane branch condition from the comparators.
taken | Active lanes whose branch is taken (t AND cur_mask).
ntaken | Active lanes that fall through (cur_mask AND NOT t).
funct3 | Instruction field that selects the comparison.
fall-through | pc + 4.
branch / jal target | pc + immediate.
jalr | jalr target: rv1 of the lead lane + imm, bit 0 cleared.
npc | Next PC chosen by the next-PC mux.
psel | Next-PC select, from decode and the branch outcome.
stack write | Update of the SIMT stack: new npc, push or pop, sp ± 1.
resume | {warp, resume PC} of a warp whose engine result was written back. Sets W_RUN.

Signals: operands and results
{w,rs}, {w,fs} | Register-file read address: warp id and register number.
imm | Sign-extended immediate from decode.
wr | Register-written bit: selects RAM value over seed value.
rv1, rv2 | Integer source operands, one 32-bit value per lane.
frv1–3, fs1–3 | FP source operands (fs3 is the FMA addend).
pc, 0 | Constant inputs of operand A for auipc and lui.
asel, bsel, wsel | Operand and write-back mux selects, from decode.
pc+4, tid | Link value for jal/jalr, thread id for csrr.
wb_val | ALU / link / tid result for the VRF.
addr | Per-lane effective address (ALU result) of a load or store.
rv1 (FPU) | Integer source for fcvt.s.w and fmv.w.x.

Signals: engines and memory
mul, dot | Integer multiply and INT8 dot-product results.
fpc | FPU result (to the FRF, or the VRF for compares, fcvt.w and fmv.x.w).
sfu, hold | div / sqrt results, collected lane by lane.
lane | Lane currently in the shared div/sqrt core.
mask, issue | cur_mask loaded into the pending register when a memory instruction issues.
pend | Lanes of the in-flight memory instruction not yet served.
lead | Lowest pending lane: its line is served this cycle.
tag | Lead lane’s line address (address bits 31:5).
grp | Lanes on the lead line: one coalesced transaction.
fsw, frv2 | Store-data select and FP store data.
256-bit line | Line address, write data and byte enables to, and read line from, shared memory.
lead lane | Scratchpad address and data from the lead pending lane.
scratch | The access is in the scratchpad aperture (address bits 31:30 = 01).
mem | Load result, per lane.
Signals: writeback
mul, alu, dot, mem, fpc | VRF write arbiter inputs, highest priority first: mem, fpc, mul, dot, alu.
mem, fpc, sfu | FRF write arbiter inputs, highest priority first: mem, sfu, fpc.
prio | Write-port priority select.
grant (wb fire) | An engine’s result took the write port this cycle.
VRF / FRF write port | {warp, destination register}, per-lane data and per-lane write enables (masked-off lanes never write).

Warp states (wstate)
W_RUN | Runnable.
W_MEM | Parked on the memory engine.
W_FPC, W_SFU | Parked on the FPU or div/sqrt.
W_MUL, W_DOT | Parked on the multiplier or dot engine.
W_EMPTY, W_DONE | Free slot, or retired by ecall (slot can be refilled).
