Krishna-Gorai/simtix/docs/figs/fig_lane_detail.pdf

Warp slot 0
PC active mask SIMT stack state

Warp slot 1
PC active mask SIMT stack state

Warp slot 2
PC active mask SIMT stack state

Warp slot 3
PC active mask SIMT stack state
Round-robin scheduler: pick one W RUN warp that is not in flight | shared instruction fetch
F →X pipeline register | per-warp in-flight bit
Decode | one warp fills all eight lanes: one instruction + an 8-bit active mask are broadcast to every lane | the mask drives the per-lane clock enable

VRF
LUTRAM

FRF
LUTRAM

ALU
1 cycle

MUL
3 × DSP

DOT
4 × DSP

FPU
5 stages

WB

Lane 0

VRF
LUTRAM

FRF
LUTRAM

ALU
1 cycle

MUL
3 × DSP

DOT
4 × DSP

FPU
5 stages

WB

Lane 1

VRF
LUTRAM

FRF
LUTRAM

ALU
1 cycle

MUL
3 × DSP

DOT
4 × DSP

FPU
5 stages

WB

Lane 2

VRF
LUTRAM

FRF
LUTRAM

ALU
1 cycle

MUL
3 × DSP

DOT
4 × DSP

FPU
5 stages

WB

Lane 3

VRF
LUTRAM

FRF
LUTRAM

ALU
1 cycle

MUL
3 × DSP

DOT
4 × DSP

FPU
5 stages

WB

Lane 4

VRF
LUTRAM

FRF
LUTRAM

ALU
1 cycle

MUL
3 × DSP

DOT
4 × DSP

FPU
5 stages

WB

Lane 5

VRF
LUTRAM

FRF
LUTRAM

ALU
1 cycle

MUL
3 × DSP

DOT
4 × DSP

FPU
5 stages

WB

Lane 6

VRF
LUTRAM

FRF
LUTRAM

ALU
1 cycle

MUL
3 × DSP

DOT
4 × DSP

FPU
5 stages

WB

Lane 7

Shared serial Div / Sqrt SFU
one fp divsqrt core, walked over the active lanes

Coalescing memory engine
groups the lane addresses by 256-bit line

Scratchpad
64 words per warp, LUTRAM

Eight-bank on-chip shared memory (LUTRAM), one 256-bit line port park / resume: W MEM, W MUL, W DOT, W SFU, W FPC

Warp pool: four resident slots sharing one datapath

Per-lane blocks — identical in all eight lanes, replicated by a generate loop

VRF | integer register bank: distributed RAM, 1 write / 2 async read ports
FRF | FP register bank: distributed RAM, 1 write / 3 async read ports (fs1/fs2/fs3 feed the FMA)
ALU | single-cycle integer ALU — the only combinational execute unit
MUL | pipelined 32 × 32 multiplier: three 16 × 16 DSP48 sub-products + adder tree, 7 cycles
DOT | pdot8 INT8 engine: four signed 9 × 9 DSP48 products + registered adder tree, 7 cycles
FPU | five-stage FP32/FP16 datapath — panel (b)
WB | writeback arbiter — steers the result to the integer or the FP bank

Colour key

integer / control logic

floating point

storage (distributed RAM)

Shared, not replicated per lane: the divide/square-root core, the coalescing memory engine, the scratchpad, and the whole fetch/decode/issue front end.

A warp that issues to a multi-cycle unit parks on the score-board and frees the datapath, so the scheduler keeps issuing the other warps while that unit runs. This is what hides the 7-cycle MUL/DOT, the 5-cycle FPU, and the tens-of-cycles SFU latency.

## (a) Warp pool and lane array

Stage 0 (combinational): unpack NaN-box check exact FP16→FP32 widen | ADD front (exponent compare, align → add mag)
MUL front (exponent sum, special cases) | FMA front-A (alignment position, addend, special cases) | fsgnj / fmin / fmax / compare / convert / fclass a, b, c

siga q, sigb q — DSP AREG / BREG

prod1 = siga q × sigb q — MREG

prod2 — PREG

prod3 — the exact 48-bit product one 24 × 24 DSP cascade per lane — shared by siga, sigb fmul and the FMA

e[1] — registered stage-0 payload

e[2] — registered stage-0 payload

e[3] — registered stage-0 payload

e[4] — registered stage-0 payload a 4-deep delay line, in step with the product payload

the two chains advance together

Stage 2 (combinational, reads prod3 and e[4]): MUL normalize + round FMA 128-bit align + add → mag

Pipeline register 2

T

T +1

T +2

T +3

T +4

T +5

valid in

Stage 3 (combinational): ADD and FMA leading-zero normalize + round | FP32→FP16 narrow + NaN-box | final result mux

res — valid in cycle T +5; the issuing warp is parked on W FPC until then simt fpu — one instance per lane; FP32 and FP16 share one datapath

## (b) Inside one lane: the five-stage FP unit
