Krishna-Gorai/simtix/docs/paper/simtix_vlsid.pdf

# SIMTiX: A Compact SIMT Accelerator for RISC-V with a Pipelined FP32/FP16 Datapath

Anonymous Author(s)
Affiliation withheld for double-blind review

Abstract—We present SIMTiX, a compact Single-Instruction Multiple-Thread (SIMT) accelerator for RISC-V whose complete path—RTL, simulation, synthesis, place-and-route, and post-route gate-level sign-off—is carried out on a single workstation. Eight lanes grouped into four resident warps attach to a five-stage RISC-V host through a memory-mapped offload interface and implement the full SIMT mechanism set: warp scheduling with a background memory engine, address coalescing, a per-warp reconvergence stack, and an on-chip scratchpad. Placing the vector register file and the scratchpad in distributed RAM reduces LUT usage by 5.7× and closes 100 MHz timing. Every lane carries a pipelined floating-point unit covering FP32 and FP16 add, multiply, fused multiply-add, and iterative divide and square root, verified bit-exact against an IEEE-754 reference over 116,089 vectors; half precision reuses the single-precision datapath through NaN-boxed widen–compute–narrow at no cycle cost. The central result is a placed timing-closure study of this datapath on a Zynq UltraScale+ FPGA. The floating-point fabric is interconnect-bound: we diagnose the limit, confirm it by de-congestion, localize it to a single lane’s fused-multiply-add cone, and close 100 MHz with a three-stage unit that moves the critical path off the floating-point datapath. The complete system-on-chip signs off at 103.7 MHz as a deployable, pin-constrained bitstream with a warning-free design-rule check.
Index Terms—SIMT, GPGPU, RISC-V, hardware accelerator, floating-point, half precision, fused multiply-add, timing closure, FPGA, place-and-route.
I. INTRODUCTION

Graphics processing units execute thousands of scalar threads in lockstep groups called warps under a Single-Instruction Multiple-Thread (SIMT) model. The mechanisms that make this efficient—warp scheduling for latency hiding, memory coalescing, control-divergence handling, and on-chip scratchpads—are well documented for commercial GPUs [7], [8], but what they cost once placed and routed is not. Production GPUs are proprietary; open GPGPU cores such as Vortex [1] are powerful but large, and report pre-placement synthesis estimates; and small academic cores are often simulator-only or stop short of a real implementation flow. The result is that the physical behavior of the SIMT mechanism set—which structure actually bounds frequency, and why—is largely unreported.
This paper presents SIMTiX, a deliberately compact SIMT accelerator for RISC-V whose entire path, from RTL through bitstream and post-route gate-level sign-off, is carried out on a single workstation with free or widely available tools. Compactness here is a method rather than a goal. A design small enough to re-place and re-route in full, in hours, is one whose frequency limit can be attributed to a named structure and then tested by changing only that structure and re-running the flow—a controlled experiment that is impractical on a large core and unavailable in a simulator. SIMTiX implements the complete SIMT mechanism set, and every lane is extended with a pipelined floating-point unit. Its headline result is a placed timing-closure study showing that, once the lanes carry floating point, the design becomes interconnect-bound rather than logic-bound, and that 100 MHz is reached by attacking the per-lane fused multiply-add (FMA) microarchitecture, a lever identified through a measured diagnose–confirm–localize sequence.
Contributions.
- A SIMT accelerator (eight lanes, four resident warps) that implements the complete mechanism set—warp scheduling, coalescing, a reconvergence stack, and a scratchpad—in a design compact enough to carry through the entire RTL-to-bitstream flow, integrated with a five-stage RISC-V host as a self-contained system-on-chip (Sections II–III).
- An implementation result showing that moving the vector register file and the scratchpad into distributed RAM reduces LUT usage by 5.7× and closes 100 MHz timing, with an analysis of why the register-file read multiplexer, not the ALUs, dominates a naive SIMT datapath (Section III).
- A per-lane floating-point extension covering FP32 and FP16, in which half precision is obtained from the single-precision path via NaN-boxed widen–compute–narrow and shown to be correctly single-rounded, verified bit-exact over 116,089 vectors (Section V).
- A placed FPGA timing-closure study that diagnoses the floating-point design as interconnect-bound, confirms the diagnosis by de-congestion, localizes the limit to a single lane’s FMA cone, closes 100 MHz with a three-stage FMA, and carries the closure to the complete system-on-chip at 103.7 MHz with full pin constraints and a warning-free design-rule check (Section VI).

II. ARCHITECTURE AND PLATFORM
A SIMT machine groups scalar threads into warps that share one instruction stream and execute on a vector of lanes. SIMTiX uses a warp size equal to its lane count (WARP SIZE = NUM LANES = 8) with NUM WARPS = 4 warps resident, time-sharing a single fetch/decode/execute datapath; when one warp stalls on memory, the scheduler issues another and hides the latency.

Unlike a packed-SIMD vector unit such as the RISC-V “V” extension [13], where one instruction operates on a registerresident vector, SIMTiX keeps a scalar thread per lane with an independent program-counter abstraction managed by the reconvergence stack, so data-dependent control flow is handled in hardware rather than by masking in software.
Offload model. The host programs a command block over a memory-mapped (MMIO) interface—kernel PC, base pointers, and thread count N—writes a GO bit, and polls DONE. On GO the accelerator launches ⌈N/8⌉ warps, seeding each thread’s identifier and arguments through registers at spawn. Four mechanisms make up the platform.
Warp pool and scheduler. Four resident slots, each with its own PC, active mask, register-file partition, and reconvergence stack, share one datapath and one data port. A round-robin scheduler issues one runnable warp per cycle, and a background memory engine services a memory access while other warps’ compute instructions keep the datapath busy. Coalescing. The data port is one cache line wide (LINE WORDS = 8, 256 bits). The memory engine groups the active lanes’ addresses by line and spends one transaction per distinct line, so a contiguous warp access collapses to a single transaction and a fully scattered one costs up to eight. Reconvergence stack. Each warp owns a SIMT stack whose top-of-stack frame defines the live PC and active mask. A branch on which active lanes disagree pushes a frame so the two lane groups run in turn and reconverge at a join PC, supporting compiler-free single-sided if statements and divergent loops.
Scratchpad. A per-warp 64-word aperture serviced from on-chip RAM lets data reused across a warp’s lanes be staged once, cutting global traffic.
The active mask additionally drives a per-lane clock enable, so masked-off lanes are not clocked; the unused-lane fraction is dynamic energy that a divergence-aware design saves. From lane utilization measured in our own RTL counters, under a first-order equal-energy-per-lane-instruction model in the spirit of activity-based GPU power models [10], that saving reaches 22.5% of lane-datapath dynamic energy on a heavily divergent kernel. Every mechanism is instrumented with hardware counters and is therefore measured directly in RTL rather than estimated in a software model [9].

III. IMPLEMENTATION
SIMTiX is written in synthesizable SystemVerilog and integrated with a reused five-stage RV32I host into a self-contained chip (chip_top, Fig. 1) comprising the host core, a driver ROM, the accelerator, and an eight-bank on-chip shared memory. The host loads operands into shared memory, launches the accelerator, and reads results back, so the entire CPU→memory→accelerator→memory→CPU loop runs in hardware.
From flip-flops to LUTRAM. The first synthesis of the accelerator on a Zynq UltraScale+ (xczu7ev) consumed 170,868 LUTs, 74% of the device, at only 10% of its flip-flops. The cause is structural: a flip-flop vector register file

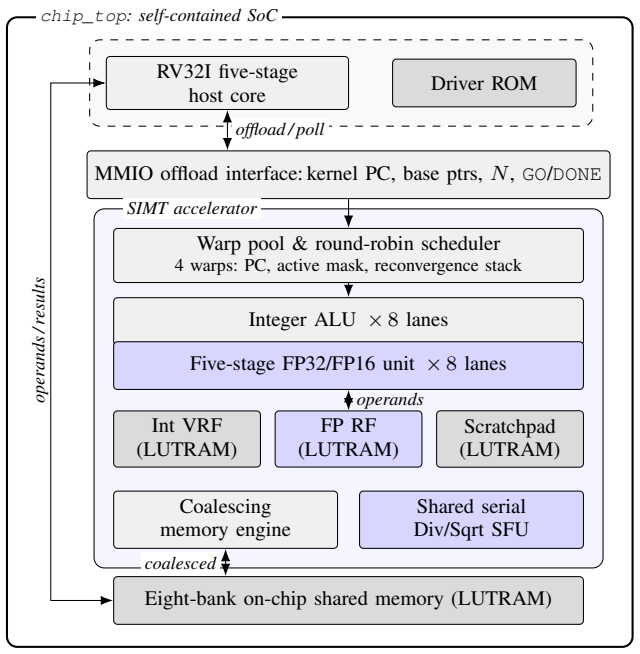
[picture p14: figure]
RV32I five-stage; host core; Driver ROM; Warp pool & round-robin scheduler; Integer ALU × 8 lanes; Five-stage FP32/FP16 unit × 8 lanes; Int VRF (LUTRAM); FP RF (LUTRAM); Scratchpad (LUTRAM); Coalescing memory engine; Shared serial Div/Sqrt SFU; Eight-bank on-chip shared memory (LUTRAM); operands / results; SIMT accelerator; chip_top: self-contained SoC; offload / poll; operands; coalesced

MMIO offload interface: kernel PC, base ptrs, N, GO/DONE

4 warps: PC, active mask, reconvergence stack

Fig. 1. SIMTiX system architecture. The five-stage RISC-V host drives the SIMT accelerator over a memory-mapped offload interface and exchanges operands and results through the eight-bank on-chip shared memory. Floating-point blocks are tinted blue; register files and the scratchpad live in distributed RAM (LUTRAM). The FP unit is drawn as deployed: the three-stage FMA that closes 100 MHz (Section VI) becomes five stages in the final chip once the significand multiply is fully pipelined onto DSP blocks.

(VRF) of 4 × 8 × 32 32-bit words is 32,768 registers read as vrf[warp][lane][reg] with both the warp and the register index variable, that is, a 128-to-1 multiplexer per lane per read port. That multiplexer fabric, not the ALUs, dominates area and sets the critical path. Re-expressing the VRF as one distributed-RAM bank per lane, and likewise the scratchpad, removes essentially all of those registers: LUTs fall 5.7× to 30,088 (13%), flip-flops to 4,590 (1.0%), and the design closes 100 MHz timing with positive slack at 0.81 W. The complete chip, taken through opt/place/phys-opt/route to a bitstream, meets all timing at 100 MHz and uses 34,850 LUTs (15.1%), 6,130 flip-flops, 24 DSP blocks, and zero block RAM at 1.09 W; the accelerator accounts for roughly 87% of the logic.
Verification ladder. Correctness is established at four levels: cycle-accurate RTL simulation with self-checking testbenches (Verilator [18]); behavioral simulation in the vendor GUI; full place-and-route with post-route timing sign-off; and post-implementation gate-level functional simulation of the routed netlist (UNISIM primitives). The benchmark suite below adds a fifth, breadth-oriented level.

IV. PLATFORM EVALUATION

The integer platform is characterized with six kernels chosen to stress distinct mechanisms: vadd (Ci = Ai + Bi
, streaming), saxpy (3Ai+Bi

, coalescing), fir (Ai+2Ai+1+Ai+2,

TABLE I
MEASURED CYCLES AND SPEEDUP OVER THE FIVE-STAGE RV32I HOST RUNNING IDENTICAL WORK.
Kernel | N | Accel. | CPU Speedup Lane util.
(cycles) (cycles)
vadd | 1024 | 1,413 | 13,322 | 9.43× | 100%
saxpy | 1024 | 1,669 | 16,394 | 9.82× | 100%
fir | 1024 | 2,053 | 14,345 | 6.99× | 100%
relu | 1024 | 1,284 | 12,809 | 9.98× | 93.7%
collatz | 256 | 9,637 | 26,601 | 2.76× | 68.3%
reduce | 1024 | 6,023 | 4,363 | 0.72× | 39.8%

stencil), relu (light divergence), collatz (heavy data-dependent divergence), and reduce (scratchpad reduction). Each is assembled from RISC-V source with a stock toolchain, run at N ∈ {8, 64, 256, 1024} threads, and checked bit-exact against a golden model. For an apples-to-apples speedup, every kernel is also written as a scalar loop and run on the same five-stage host in RTL.
Table I gives the headline platform result. Throughput ramps with occupancy through latency hiding and saturates near 6.7 work-items per cycle, below the eight-lane ideal because of the single shared data port. Streaming kernels reach 7– 10× over the scalar host; fir is lower (6.99×) because its stencil coalesces only partially; collatz achieves 2.76× as heavy divergence erodes, but does not eliminate, the SIMT advantage; and reduce falls below break-even at 0.72×, since a single-lane collapse on a single-ported scratchpad is slower than the scalar core and calls for a dedicated cross-lane reduction primitive. SIMTiX is parameterized in its lane and warp counts: a sweep over NUM LANES ∈ {4, 8, 16, 32} and NUM WARPS ∈ {2, 4, 8}, in which all twelve configurations elaborate and verify bit-exact, shows throughput scaling near-linearly with lanes (∼1.97× per doubling), while occupancy beyond two warps pays off only under realistic multi-cycle memory, not under the single-cycle behavioral model used here.
V. FLOATING-POINT EXTENSION

The base engine is integer-only. It is extended with floating point in both single (FP32) and half (FP16) precision while keeping the same SIMT structure: the extension is a per-lane execute unit and a second per-lane register file, not a new pipeline. Each lane gains a compact fixed-latency FP unit beside its integer ALU, and a second per-lane register file holds the 32 floating-point registers in distributed RAM, addressed by {warp, register} exactly like the integer VRF, with an independent write port so that an FP result and an integer load can retire together. The unit implements add, subtract, multiply, the fused multiply-add in all four sign variants, sign-injection, min/max, the ordered compares, integer↔float and FP32↔FP16 conversion, the bit-moves, and classify, in both precisions. Rounding is round-to-nearest-even per IEEE 754 [14] and subnormals are flushed to zero, a throughput-oriented choice that keeps each lane small.

Half precision via widen–compute–narrow. A 16-bit half lives in a 32-bit register NaN-boxed, with the upper 16 bits all ones; a mis-boxed value reads as a canonical NaN per the RISC-V convention [12]. For an FP16 operation the unit widens the operand exactly to FP32, runs the single-precision datapath, and rounds back to FP16. This is correct rather than approximate: because the FP32 intermediate carries a 24-bit significand and 24 ≥ 2·11+2, rounding first to FP32 and then to FP16 equals rounding directly to FP16 [17], so FP16 add, subtract, multiply, the fused multiply-add, and the conversions are correctly single-rounded. Half precision therefore reuses the verified single-precision logic almost entirely, adding only the widen, narrow, and box steps and, as Fig. 2 shows, no extra cycles.
Fused multiply-add. The FMA computes ±(a · b) ± c with a single rounding [15], so it cannot be built by chaining the multiplier and the adder. The unit forms the exact 48-bit product, anchors it in a wide fixed-point accumulator, aligns the addend while capturing a sticky bit, and normalizes and rounds once. When the addend out-ranges the product beyond the rounding window, the product is provably below half a unit in the last place, which yields the addend exactly and bounds the alignment shifter. The FMA has fixed latency and commits through the ordinary writeback path; Section VI describes how this combinational chain is pipelined for timing closure. Multi-cycle divide and square root. Division and square root produce one quotient or root bit per cycle by a digit recurrence [16] and are the engine’s only multi-cycle operations. Because such a core is comparatively large, the engine has a single shared instance: when a warp issues a divide or a square root, the engine captures all of its lanes’ operands and parks the warp on a stall scoreboard, then sequences the active lanes through the shared core one at a time. This is the same park-and-resume mechanism the memory engine uses, so the scheduler keeps issuing other warps onto the idle datapath meanwhile. At most one warp’s divide or square root is in flight, trading latency (k active lanes take about k times as long, hidden across warps) for the area saving quantified in Section VI.
Verification. Each unit is verified standalone against a DPI-C IEEE-754 reference: FP32 against the host’s correctly-rounded float operations, including fmaf and sqrtf, and FP16 against a double-based reference crosschecked with _Float16. Over random vectors spanning the product-dominant, balanced (cancellation), and addenddominant regimes, plus directed infinity, NaN, zero, flush, and overflow corners together with divide-by-zero, square-root-of-negative, mis-boxed-operand, and conversion cases, the pipelined unit passes 96,066 checks and the iterative divide/square-root unit a further 20,023, all bit-exact (Table II). End-to-end FP kernels then exercise the full warp pool: streaming add and multiply-add in each precision, a fused Ci = AiBi + Ci
, and Ci =

p
Ai/Bi with two dependent
multi-cycle operations per thread, all bit-exact to 1024 threads. Throughput and application kernels. The FP unit is pipelined (Section VI); an FP instruction commits a fixed

TABLE II
FLOATING-POINT OPERATION COVERAGE; EVERY OPERATION IS IMPLEMENTED AND CHECKED IN BOTH PRECISIONS.
Category | Operations (each in FP32 and FP16)
Arithmetic | fadd, fsub, fmul
Fused | fmadd, fmsub, fnmsub, fnmadd
Divide / root | fdiv, fsqrt (iterative, multi-cycle)
Sign / select | fsgnj{,n,x}, fmin, fmax
Compare | feq, flt, fle
Convert | float↔int (signed/unsigned), FP32↔FP16
Move / classify fmv.x._, fmv._.x, fclass

Bit-exact checks vs. IEEE-754 reference: 116,089 (0 mismatches)


Fig. 2. Floating-point throughput versus problem size for streaming add and multiply-add kernels. The hollow FP16 markers sit exactly on the FP32 curves because both precisions use the same pipelined datapath.

number of cycles after issue and the issuing warp parks a single slot until it does, a latency that SIMT interleaving hides on streaming work. Fig. 2 plots throughput against problem size for streaming add and multiply-add in both precisions. The latency-hiding ramp matches the integer suite and saturates near 7 work-items per cycle at 100% lane utilization, with the FP16 points lying exactly on the FP32 curves because half precision shares the pipelined datapath. Table III runs four toolchain-assembled FP kernels through the engine. Two effects stand out. The iterative divide/square-root unit is visible: fnorm = A/√
B takes about 6× the cycles of streaming fsaxpy, the cost of correctly-rounded iterative operations. Divergence also interacts with the now-larger lane datapath: fdot’s reduction leaves one of eight lanes active during the collapse, at 45% utilization, so the absolute energy a mask-gated design saves grows with the FP-enlarged lane.

VI. PLACED TIMING CLOSURE OF THE FP DATAPATH
Floating point raises the accelerator from 30,088 to 74,342 LUTs (2.5×), flip-flops from 4,590 to 7,894, and DSP blocks from 24 to 40 for the FP multipliers, at 1.34 W. The increase is dominated by the common-case arithmetic unit—eight per-lane copies of the add/multiply/FMA/convert datapath, with the fused multiply-add the largest single block—and not by

TABLE III
FP APPLICATION KERNELS AT N=256 (FP32 UNLESS NOTED), ALL VERIFIED BIT-EXACT.
Kernel | Computation | Cycles Gmem Lane util.
fsaxpy | αAi + Bi (fmadd) | 419 | 96 | 100%
fsaxpy16 | αAi + Bi (FP16) | 451 | 96 | 100%
fnorm | Ai/

√
| Bi (div + sqrt) | 2,396 | 96 | 100%
fdot | P
| l A8w+lB8w+l | 1,991 | 96 | 45%


Fig. 3. Placed critical path at each closure step, split into logic and routing delay (worst path of each sign-off timing report, with the achieved Fmax above each bar). Every step is routing-dominated.

the iterative divide/square-root cores, which synthesize to only 689 LUTs each, about 7% of the design. The FMA is also the longest combinational chain: as a single-cycle block its raw path is 16.2 ns (61 MHz), which makes it the frequency bottleneck.
Table IV summarizes the placed utilization and frequency of every step in the closure. Steps 1–3 are out-of-context runs holding the lane count at eight, the DSE row trims the design to four lanes, and the final row is the complete system-on-chip implemented in-context with full pin constraints after the fetch/execute split described at the end of this section. Fig. 3 plots the placed critical path at each step, split into logic and routing delay; the routing share never drops below half.
Step 1: two-stage FMA, 78 MHz. The FP unit is first pipelined into two stages, split at the FMA accumulator (mag) boundary. The warp pool absorbs the extra cycle with a single-slot scoreboard (W_FPC), the same park-and-resume mechanism used for memory and the SFU, so no new structural hazard arises and SIMT interleaving hides the latency. Timingdriven synthesis with retiming cuts the FP logic depth to 5.3 ns, yet place-and-route closes at 12.8 ns (78 MHz). The placed critical path is still the first FMA stage but is now routing-dominated, with 7.4 of 12.8 ns (58%) in wire delay, because in the FP-enlarged fabric (2.5× the integer LUTs across eight wide FP lanes) interconnect rather than logic depth has become the binding constraint.
Step 2: confirming the diagnosis, 84 MHz. If congestion is the limit, de-congesting the fabric should raise frequency with the logic unchanged. The eight per-lane divide/square-

TABLE IV
PLACED POST-ROUTE RESULTS ACROSS THE TIMING-CLOSURE STEPS, THE FOUR-LANE DSE POINT, AND THE FINAL DEPLOYABLE SYSTEM-ON-CHIP.
# | Configuration | Lanes | LUT | LUT% | LUTRAM | FF | DSP | Power (W) | Fmax (MHz)

1 | Two-stage FMA | 8 | 72,573 | 31.5 | 3,348 | 12,347 | 40 | 1.53 | 78.0
2 | + shared serial SFU | 8 | 68,914 | 29.9 | 3,348 | 11,153 | 40 | 1.22 | 84.1
3 | + three-stage FMA | 8 | 69,987 | 30.4 | 3,348 | 14,954 | 40 | 1.22 | 100.7
| DSE point: four lanes | 4 | 36,785 | 16.0 | 1,748 | 6,953 | 20 | 0.98 | 79.7
| Deployable SoC (in-context) | 8 | 71,567 | 31.1 | 7,244 | 17,834 | 40 | 1.20 | 103.7

Target xczu7ev (230,400 LUTs, 460,800 FFs, 1,728 DSPs) at a 100 MHz constraint; every build uses zero block RAM. LUT% is of the device LUT count; LUTRAM is the distributed-RAM subset of the LUT column and, in the SoC row, includes the eight-bank shared memory. Placed critical path by row: the FMA cone in rows 1, 2 and at the DSE point; the VRF LUTRAM read multiplexer in row 3; the FP control
| broadcast in the SoC row.

root cores are folded into a single shared serial unit fed lane
by lane. This removes about 3.7k LUTs and 1.2k flip-flops and drops power from 1.53 to 1.22 W; crucially it leaves the FMA critical path structurally unchanged yet cuts that path’s routing delay from 7.4 to 6.5 ns, raising the placed maximum to 84 MHz and reducing near-critical endpoints from 8.7k to 3.2k. Same logic, less congestion, higher frequency: a direct confirmation that interconnect, not logic depth, bounds this design.
Localizing the limit: frequency does not scale with fabric size. A natural question is whether trimming the FP fabric relieves congestion further. It does not. Placing the design at four lanes (Table IV, DSE row) halves its area, 36,785 versus 68,914 LUTs and 20 versus 40 DSP blocks, but reaches only 79.7 MHz, marginally below the eight-lane 84.1 MHz, and the router still reports CLB congestion. The critical path is a single lane’s FMA cone, whose logic depth and locally dense 128-bit datapath are independent of the lane count; halving the lanes replicates that cone fewer times but packs the smaller design into a denser region that gives the lone FMA no relief. The eight-lane configuration therefore Paretodominates the four-lane one, at equal frequency and twice the throughput, and identifies the true frequency lever as the FMA microarchitecture rather than the fabric size.
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
