Krishna-Gorai/simtix/docs/architecture.md

# SIMTiX architecture

This is the implementation deep-dive. It describes the RTL as it actually exists
(milestones M0–M8), down to signal names, so it can be read alongside the source.
For the high-level tour see the [README](../README.md); for the focused studies see
[docs/m7_energy.md](m7_energy.md) (lane clock-gating),
[docs/m8_lutram.md](m8_lutram.md) (register file in distributed RAM), and
[docs/m9_scratchpad.md](m9_scratchpad.md) (scratchpad in distributed RAM).

The whole SIMT engine lives in **one module, `rtl/accel/warp_pool.sv`** — the
scheduler, lanes, register file, reconvergence stack, memory engine and scratchpad
are tightly co-designed and share a single decode datapath and a single data port,
so they are implemented together rather than as separate blocks.

---

## 1. System view

The host is the reused 5-stage RISC-V core (`rtl/cpu/`), unmodified. Its
data-memory interface is the only attach point the accelerator needs:

```
cpu.MemWriteM  cpu.Funct3M  cpu.ALUResultM(addr)  cpu.WriteDataM   ->  bus
cpu.ReadDataM  <-  bus
```

`rtl/soc/soc_top.sv` performs a one-line **address decode** on `ALUResultM`:

- `addr <  MMIO_BASE` → the CPU's local data SRAM (`rtl/cpu/data_mem.v`)
- `addr >= MMIO_BASE` → the SIMTiX accelerator (`is_mmio = (ALUResultM >= MMIO_BASE)`)

The read-data return is muxed back the same way
(`ReadDataM = is_mmio ? accel_rdata : dram_rd`). This is exactly how a discrete GPU
is mapped into a host's physical address space, and it means a stock RISC-V program
drives the accelerator with ordinary `sw`/`lw` — no custom instructions.

The SoC boundary also exposes the host instruction-fetch port and the accelerator's
**shared-memory master ports** (kernel code via `imem`, data arrays via the
line-wide `dmem`), so the testbench (and, later, a real loader) own the memory
images.

---

## 2. MMIO register map

Base `MMIO_BASE = 0x8000_0000` (one 4 KB page). Word offsets:

| Offset | Name | R/W | Description |
|---|---|---|---|
| `0x00` | `KERNEL_PC` | W | byte address of the kernel's first instruction |
| `0x04` | `BASE_A` | W | base pointer, argument 0 |
| `0x08` | `BASE_B` | W | base pointer, argument 1 |
| `0x0C` | `BASE_C` | W | base pointer, argument 2 |
| `0x10` | `N` | W | total thread count (grid size) to launch |
| `0x14` | `CTRL` | W | bit0 = `GO` (write 1 to launch) |
| `0x18` | `STATUS` | R | bit0 = `DONE`, bit1 = `BUSY` |
| `0x1C` | `CYCLES` | R | cycle count of the last kernel (performance) |

`mmio_regs.sv` holds these; the `GO` write produces a one-cycle `go_pulse`.

---
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
