Krishna-Gorai/simtix/docs/figs/dse_kernels.png

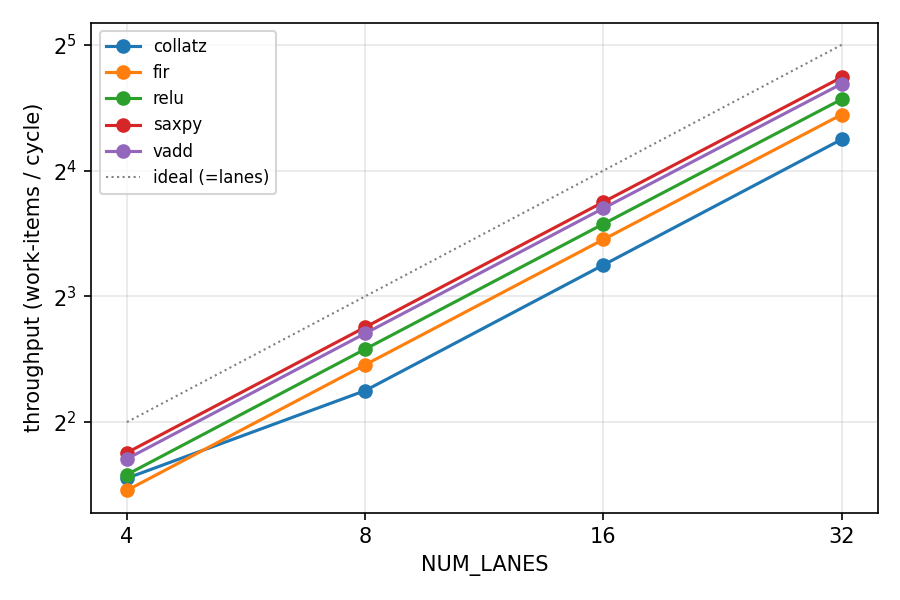
docs/figs/dse_kernels.png
