Krishna-Gorai/simtix/docs/figs/dse_throughput.png

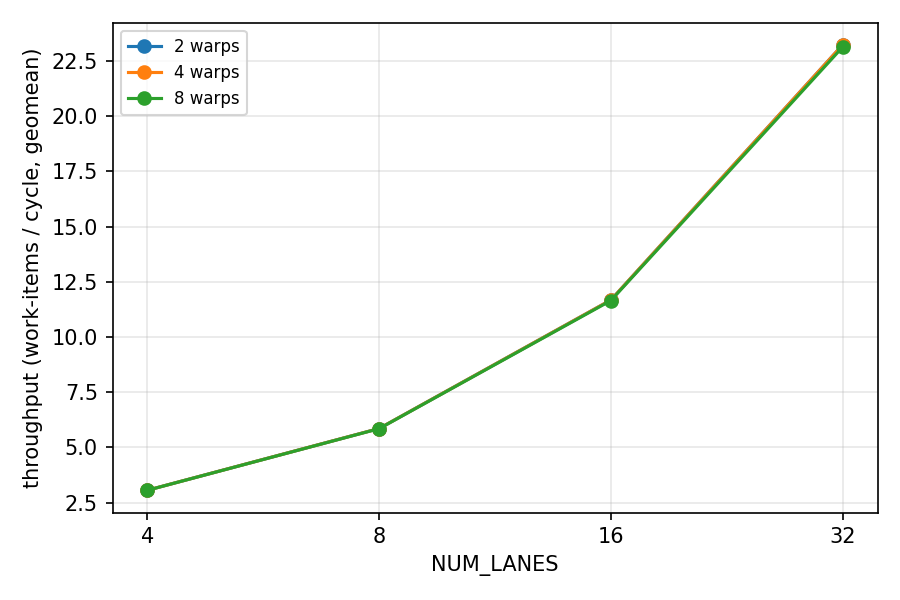
docs/figs/dse_throughput.png
