Krishna-Gorai/simtix/docs/figs/dse_warps.png

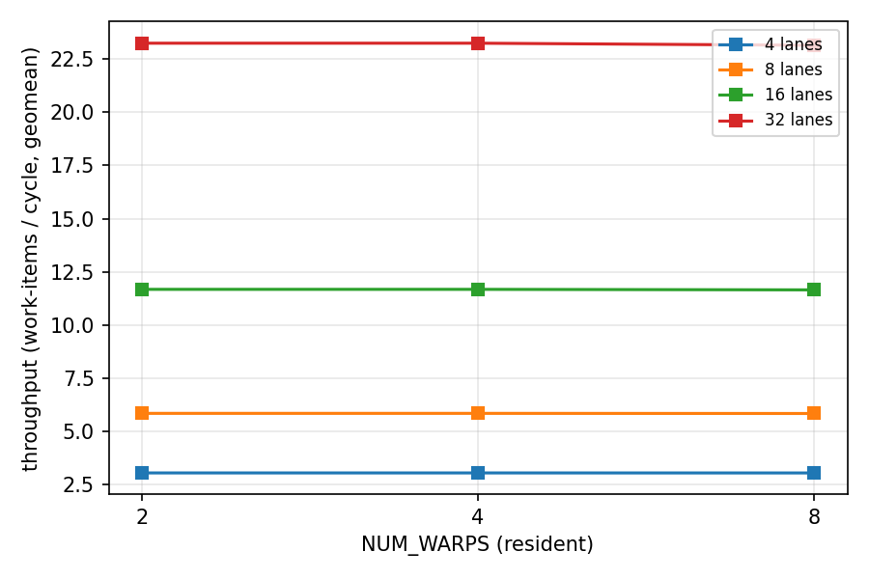
docs/figs/dse_warps.png
