Krishna-Gorai/simtix/docs/figs/fpk_energy.png

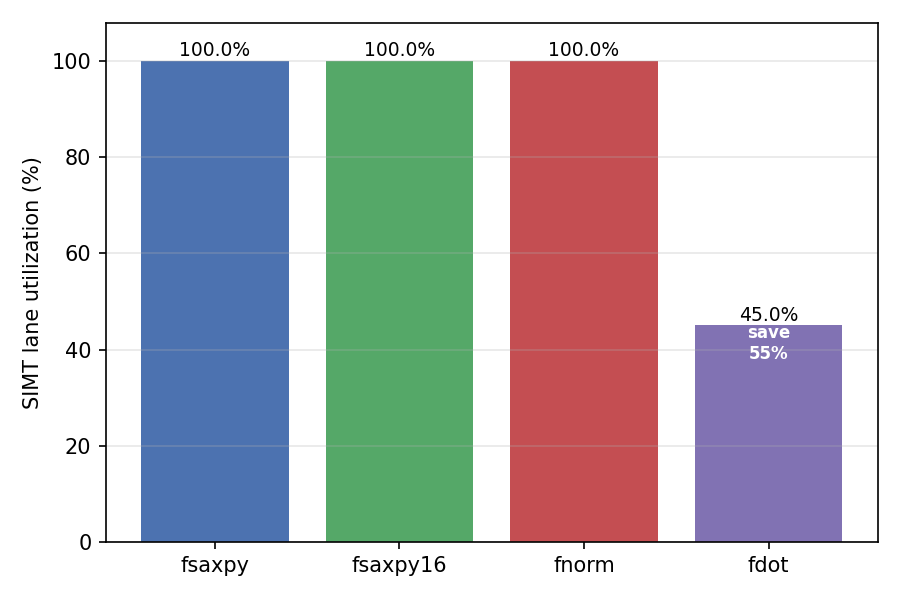
docs/figs/fpk_energy.png
