Krishna-Gorai/simtix/docs/figs/lanes_speedup.png

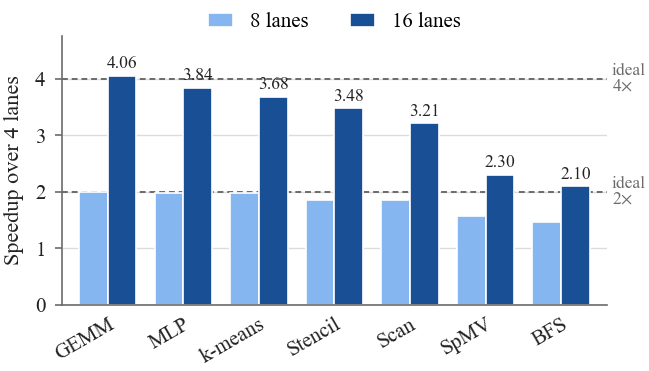
docs/figs/lanes_speedup.png
