Krishna-Gorai/simtix/docs/figs/laneutil.png

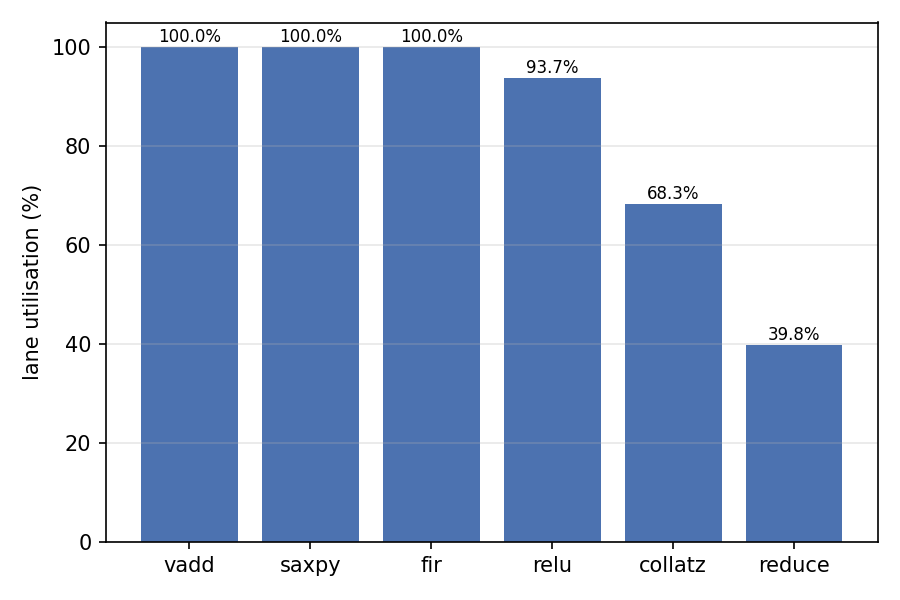
docs/figs/laneutil.png
