Krishna-Gorai/simtix/docs/figs/locality.png

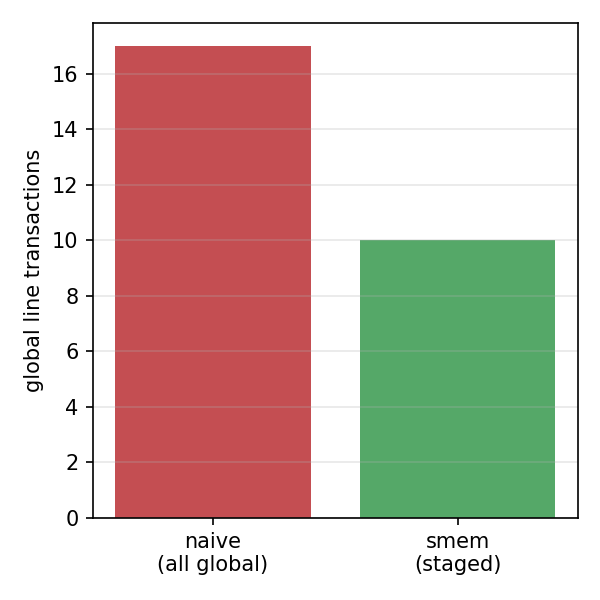
docs/figs/locality.png
