Krishna-Gorai/simtix/docs/figs/memtraffic.png

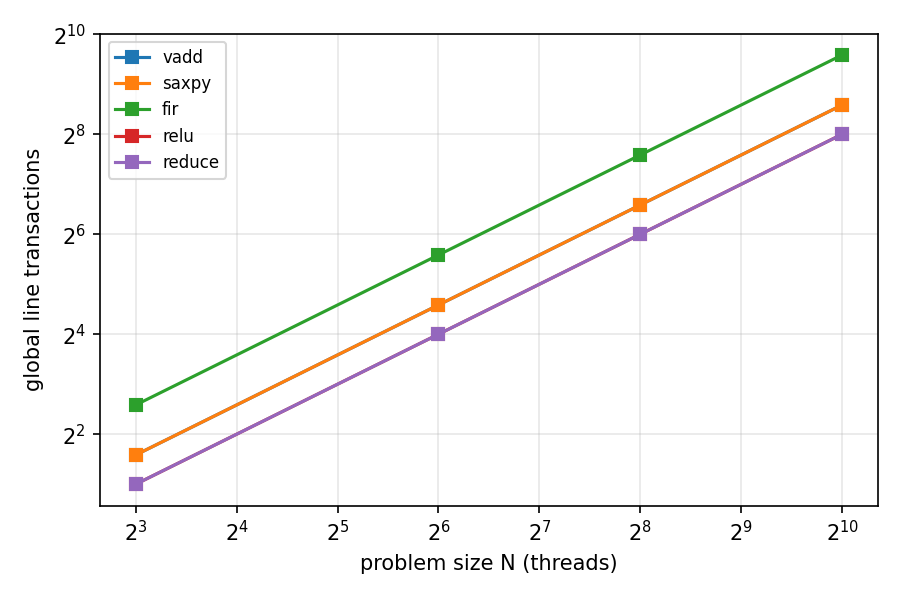
docs/figs/memtraffic.png
