Krishna-Gorai/simtix/docs/figs/rodinia_ratio.png

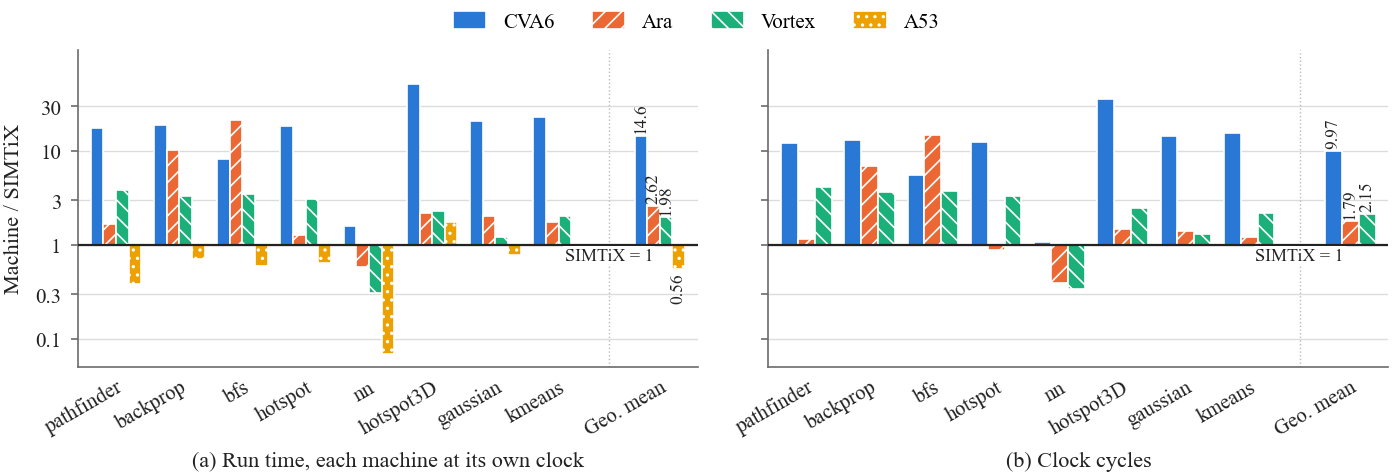
docs/figs/rodinia_ratio.png
