Krishna-Gorai/simtix/docs/figs/simtix_chip_top.png

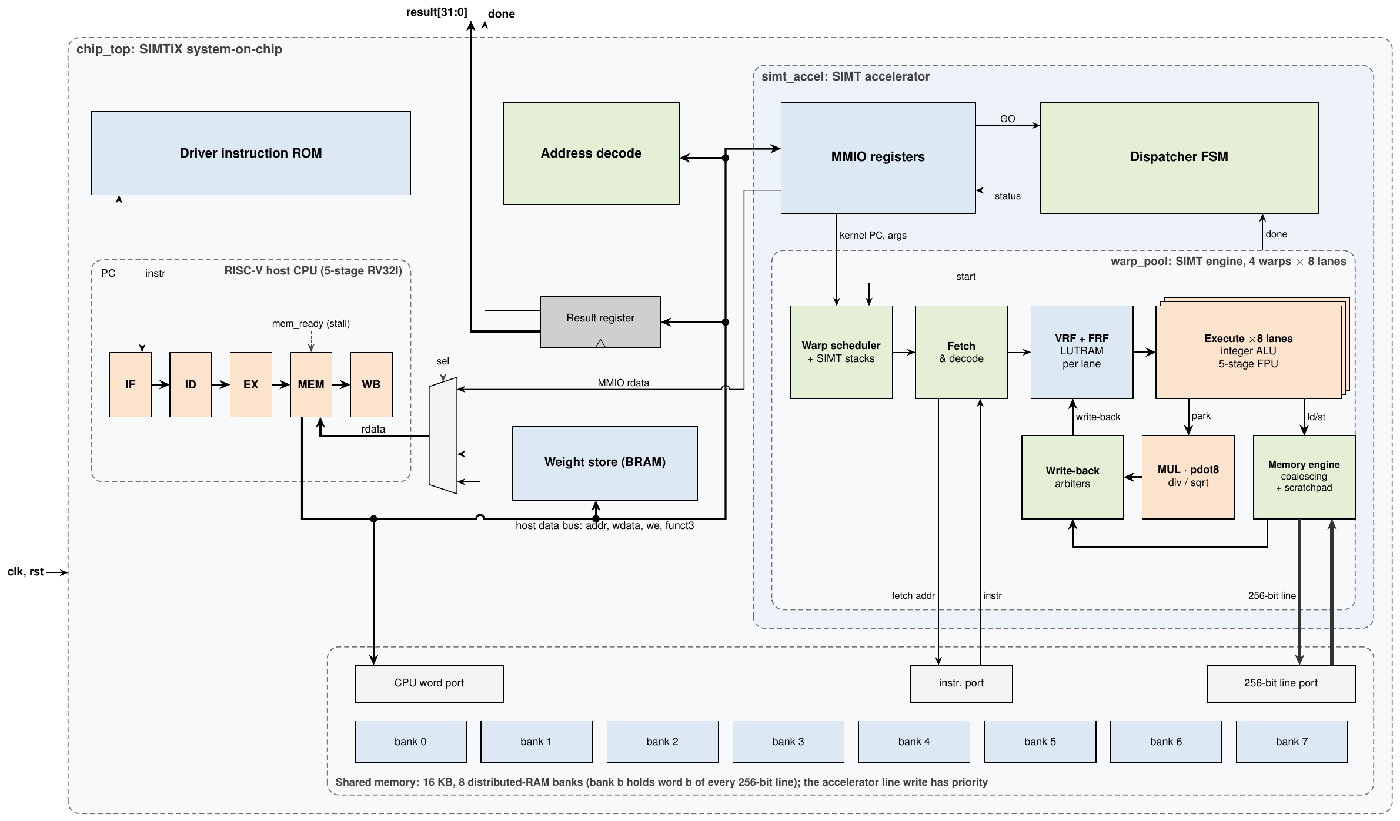
docs/figs/simtix_chip_top.png
