Krishna-Gorai/simtix/docs/figs/fp_cost.png

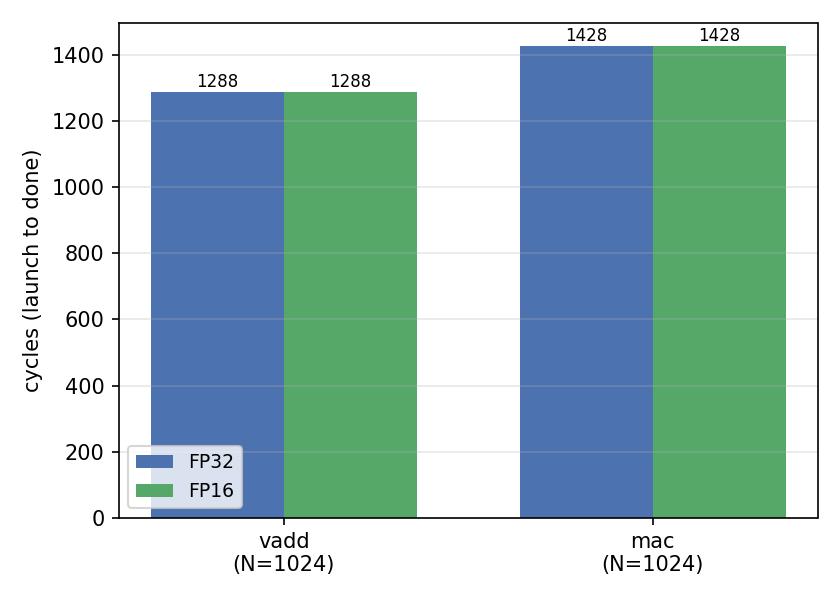
docs/figs/fp_cost.png
