Krishna-Gorai/simtix/docs/figs/fpk_cost.png

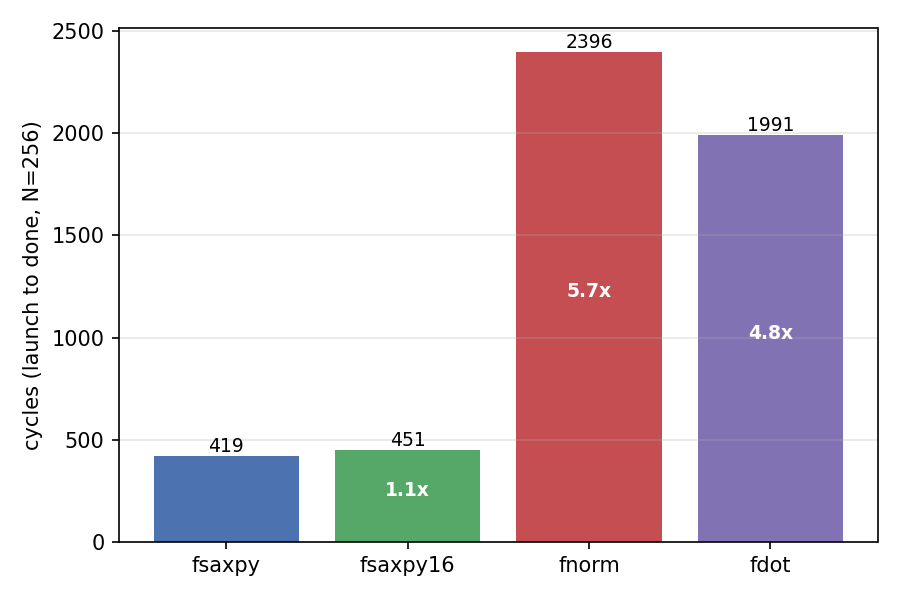
docs/figs/fpk_cost.png
