Krishna-Gorai/simtix/docs/rodinia_results.csv

app | size | simtix_us | simtix_cycles | simtix_errors | cva6_us | cva6_cycles | cva6_errors | cva6_max_error | ara_us | ara_cycles | ara_errors | ara_max_error | vortex_us | vortex_cycles | vortex_errors | a53_O2_us | cva6_over_simtix | ara_over_simtix | vortex_over_simtix | a53_over_simtix
pathfinder | 100000 | 250491.0 | 28884040 | 0 | 4428824.7 | 349644056 | 0 |  | 421198.4 | 33252505 | 0 |  | 960930.3 | 119949971 | 0 | 97161.5 | 17.68 | 1.68 | 3.84 | 0.39
backprop | 524288 | 299202.5 | 34519642 | 0 | 5729007.5 | 452290069 | 0 |  | 3055382.9 | 241214442 | 0 |  | 1008825.1 | 126086862 | 0 | 214154.1 | 19.15 | 10.21 | 3.37 | 0.72
bfs | 65536 | 36677.1 | 4230001 | 0 | 299807.5 | 23669011 | 0 |  | 794076.7 | 62690263 | 0 |  | 126842.9 | 15842942 | 0 | 21936.5 | 8.17 | 21.65 | 3.46 | 0.60
hotspot | 512 | 33552.8 | 3870814 | 0 | 553063.0 | 43662871 | 0 |  | 45331.8 | 3578825 | 0 |  | 103043.7 | 12875623 | 0 | 20994.8 | 16.48 | 1.35 | 3.07 | 0.63
hotspot | 1024 | 134213.0 | 15484292 | 0 | 2475016.4 | 195396034 | 0 |  | 172789.7 | 13641292 | 0 |  | 411210.7 | 51392904 | 0 | 85468.3 | 18.44 | 1.29 | 3.06 | 0.64
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
