Krishna-Gorai/simtix/docs/figs/simtix_chip_top.pdf

### Driver instruction ROM

Address decode | MMIO registers | Dispatcher FSM

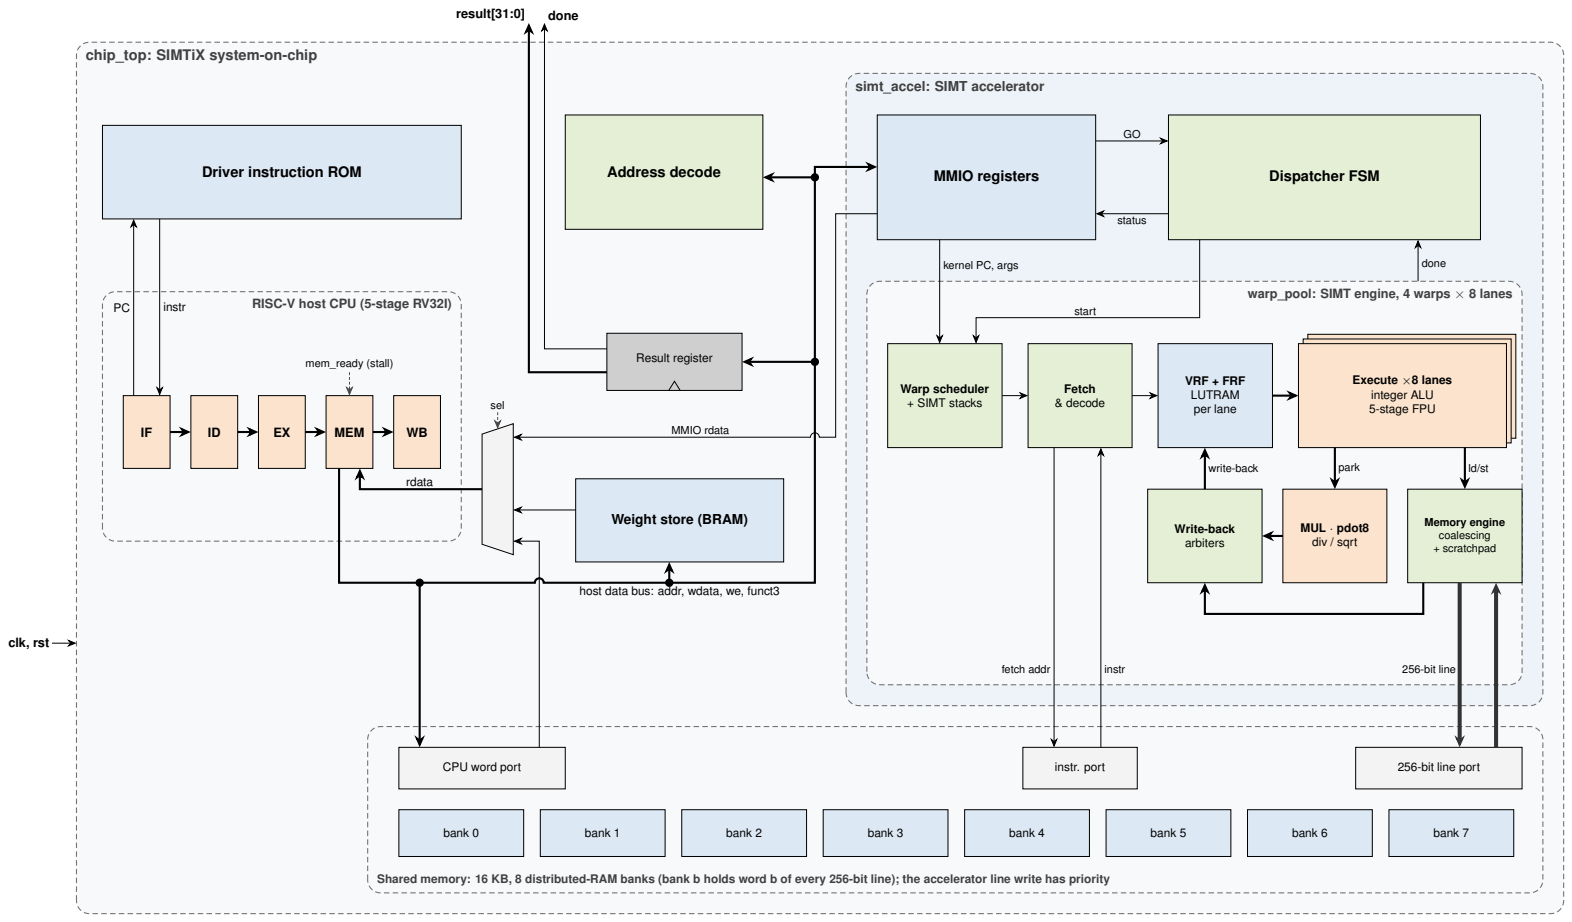
[picture p27: page 1]
MEM; Result register; Warp scheduler + SIMT stacks; Fetch & decode; VRF + FRF LUTRAM per lane; Execute ×8 lanes integer ALU 5-stage FPU; Write-back arbiters; MUL · pdot8 div / sqrt; Memory engine coalescing + scratchpad; CPU word port; instr. port; 256-bit line port; bank 0; bank 1; bank 2; bank 3; bank 4; bank 5; bank 6; bank 7; simt_accel: SIMT accelerator; instr; mem_ready (stall); sel; MMIO rdata; rdata; result[31:0]; done; clk, rst; status; write-back; park; start; fetch addr; 256-bit line

chip_top: SIMTiX system-on-chip

kernel PC, args

RISC-V host CPU (5-stage RV32I)

warp_pool: SIMT engine, 4 warps × 8 lanes

Weight store (BRAM)

host data bus: addr, wdata, we, funct3

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
