Krishna-Gorai/simtix/docs/figs/simtix_arch_v3.pdf

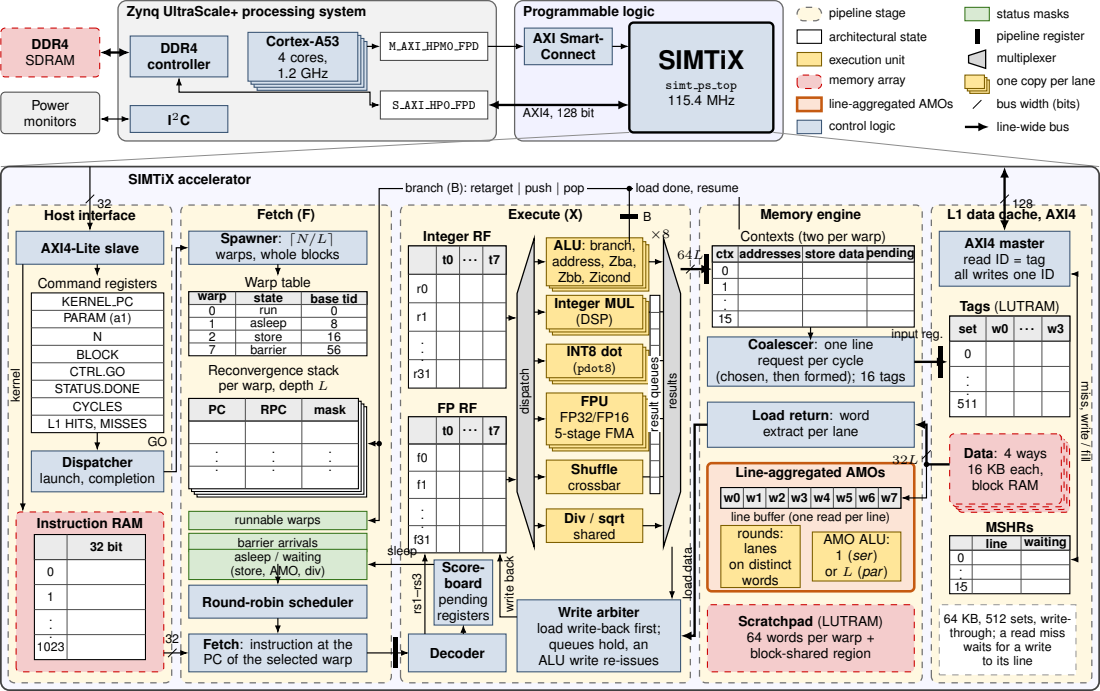
[picture p28: page 1]
DDR4 SDRAM; Power monitors; DDR4 controller; Cortex-A53 4 cores, 1.2 GHz; M AXI HPM0 FPD; S AXI HP0 FPD; Programmable logic; AXI Smart-; Connect; SIMTiX; AXI4, 128 bit; pipeline stage; architectural state; execution unit; memory array; control logic; status masks; pipeline register; multiplexer; SIMTiX accelerator; Host interface; AXI4-Lite slave; Command registers; KERNEL PC PARAM (a1); N BLOCK CTRL.GO STATUS.DONE CYCLES L1 HITS, MISSES; Dispatcher launch, completion; Instruction RAM; 32 bit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

Zynq UltraScale+ processing system

one copy per lane

simt ps top
115.4 MHz

line-aggregated AMOs

bus width (bits)

line-wide bus

Fetch (F)
Spawner: ⌈N/L⌉
warps, whole blocks

AXI4 master
read ID = tag
all writes one ID

Reconvergence stack
per warp, depth L

Coalescer: one line
request per cycle

(chosen, then formed); 16 tags

miss, write / fill

Load return: word
extract per lane

Line-aggregated AMOs

line buffer (one read per line)
rounds:
lanes
on distinct
words

barrier arrivals
asleep / waiting
(store, AMO, div)

Round-robin scheduler

Write arbiter
load write-back first;
queues hold, an
ALU write re-issues

Scratchpad (LUTRAM)
64 words per warp +
block-shared region

64 KB, 512 sets, write-
through; a read miss
waits for a write
to its line

Fetch: instruction at the
PC of the selected warp
