Krishna-Gorai/simtix/docs/figs/arch_v2_tikz/simtix_arch_v3.pdf

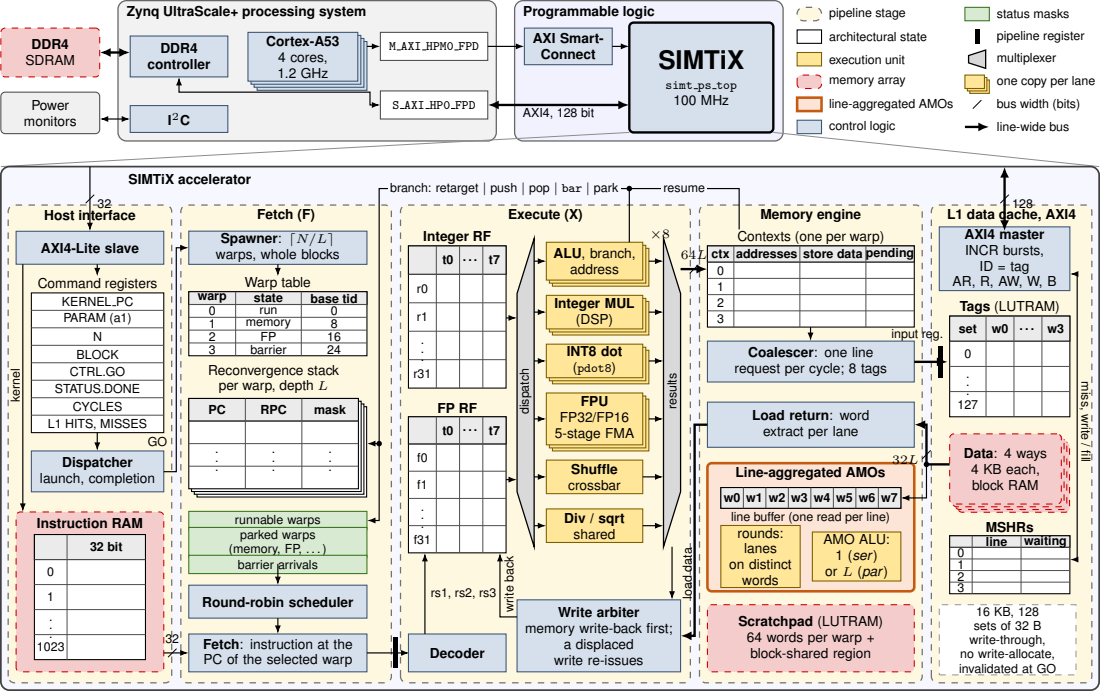
[picture p29: page 1]
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

Zynq UltraScale+ processing system

one copy per lane

simt ps top
100 MHz

line-aggregated AMOs

bus width (bits)

line-wide bus

Fetch (F)
Spawner: ⌈N/L⌉
warps, whole blocks

Memory engine
Contexts (one per warp)

Reconvergence stack
per warp, depth L

Coalescer: one line
request per cycle; 8 tags

miss, write / fill

Load return: word
extract per lane

Line-aggregated AMOs

line buffer (one read per line)
rounds:
lanes
on distinct
words

Round-robin scheduler

Write arbiter
memory write-back first;
a displaced
write re-issues

sets of 32 B
write-through,
no write-allocate,
invalidated at GO

Scratchpad (LUTRAM)
64 words per warp +
block-shared region

Fetch: instruction at the
PC of the selected warp
