Krishna-Gorai/simtix/rtl/accel/warp_pool.sv

// =============================================================================
// warp_pool.sv  -  M5 multi-warp SIMT engine with per-warp divergence stack
//
// This is the M2 single warp (rtl/accel/warp.sv) grown into a *pool*: NUM_WARPS
// hardware warp slots are resident at once, each with its own banked VRF
// (vrf[warp][lane][reg]) and a private SIMT reconvergence stack, all sharing ONE
// fetch/decode/ALU datapath and ONE data port. A round-robin scheduler issues
// one warp per cycle.
//
// Why this hides latency:  a memory instruction's lane accesses run in a
// *background* memory engine while the scheduler keeps issuing OTHER warps'
// compute instructions on the (otherwise idle) fetch/ALU datapath. So a warp's
// memory cost is overlapped with another warp's useful work — the classic GPU
// latency-hiding trick. The two resources advance in the same cycle:
//   * issue engine  : a 2-stage F(etch)/X(ecute) pipeline (task #23) — stage F
//     picks a runnable warp and fetches its instruction (single imem port);
//     stage X decodes/executes/commits it the NEXT cycle from registered copies.
//     A warp re-enters fetch only after its X resolves, so back-to-back
//     instructions of one warp run every other cycle; with ≥2 runnable warps
//     F and X interleave different warps and the pipeline stays full.
//   * memory engine : 1 coalesced line transaction / cycle (single line dport)
// At most one memory instruction is in flight (single data port); a warp that
// wants memory while the port is busy simply waits its turn in the scheduler.
//
// M4 — address coalescing: the data port serves a whole cache line (LINE_WORDS
// words) per access; each cycle the memory engine services every pending lane
// sharing the lowest pending lane's line in one transaction. dbg_mem_txns counts.
//
// M5 — control divergence (TRUE SIMT): each warp slot owns a small SIMT
// reconvergence stack. The top-of-stack (TOS) frame defines the warp's current
// PC and *active mask* (which lanes execute). A branch is resolved per lane:
//   * uniform (all lanes agree)  -> just retarget the TOS PC, no divergence.
//   * divergent (lanes disagree) -> push a frame so the two lane groups run in
//     turn and reconverge at a join PC (RPC) stored in the frame.
// The supported, compiler-free convention is single-sided `if (cond){...}` and
// divergent loops (one side of the branch falls straight through to the join):
//   * forward branch  (target>pc): RPC = target;   continue = fall-through lanes.
//   * backward branch (target<=pc): RPC = pc+4;     continue = taken lanes (loop).
// The reconv frame holds the *union* mask at RPC; the pushed "continue" frame
// runs its lanes until their PC reaches RPC, then pops — and the warp reconverges
// with the full mask. Nesting works (stack depth SDEPTH = NUM_LANES, which bounds
// the frames any branch pattern can push). General two-sided
// if/else (both arms non-empty before the join) is out of scope for M5 — write
// it as two single-sided ifs. dbg_divergences counts divergent branch events.
//
// On GO the engine spawns warps 0,1,2,... covering ceil(n_threads/WARP_SIZE)
// warps; if there are more warps than slots, a slot is recycled as soon as the
// warp occupying it retires. NUM_WARPS must be a power of two (the round-robin
// pointer wraps in its width).
//
// v2 — thread blocks and synchronisation: block_log2 = b groups the grid into
// thread blocks of 2^b warps. The slots are partitioned into groups of 2^b, and a
// block is spawned into a free group all at once, so the warps of a block are
// always co-resident. `bar` parks a warp (W_BAR) until every live warp of its
// group has arrived; the SHARED_BASE scratch aperture addresses the group's
// scratch storage, shared by the block. b = 0 reproduces the earlier one-warp-
// at-a-time spawning exactly. Warp shuffles run on a cross-lane engine
// and RV32A atomics run in the memory engine, which applies the lanes of a
// global AMO that fall in one line with a single read-modify-write.
// =============================================================================
`timescale 1ns/1ps

module warp_pool
  import simtix_pkg::*;
#(
    parameter int MEM_CTX = `SIMTIX_MEM_CTX_PER_WARP * NUM_WARPS, // memory ops in flight (1 = the v1 engine)
    parameter bit AMO_AGG = 1'b1,       // AMO lanes share one read-modify-write per line
    parameter bit AMO_PAR = 1'b0,       // AMO lanes per cycle: 1 = all on distinct words, 0 = one
    parameter bit MEM_BYP = 1'b1        // data port may answer in the request cycle (0: never)
) (
    input  logic        clk,
    input  logic        rst,           // active-high

    // Dispatch: launch the whole grid (n_threads threads) in one GO.
    input  logic        start,         // 1-cycle: begin a new grid
    input  logic [31:0] base_a,
    input  logic [31:0] base_b,
    input  logic [31:0] base_c,
    input  logic [31:0] n_threads,
    input  logic [31:0] kernel_pc,
    input  logic [2:0]  block_log2,    // log2(warps per thread block), sampled at start

    // Shared kernel instruction fetch (async-read ROM).
    output logic [31:0] imem_addr,
    input  logic [31:0] imem_data,

    // Line-wide global data port, split transaction (v2 WP2). A request is
    // accepted when dmem_req && dmem_gnt and carries dmem_tag; every request (read
    // or write) gets one response on dmem_rvalid that returns the tag on dmem_rtag,
    // in any order. A zero-latency memory ties dmem_gnt = 1, dmem_rvalid = dmem_req,
    // dmem_rtag = dmem_tag and returns dmem_rdata for this cycle's address.
    output logic                 dmem_req,
    input  logic                 dmem_gnt,
    output logic [MEM_TAGW-1:0]  dmem_tag,
    output logic [31:0]          dmem_addr,    // line-aligned byte address
    output logic [LINE_BITS-1:0] dmem_wdata,   // one cache line of write data
    output logic                 dmem_we,
    output logic [LINE_BE-1:0]   dmem_be,       // per-byte write enable across line
    input  logic                 dmem_rvalid,
    input  logic [MEM_TAGW-1:0]  dmem_rtag,
    input  logic [LINE_BITS-1:0] dmem_rdata,    // one cache line of read data

    output logic        busy,
    output logic        done,          // 1-cycle pulse when the whole grid retires
    output logic [31:0] dbg_retire_a0, // last-retired warp's lane-0 tid (observ.)
    output logic [31:0] dbg_mem_txns,  // global line transactions since last launch
    output logic [31:0] dbg_divergences, // divergent-branch events since last launch
    output logic [31:0] dbg_scratch_txns, // scratchpad transactions since last launch
    // M7 energy study — divergence-aware lane clock-gating accounting.
    output logic [31:0] dbg_issued_insns, // datapath instructions issued (lane-slots
                                          // = NUM_LANES * this if never gated)
    output logic [31:0] dbg_active_lanes, // Σ active lanes per issued instruction
                                          // (lane-cycles a gated design actually clocks)
    // State for the board's debug window (simt_ps_top, 0x0200): DBG_POOL words.
    output logic [31:0] dbg_state [0:DBG_POOL-1]
);

    localparam int NW     = NUM_WARPS;
    localparam int NL     = NUM_LANES;
    localparam int WSZ    = WARP_SIZE;
    localparam int WIDXW  = (NW > 1) ? $clog2(NW) : 1;
    localparam int LIDXW  = $clog2(NL);
    localparam int LOGNW  = $clog2(NW);        // largest legal block_log2
    // SIMT stack depth. A divergent branch pushes a frame whose mask is a strict,
    // non-empty subset of the mask below it, so no warp ever holds more than NL
    // frames: NL is enough for any program (a loop whose lanes leave it at NL
    // different trips uses all of them).
    localparam int SDEPTH = NL;
    localparam int SPW    = $clog2(SDEPTH);
    // VRF address = {warp, reg5}. NW is a power of two, so depth = NW*32.
    localparam int VAW    = WIDXW + 5;
    localparam int VDEPTH = (1 << VAW);

    localparam logic [31:0] RPC_BOTTOM = 32'hFFFF_FFFF;  // base frame never pops

    // ── Per-slot architectural state ──────────────────────────────────────────────
    // W_SFU: parked on the multi-cycle divide/sqrt unit (M14.3), mirroring W_MEM's "park
    // on a side engine while the scheduler keeps issuing other warps" pattern. The FP,
    // multiply, dot and shuffle units no longer park the warp (v3 B2: the register
    // scoreboard tracks their pending results). W_BAR: waiting at a block barrier.
    typedef enum logic [3:0] { W_EMPTY, W_RUN, W_MEM, W_SFU, W_DONE, W_BAR } wstate_e;
    wstate_e        wstate    [0:NW-1];
    // v3 B2: a warp held back by the register scoreboard sleeps (is not fetched) until
    // the event that can unblock it: one of its own results written back, or, when its
    // unit was full, any unit writeback. Retrying every other cycle instead would take
    // issue slots from the other warps.
    logic [NW-1:0]  sb_wait;      // asleep after a scoreboard stall
    logic [NW-1:0]  sb_wfull;     // ... because its unit was full (wake on any writeback)
    logic [NW-1:0]  sb_wake;
    logic [NW-1:0]  sb_own;       // a result of warp k is written / its load finished
    logic           sb_any;       // any unit result is written

    // Vector register file — one independent distributed-RAM (LUTRAM) bank per lane,
    // each VDEPTH×32 addressed by {warp,reg}, with ONE synchronous write port and two
    // async read ports (rs1/rs2). The banks are declared per-lane in the generate
    // block below: a single 1D array per lane is what Vivado reliably infers as
    // LUTRAM, whereas a 2D vrf[lane][addr] written in a for-loop is misread as a
    // 3D-RAM and dissolves to 32 768 registers ([Synth 8-11357]). To preserve the
    // single write port we (a) never zero the file on spawn — see reg_written — and
    // (b) arbitrate issue- vs. memory-writeback so only one source drives a lane's
    // port per cycle (see the write arbiter below).
    logic [31:0]    vrf_rd1 [0:NL-1];                   // async read port 1 (rs1)
    logic [31:0]    vrf_rd2 [0:NL-1];                   // async read port 2 (rs2)

    // ── M14.0: floating-point register file (separate from the integer VRF) ──────
    // One independent distributed-RAM bank per lane, VDEPTH×32 addressed by
    // {warp,freg}, exactly like the integer VRF but with THREE async read ports
    // (fs1/fs2/fs3 — fs3 feeds the future FMA) and one sync write port. The 32-bit
    // width holds an FP32 value or a NaN-boxed FP16 (low 16 bits), so a single file
    // serves both formats. f0 is a normal register here (no x0 hardwiring). Unlike
    // the integer file there are no spawn seeds, so an unwritten f-register reads 0
    // (freg_written guards stale RAM contents on a recycled warp slot).
    logic [31:0]    frf_rd1 [0:NL-1];                   // async read port 1 (fs1)
    logic [31:0]    frf_rd2 [0:NL-1];                   // async read port 2 (fs2)
    logic [31:0]    frf_rd3 [0:NL-1];                   // async read port 3 (fs3, FMA)
    logic           freg_written [0:NW-1][0:NL-1][0:31];

    // Per-(warp,lane,reg) "has been written this grid" bit. An unwritten register
    // reads its spawn seed (a0=tid, a1..a4=args, else 0) instead of RAM, which
    // reproduces the old "zero the VRF on spawn then seed" behaviour bit-for-bit
    // without the 1-cycle 32-register clear that blocked RAM inference.
    logic           reg_written [0:NW-1][0:NL-1][0:31];

    logic [31:0]    warp_base [0:NW-1];                 // base tid (for tid CSR)


    // Per-warp SIMT reconvergence stack. TOS = sp[w]; the TOS frame gives the
    // warp's live PC (stk_npc) and active mask (stk_mask); stk_rpc is the join PC
    // at which a pushed frame pops and reconverges into the frame below.
    logic [31:0]    stk_npc  [0:NW-1][0:SDEPTH-1];
    logic [31:0]    stk_rpc  [0:NW-1][0:SDEPTH-1];
    logic [NL-1:0]  stk_mask [0:NW-1][0:SDEPTH-1];
    logic [SPW-1:0] sp       [0:NW-1];

    // ── Grid bookkeeping ──────────────────────────────────────────────────────────
    logic [31:0]    arg_a, arg_b, arg_c, arg_n, arg_pc;
    logic [31:0]    total_warps;     // ceil(n_threads / WSZ)
    logic [31:0]    next_wid;        // next warp index to spawn into a free slot
    logic           running;
    logic [WIDXW-1:0] rr_ptr;        // round-robin issue pointer
    logic [2:0]       blk_lg;        // log2(warps per block) of this grid, <= LOGNW

    // ── Memory engine interface (rtl/accel/mem_engine.sv) ──────────────────────────
    logic             me_in_valid, me_in_ready;
    logic [31:0]      me_sdata [0:NL-1];         // per-lane store data at issue
    logic             me_rs_valid;               // a memory op finished: resume its warp
    logic [WIDXW-1:0] me_rs_w;
    logic [31:0]      me_rs_pc;
    logic [4:0]       me_rs_rd;                  // v3: the finished op's destination,
    logic             me_rs_fp, me_rs_ld;        // its file, and whether it was a load
    logic             me_busy, me_fp_busy, me_gtxn, me_stxn;
    logic [WIDXW-1:0] me_wb_w;                   // writeback destination warp / reg
    logic [4:0]       me_wb_rd;
    logic             me_wb_fp;
    logic             mem_wb_act;             // memory engine writes a regfile this cycle
    logic [NL-1:0]    mem_wb_lane;            // per-lane: memory writeback fires
    logic [31:0]      mem_wb_data [0:NL-1];

    // ── F-stage: round-robin FETCH selection (combinational) ────────────────────────
    // Task #23: the issue engine is a 2-stage F(etch)/X(ecute) pipeline. Placed
    // timing showed the whole single-cycle fetch→decode→VRF-read→ALU→writeback
    // cloud as the critical path (26 logic levels, 82% route). Stage F selects a
    // runnable warp and fetches its instruction from the async imem; the F→X
    // boundary registers the instruction + warp context (instr, issue_w, cur_*),
    // and stage X decodes/executes/commits from those registers the next cycle —
    // splitting the cloud roughly in half and turning the two dominant congestion
    // broadcast nets (issue_w, imem_data) into cheaply-replicated flop outputs.
    //
    // A warp with an instruction in X is IN-FLIGHT and not re-fetchable until X
    // resolves it (its PC/state only update at resolve). X always resolves in one
    // cycle: it commits, parks the warp on an engine, or — engine-busy / writeback-
    // squash — does nothing, returning the warp to the fetch pool to retry (the
    // old "waits its turn" semantics; nothing was committed, so re-execution is
    // idempotent). The fetched warp's TOS context is stable across F→X because
    // only the warp's own X resolve or the engine that OWNS it may touch its
    // stack/state, and an in-flight W_RUN warp is owned by X alone.
    logic             fetch_valid;
    logic [WIDXW-1:0] fetch_w;
    logic             inflight [0:NW-1];   // warp has an instruction in X
    // v3 (clock): a branch, jal or jalr updates its warp's SIMT stack one cycle after X
    // (stage B), from the registered outcome, which takes the operand read, the lane
    // compares and the taken-mask tests out of the stack registers' input path. The
    // warp stays in flight until B, so it is not fetched in between.
    typedef enum logic [1:0] { BK_BR, BK_JUMP } br_kind_e;
    logic             br_v;
    br_kind_e         br_kind;
    logic [WIDXW-1:0] br_w;
    logic [SPW-1:0]   br_sp;
    logic [NL-1:0]    br_taken, br_mask;
    logic [31:0]      br_tgt, br_fall;
    logic             br_fwd;              // forward branch (target above the branch)
    always_comb begin
        fetch_valid = 1'b0;
        fetch_w     = '0;
        for (int k = 0; k < NW; k++) begin
            logic [WIDXW-1:0] idx;
            idx = rr_ptr + k[WIDXW-1:0];          // wraps in WIDXW bits (NW is pow2)
            if (!fetch_valid && (wstate[idx] == W_RUN) && !inflight[idx] && !sb_wait[idx]) begin
                fetch_valid = 1'b1;
                fetch_w     = idx;
            end
        end
    end

    // ── X-stage pipeline registers (loaded by F, consumed by everything below) ──────
    // issue_w addresses EVERY VRF/FRF distributed-RAM read port (vaddr(issue_w,*))
    // and the reg_written/seed muxes — placed timing showed it fanning out to ~2419
    // endpoints (the dominant route-congestion net). max_fanout replicates the
    // driver flop into physically-local clusters; logic-equivalent.
    logic             issue_valid;
    (* max_fanout = 80 *)
    logic [WIDXW-1:0] issue_w;

    // ── Free-group selection for spawning the next block (combinational) ────────────
    // Slot k belongs to group k >> blk_lg. A block spawns only into a group whose
    // slots are all free, and the lowest free group wins. With blk_lg = 0 a group is
    // a single slot, which is the earlier lowest-free-slot policy.
    logic             fill_valid;
    logic [WIDXW-1:0] fill_g;
    always_comb begin
        fill_valid = 1'b0;
        fill_g     = '0;
        for (int g = NW-1; g >= 0; g--) begin       // descending: lowest free group wins
            logic gfree;
            gfree = (g < (NW >> blk_lg));
            for (int k = 0; k < NW; k++)
                if ((k >> blk_lg) == g)
                    gfree = gfree && ((wstate[k] == W_EMPTY) || (wstate[k] == W_DONE));
            if (gfree) begin
                fill_valid = 1'b1;
                fill_g     = g[WIDXW-1:0];
            end
        end
    end

    // Per-slot spawn decision for the block going into fill_g: slot k takes warp
    // next_wid + (k mod 2^blk_lg); slots past the end of the grid stay free (a partial
    // last block). Computed here so the sequential spawn step is a set of
    // single-statement loops (see the BLKLOOPINIT note at reset).
    logic [NW-1:0] spawn_en;
    logic [31:0]   spawn_base [0:NW-1];
    logic [NL-1:0] spawn_mask [0:NW-1];
    always_comb begin
        for (int k = 0; k < NW; k++) begin
            logic [31:0] wid;
            wid           = next_wid + (k & ((1 << blk_lg) - 1));
            spawn_base[k] = wid * WSZ;
            spawn_en[k]   = (next_wid < total_warps) && fill_valid
                         && ((k >> blk_lg) == int'(fill_g)) && (wid < total_warps);
            for (int l = 0; l < NL; l++)
                spawn_mask[k][l] = ((spawn_base[k] + l[31:0]) < arg_n);   // tail mask
        end
    end

    // ── Block barrier release (combinational) ───────────────────────────────────────
    // A waiting warp is released once no warp of its group is still running or
    // parked on an engine: every slot of the group is at the barrier, has exited,
    // or is empty (the tail of a partial last block).
    logic [NW-1:0] bar_release;
    always_comb begin
        for (int k = 0; k < NW; k++) begin
            logic all_in;
            all_in = 1'b1;
            for (int j = 0; j < NW; j++)
                if ((j >> blk_lg) == (k >> blk_lg))
                    all_in = all_in && ((wstate[j] == W_BAR) || (wstate[j] == W_DONE) ||
                                        (wstate[j] == W_EMPTY));
            bar_release[k] = (wstate[k] == W_BAR) && all_in;
        end
    end

    // ── Live TOS view of the FETCHED warp (F-stage) ─────────────────────────────────
    logic [SPW-1:0] fetch_sp;
    logic [31:0]    fetch_pc;
    assign fetch_sp = sp[fetch_w];
    assign fetch_pc = stk_npc[fetch_w][fetch_sp];

    // Shared fetch follows the fetched warp's TOS PC; imem_data is captured into
    // the `instr` register at the F→X boundary.
    assign imem_addr = fetch_pc;

    // X-stage registered warp context: the TOS as seen at fetch (stable while the
    // warp is in flight — see the F-stage note above).
    logic [SPW-1:0] cur_sp;
    logic [31:0]    cur_pc;
    logic [NL-1:0]  cur_mask;        // active lanes for the executing warp
    logic [31:0]    cur_rpc;         // TOS reconvergence PC (for the pop check)

    // A pushed frame is "spent" (its lanes have reached the join) when its PC
    // equals its reconvergence PC → pop it instead of executing.
    logic do_pop;
    assign do_pop = issue_valid && (cur_sp != '0) && (cur_pc == cur_rpc);

    // ── M7: divergence-aware lane clock-gating control ──────────────────────────────
    // The TOS active mask IS the per-lane clock-enable: a lane masked off by
    // divergence does no architectural work (its wb_en is already gated below), yet
    // in the baseline design its datapath registers still toggle every cycle. With
    // lane clock-gating, cur_mask[l] drives an integrated clock-gate (ICG) on lane
    // l's pipeline registers, so only the active lanes are clocked. `lane_ce` is
    // that enable vector (synthesis maps each bit to an ICG); the counters below
    // measure the dynamic energy a gated design saves versus clocking all NL lanes.
    logic [NL-1:0]    lane_ce;
    logic [LIDXW:0]   n_active;     // popcount(cur_mask): lanes a gated design clocks
    assign lane_ce  = cur_mask;
    assign n_active = lane_ce_count(lane_ce);

    function automatic logic [LIDXW:0] lane_ce_count(input logic [NL-1:0] m);
        lane_ce_count = '0;
        for (int l = 0; l < NL; l++) lane_ce_count += {{LIDXW{1'b0}}, m[l]};
    endfunction

    // VRF bank address from {warp, reg}.
    function automatic logic [VAW-1:0] vaddr(input logic [WIDXW-1:0] w,
                                             input logic [4:0]       r);
        vaddr = {w, r};
    endfunction

    // Spawn-seed value of a register that has not yet been written this grid.
    // Mirrors the old spawn writes: a0=tid (warp_base+lane), a1..a4=args, else 0.
    function automatic logic [31:0] seed_val(input logic [WIDXW-1:0] w,
                                             input logic [LIDXW-1:0] l,
                                             input logic [4:0]       r);
        case (r)
            ARG_TID[4:0]: seed_val = warp_base[w] + {{(32-LIDXW){1'b0}}, l};
            ARG_A[4:0]:   seed_val = arg_a;
            ARG_B[4:0]:   seed_val = arg_b;
            ARG_C[4:0]:   seed_val = arg_c;
            ARG_N[4:0]:   seed_val = arg_n;
            default:      seed_val = 32'd0;
        endcase
    endfunction

    // ── Decode (X-stage) ────────────────────────────────────────────────────────────
    // instr is the X-stage instruction register, loaded from the async-LUTRAM fetch
    // (imem_data) at the F→X boundary. Placed timing showed the old combinational
    // imem_data fanning out to ~1324 endpoints (decode + every lane's operand mux +
    // read-address fields), the second-worst congestion net; as a register its
    // driver flop replicates cheaply under max_fanout.
    (* max_fanout = 80 *)
    logic [31:0] instr;
    logic [6:0]  opcode;
    logic [4:0]  rd, rs1, rs2;
    logic [2:0]  funct3;
    logic        funct7b5, funct7b0;
    logic [31:0] i_imm, s_imm, u_imm, b_imm, j_imm;

    assign opcode   = instr[6:0];
    assign rd       = instr[11:7];
    assign funct3   = instr[14:12];
    assign rs1      = instr[19:15];
    assign rs2      = instr[24:20];
    assign funct7b5 = instr[30];
    assign funct7b0 = instr[25];   // RV32M ops set funct7[0] (e.g. mul: 0000001)

    assign i_imm = {{20{instr[31]}}, instr[31:20]};
    assign s_imm = {{20{instr[31]}}, instr[31:25], instr[11:7]};
    assign u_imm = {instr[31:12], 12'b0};
    assign b_imm = {{19{instr[31]}}, instr[31], instr[7], instr[30:25], instr[11:8], 1'b0};
    assign j_imm = {{11{instr[31]}}, instr[31], instr[19:12], instr[20], instr[30:21], 1'b0};

    logic is_load, is_store, is_mem, is_ecall, is_csr, is_mul, is_amo;
    logic [4:0] amo_op;
    assign is_load  = (opcode == OP_LOAD)  | (opcode == OP_LOADFP);
    assign is_store = (opcode == OP_STORE) | (opcode == OP_STOREFP);
    // v2: RV32A word AMOs (lr.w / sc.w excluded; they fall through as no-ops).
    assign amo_op   = instr[31:27];
    assign is_amo   = (opcode == OP_AMO) && (funct3 == 3'b010) &&
                      (amo_op != AMO_LR) && (amo_op != AMO_SC);
    assign is_mem   = is_load | is_store | is_amo;
    assign is_ecall = (opcode == OP_SYSTEM) && (funct3 == 3'b000);
    assign is_csr   = (opcode == OP_SYSTEM) && (funct3 != 3'b000);
    // B1: RV32M `mul` (low 32) — the only RV32M op this engine supports (funct3==000,
    // funct7[0]=1). It no longer executes in the single-cycle ALU; it runs in the
    // multi-cycle DSP-pipelined multiplier so the DSP leaves the critical path.
    assign is_mul   = (opcode == OP_OP) && (funct3 == 3'b000) && funct7b0;

    // AI extension: INT8 packed dot-product `pdot8` (custom-0, funct7 = 0). Like `mul`
    // it does not execute in the single-cycle ALU — it runs in the DSP-pipelined
    // dot engine. funct3 carries the signedness variant (DOT8_SS/UU/SU).
    logic       is_dot;
    logic [2:0] dot_mode;
    assign is_dot   = (opcode == OP_CUSTOM0) && (instr[31:25] == F7_DOT);
    assign dot_mode = funct3;

    // v2: warp shuffle and block barrier share custom-0, told apart by funct7.
    logic is_shfl, is_bar;
    assign is_shfl  = (opcode == OP_CUSTOM0) && (instr[31:25] == F7_SHFL);
    assign is_bar   = (opcode == OP_CUSTOM0) && (instr[31:25] == F7_BAR);

    // ── M14.0: floating-point decode ────────────────────────────────────────────
    // FP loads/stores reuse the integer memory engine (the address register is an
    // INTEGER reg in RV32F, so address-gen is unchanged); is_fp_mem only steers the
    // data side — store data is read from the f-regfile and load results are written
    // back to it. The OP-FP / fused-multiply-add compute ops are DECODED here so the
    // f-source/format/rounding fields are ready, but they execute no math yet (M14.1
    // adds the FPU); in M14.0 they retire as a PC-advancing no-op (no register
    // write), which is inert for every existing integer kernel.
    logic       is_load_fp, is_store_fp, is_fp_mem;
    logic [4:0] rs3;                       // fs3 for FMA read port (instr[31:27])
    assign is_load_fp  = (opcode == OP_LOADFP);
    assign is_store_fp = (opcode == OP_STOREFP);
    assign is_fp_mem   = is_load_fp | is_store_fp;
    assign rs3         = instr[31:27];

    // FP compute decode (OP-FP). funct5 selects the operation, fmt the format,
    // funct3 the rounding mode / group sub-select, instr[20] the signed/unsigned
    // variant of fcvt. The per-lane simt_fpu (M14.1) consumes these. The fused-
    // multiply-add majors (OP_FMADD..OP_FNMADD) are NOT executed yet (M14.1b): they
    // fall through to the compute default and retire as a PC-advancing no-op, so an
    // FMA-using kernel is inert rather than wrong-but-silent — covered by M14.1b.
    logic       is_fp_op, fp_int_dest, wb_is_fp, fp_cvt_unsigned, fp_cvt_src_h;
    logic [4:0] fp_funct5;                 // OP-FP operation select
    logic [1:0] fp_fmt;                    // 00=S(FP32), 10=H(FP16)
    logic [2:0] fp_rm;                     // rounding mode / sub-select
    assign is_fp_op        = (opcode == OP_FP);
    assign fp_funct5       = instr[31:27];
    assign fp_fmt          = instr[26:25];
    assign fp_rm           = instr[14:12];
    assign fp_cvt_unsigned = instr[20];
    // fcvt.s.h source is half when the rs2 field encodes the H format (00010).
    assign fp_cvt_src_h    = (fp_funct5 == FP_CVT_FF) && (instr[24:20] == 5'b00010);
    // FP ops whose RESULT lands in the integer register file (compares, float->int,
    // fmv.x.w / fclass); all other OP-FP results land in the f-register file.
    assign fp_int_dest = is_fp_op && ((fp_funct5 == FP_CMP)   ||
                                      (fp_funct5 == FP_CVT_W) ||
                                      (fp_funct5 == FP_FMVXW));

    // M14.1b: fused multiply-add majors (fmadd/fmsub/fnmsub/fnmadd). The opcode bits
    // encode the variant: opcode[3]=negate-product, opcode[2]=negate-addend
    //   fmadd 1000011 (np=0,nc=0)  fmsub 1000111 (np=0,nc=1)
    //   fnmsub 1001011(np=1,nc=0)  fnmadd 1001111(np=1,nc=1)
    // The third f-source is rs3 (instr[31:27]); fmt/rm reuse the OP-FP fields. An
    // FMA always writes the f-register file.
    logic is_fma_op, fma_np, fma_nc;
    assign is_fma_op = (opcode == OP_FMADD) || (opcode == OP_FMSUB) ||
                       (opcode == OP_FNMSUB) || (opcode == OP_FNMADD);
    assign fma_np    = opcode[3];
    assign fma_nc    = opcode[2];

    assign wb_is_fp    = (is_fp_op && !fp_int_dest) || is_fma_op;

    // M14.3: divide / square-root go to the multi-cycle shared-style SFU (one
    // fp_divsqrt per lane behind a stall scoreboard), NOT the single-cycle FPU.
    logic is_fdiv, is_fsqrt, is_sfu_op;
    assign is_fdiv   = is_fp_op && (fp_funct5 == FP_DIV);
    assign is_fsqrt  = is_fp_op && (fp_funct5 == FP_SQRT);
    assign is_sfu_op = is_fdiv || is_fsqrt;

    // v3: three small standard extensions on the OP major opcode, told apart by the
    // whole funct7 (the base decode below looks at funct7 bits 5 and 0 only):
    //   Zba    sh1add/sh2add/sh3add  rd = rs2 + (rs1 << n)    funct7 0010000, funct3 010/100/110
    //   Zbb    min/minu/max/maxu                              funct7 0000101, funct3 100..111
    //   Zicond czero.eqz/czero.nez   rd = (rs2 ==/!= 0) ? 0 : rs1
    //                                                         funct7 0000111, funct3 101/111
    // Their result (x_res) goes to the register write only, not into the address path.
    logic [6:0] funct7;
    logic       x_sh, x_mm, x_cz, x_op;
    assign funct7 = instr[31:25];
    assign x_sh   = (opcode == OP_OP) && (funct7 == 7'b0010000) && !funct3[0] && (funct3 != 3'b000);
    assign x_mm   = (opcode == OP_OP) && (funct7 == 7'b0000101) && funct3[2];
    assign x_cz   = (opcode == OP_OP) && (funct7 == 7'b0000111) && funct3[2] && funct3[0];
    assign x_op   = x_sh || x_mm || x_cz;

    // ── ALU control decode (shared) ────────────────────────────────────────────────
    logic [3:0] alu_ctrl;
    always_comb begin
        unique case (opcode)
            OP_OP: begin
                unique case (funct3)
                    3'b000:  alu_ctrl = funct7b0 ? ALU_MUL
                                                 : (funct7b5 ? ALU_SUB : ALU_ADD);
                    3'b001:  alu_ctrl = ALU_SLL;
                    3'b010:  alu_ctrl = ALU_SLT;
                    3'b011:  alu_ctrl = ALU_SLTU;
                    3'b100:  alu_ctrl = ALU_XOR;
                    3'b101:  alu_ctrl = funct7b5 ? ALU_SRA : ALU_SRL;
                    3'b110:  alu_ctrl = ALU_OR;
                    default: alu_ctrl = ALU_AND;
                endcase
            end
            OP_OPIMM: begin
                unique case (funct3)
                    3'b000:  alu_ctrl = ALU_ADD;
                    3'b010:  alu_ctrl = ALU_SLT;
                    3'b011:  alu_ctrl = ALU_SLTU;
                    3'b100:  alu_ctrl = ALU_XOR;
                    3'b001:  alu_ctrl = ALU_SLL;
                    3'b101:  alu_ctrl = funct7b5 ? ALU_SRA : ALU_SRL;
                    3'b110:  alu_ctrl = ALU_OR;
                    default: alu_ctrl = ALU_AND;
                endcase
            end
            OP_LUI:   alu_ctrl = ALU_PASSB;
            OP_AUIPC: alu_ctrl = ALU_ADD;
            default:  alu_ctrl = ALU_ADD;   // LOAD/STORE address = base + imm
        endcase
    end

    // ── Lowest active lane of the issuing warp (the leader for uniform decisions) ────
    logic [LIDXW-1:0] first_l;
    always_comb begin
        first_l = '0;
        for (int l = NL-1; l >= 0; l--)        // last write wins -> lowest set lane
            if (cur_mask[l]) first_l = l[LIDXW-1:0];
    end

    // ── Per-lane datapath of the issuing warp (combinational) ───────────────────────
    logic [31:0] rv1   [0:NL-1];
    logic [31:0] rv2   [0:NL-1];
    logic [31:0] frv1  [0:NL-1];   // f-source 1 (fs1) — FPU operand a  (M14.1)
    logic [31:0] frv2  [0:NL-1];   // f-source 2 (fs2) — FPU operand b / fsw data
    logic [31:0] frv3  [0:NL-1];   // f-source 3 (fs3) — FMA addend     (M14.1b)
    logic [31:0] addr  [0:NL-1];   // effective address / ALU result per lane
    logic [31:0] wb_val[0:NL-1];   // integer-VRF writeback value
    logic        wb_en [0:NL-1];   // integer-VRF writeback enable
    logic [NL-1:0] fwb_en;         // per-lane FP-compute writeback enable (-> fpc_we)
    logic [NL-1:0] mwb_en;         // per-lane integer-mul writeback enable (-> mul_we)
    logic [NL-1:0] dwb_en;         // per-lane INT8-dot writeback enable (-> dot_we)
    logic [31:0] fpu_res[0:NL-1];  // per-lane FP32 execute result (combinational)
    logic [31:0] mul_res[0:NL-1];  // per-lane integer-mul result (pipelined DSP tree)
    logic [31:0] dot_res[0:NL-1];  // per-lane INT8-dot result (pipelined DSP MAC)

    // ── A1: FPU input pipeline registers (captured at FP-compute issue) ───────────────
    // Placed timing showed the worst path was: warp-state -> f-file LUTRAM read -> operand
    // mux -> FPU multiply, all in one cycle. We register the FPU operands + control at the
    // issue cycle (same capture-at-issue idea the SFU already uses for its operands), so
    // each simt_fpu starts stage-1 from clean registers and the f-file read + operand mux
    // + scheduler decode are lifted OUT of the multiply cone. Costs one extra FP-compute
    // latency cycle (absorbed by an added FPC_W2 scoreboard state); results are bit-exact.
    logic [31:0] q_frv1 [0:NL-1], q_frv2 [0:NL-1], q_frv3 [0:NL-1], q_rv1 [0:NL-1];
    // B1: integer-multiply operand registers (captured at issue; the DSP pipeline takes
    // a new pair every cycle).
    logic [31:0] q_mul_a [0:NL-1], q_mul_b [0:NL-1];
    // AI: INT8-dot operand registers (captured at issue; the per-lane DSP pipeline takes
    // a new op every cycle). q_dot_mode is the op's signedness variant.
    logic [31:0] q_dot_a [0:NL-1], q_dot_b [0:NL-1];
    logic [2:0]  q_dot_mode;
    logic [4:0]  q_fp_funct5;
    logic [2:0]  q_fp_rm;
    logic [1:0]  q_fp_fmt;
    logic        q_fp_cvt_unsigned, q_fp_cvt_src_h, q_is_fma_op, q_fma_np, q_fma_nc;

    // ── M14.1: per-lane FP32 execute unit (combinational) ───────────────────────────
    // One simt_fpu per lane runs the OP-FP datapath (add/sub/mul, sign-inject,
    // min/max, compare, int<->float convert, bit moves). Single-cycle, so an FP op
    // commits through the normal compute-writeback path (below) — to the f-file when
    // wb_is_fp, else to the integer VRF (compares / float->int / fmv.x.w). int_dest
    // is recomputed from the decode (fp_int_dest), so the module's is left open.
    genvar gp;
    generate
        for (gp = 0; gp < NL; gp++) begin : g_fpu
            /* verilator lint_off PINCONNECTEMPTY */
            simt_fpu u_fpu (
                .clk(clk),
                .funct5(q_fp_funct5), .cvt_unsigned(q_fp_cvt_unsigned),
                .cvt_src_h(q_fp_cvt_src_h), .rm(q_fp_rm), .fmt(q_fp_fmt),
                .is_fma(q_is_fma_op), .fma_np(q_fma_np), .fma_nc(q_fma_nc),
                .a(q_frv1[gp]), .b(q_frv2[gp]), .c(q_frv3[gp]), .xa(q_rv1[gp]),
                .res(fpu_res[gp]), .int_dest()      // recomputed as fp_int_dest in decode
            );
            /* verilator lint_on PINCONNECTEMPTY */
        end
    endgenerate

    // ── B1: per-lane multi-cycle integer multiplier (decomposed 16×16 DSPs) ──────────
    // RV32M `mul` (low 32) used to execute as a single-cycle `a*b` in the ALU, putting a
    // DSP48 directly in the fetch→execute→writeback combinational cloud (the placed
    // critical path) and — being un-pipelined — emitting DPIP/DPOP DRC advisories. We
    // pull it into this background engine: operands are captured at issue (q_mul_a/b),
    // the product streams through a fully-pipelined DSP tree,
    // and writes back when the integer VRF port is free.
    //
    // To make EVERY inferred DSP fully pipelined (AREG/BREG + MREG + PREG → 0 DRC
    // warnings) the 32×32 low product is DECOMPOSED into three 16×16 sub-multiplies:
    //     a*b (low32) = aL*bL + ((aL*bH + aH*bL) << 16)   [mod 2^32]
    // aH*bH is <<32 (irrelevant to the low 32); the low 32 is sign-agnostic, so the
    // unsigned sub-products are bit-correct for `mul`. Each 16×16 is one DSP that packs
    // cleanly (validated 0-warning in tests/dsp_pack_probe.sv). Latency = 6 internal
    // stages (split → DSP-in → MREG → PREG → cross-add → final-add); with the issue-cycle
    // q-capture that is 7 cycles issue→result (MUL_LAT, sampled by the result queue).
    genvar gm;
    generate
        for (gm = 0; gm < NL; gm++) begin : g_imul
            logic [15:0] aL, aH, bL, bH;
            always_ff @(posedge clk) begin
                aL <= q_mul_a[gm][15:0];  aH <= q_mul_a[gm][31:16];
                bL <= q_mul_b[gm][15:0];  bH <= q_mul_b[gm][31:16];
            end
            (* use_dsp = "yes" *) logic [15:0] aL_ll, bL_ll, aL_lh, bH_lh, aH_hl, bL_hl;
            logic [31:0] m_ll, p_ll, m_lh, p_lh, m_hl, p_hl;
            always_ff @(posedge clk) begin
                aL_ll <= aL; bL_ll <= bL;          // aL*bL  (low partial)
                aL_lh <= aL; bH_lh <= bH;          // aL*bH  (cross)
                aH_hl <= aH; bL_hl <= bL;          // aH*bL  (cross)
                m_ll <= aL_ll * bL_ll;  p_ll <= m_ll;
                m_lh <= aL_lh * bH_lh;  p_lh <= m_lh;
                m_hl <= aH_hl * bL_hl;  p_hl <= m_hl;
            end
            logic [31:0] cross_s, p_ll_d, lo_r;
            always_ff @(posedge clk) begin
                cross_s <= (p_lh + p_hl) << 16;    // only low 16 of the cross sum survives
                p_ll_d  <= p_ll;
                lo_r    <= p_ll_d + cross_s;
            end
            assign mul_res[gm] = lo_r;
        end
    endgenerate

    // ── AI: per-lane INT8 dot-product engine (4 parallel DSP products + pipe tree) ────
    // Mirrors the multiplier's streaming style: operands are captured at issue in q_dot_a/b and
    // stream through a fixed-latency pipeline; a new pdot8 may enter every cycle, so the
    // result queue samples `dot_res` exactly DOT_LAT cycles after issue.
    // Each lane forms the four signed byte-products a_i*b_i in parallel (one DSP each,
    // AREG/BREG + MREG + PREG → clean DSP pack) and reduces them through a registered
    // adder tree. Per-operand signedness (sa/sb) is set by the funct3 variant (DOT8_*):
    //   SS: both signed   UU: both unsigned   SU: rs1 signed, rs2 unsigned (weight×act).
    // An unsigned byte extends with a 0 sign bit; a signed byte sign-extends — so a single
    // signed 9×9 multiply serves every variant. Sum of 4 products ≤ ±260 100 → fits 32b.
    // Latency: q-capture(1) + A/B reg(1) + M(1) + P(1) + add(1) + add(1) = 6 = DOT_LAT.
    genvar gd;
    generate
        for (gd = 0; gd < NL; gd++) begin : g_idot
            logic sa, sb;   // per-operand signedness (see DOT8_* in simtix_pkg)
            assign sa = (q_dot_mode == DOT8_SS) || (q_dot_mode == DOT8_SU);
            assign sb = (q_dot_mode == DOT8_SS);
            // Stage 0: sign/zero-extend the four byte pairs to 9-bit signed (DSP A/B regs).
            logic signed [8:0] a0, a1, a2, a3, b0, b1, b2, b3;
            always_ff @(posedge clk) begin
                a0 <= $signed({sa & q_dot_a[gd][ 7], q_dot_a[gd][ 7: 0]});
                a1 <= $signed({sa & q_dot_a[gd][15], q_dot_a[gd][15: 8]});
                a2 <= $signed({sa & q_dot_a[gd][23], q_dot_a[gd][23:16]});
                a3 <= $signed({sa & q_dot_a[gd][31], q_dot_a[gd][31:24]});
                b0 <= $signed({sb & q_dot_b[gd][ 7], q_dot_b[gd][ 7: 0]});
                b1 <= $signed({sb & q_dot_b[gd][15], q_dot_b[gd][15: 8]});
                b2 <= $signed({sb & q_dot_b[gd][23], q_dot_b[gd][23:16]});
                b3 <= $signed({sb & q_dot_b[gd][31], q_dot_b[gd][31:24]});
            end
            // Stage 1-2: four signed byte-products on DSPs (MREG then PREG).
            (* use_dsp = "yes" *) logic signed [17:0] m0, m1, m2, m3;
            logic signed [17:0] p0, p1, p2, p3;
            always_ff @(posedge clk) begin
                m0 <= a0 * b0;  m1 <= a1 * b1;  m2 <= a2 * b2;  m3 <= a3 * b3;
                p0 <= m0;       p1 <= m1;       p2 <= m2;       p3 <= m3;
            end
            // Stage 3-4: registered adder tree → 32-bit signed dot product.
            logic signed [31:0] s01, s23, dsum;
            always_ff @(posedge clk) begin
                s01  <= 32'($signed(p0)) + 32'($signed(p1));   // sign-extend 18b→32b
                s23  <= 32'($signed(p2)) + 32'($signed(p3));
                dsum <= s01 + s23;
            end
            assign dot_res[gd] = dsum;
        end
    endgenerate

    // ── M16: ONE shared serial divide/sqrt core, sequenced over the active lanes ─────
    // M14.3 placed a full fp_divsqrt in EVERY lane (8 cores ~= 5.5k LUT) running in
    // lockstep. Placed timing (M15) showed the FP datapath is interconnect-bound, so we
    // fold the eight cores into ONE shared core fed lane-by-lane. At issue we CAPTURE
    // every lane's operands (the live frv* read tracks the issuing warp and moves on to
    // other warps while the SFU iterates for tens of cycles), then walk the active lanes
    // serially through the single core, one result per ~26 (div) / 37 (sqrt) cycles.
    // This trades latency (k active lanes -> ~k x slower) for ~5k LUT and the congestion
    // relief that recovers Fmax. At most one warp's div/sqrt is in flight, as before.
    logic [31:0]      sfu_opa [0:NL-1];   // captured per-lane dividend / radicand
    logic [31:0]      sfu_opb [0:NL-1];   // captured per-lane divisor (unused for sqrt)
    logic             sfu_is_sqrt_r;      // captured op (sqrt vs divide) for the warp
    logic [1:0]       sfu_fmt_r;          // captured format (FP32 / FP16)
    logic [LIDXW-1:0] sfu_lane;           // lane currently in the shared core
    logic             sfu_core_start;     // 1-cycle launch pulse to the shared core
    logic             sfu_core_done;
    logic [31:0]      sfu_core_res;

    /* verilator lint_off PINCONNECTEMPTY */
    fp_divsqrt u_sfu (
        .clk(clk), .rst(rst),
        .start(sfu_core_start), .is_sqrt(sfu_is_sqrt_r), .fmt(sfu_fmt_r),
        .a(sfu_opa[sfu_lane]), .b(sfu_opb[sfu_lane]),
        .busy(), .done(sfu_core_done), .res(sfu_core_res)
    );
    /* verilator lint_on PINCONNECTEMPTY */

    // Lane sequencer priority encoders (descending loop -> lowest matching index wins):
    // sfu_first_lane = lowest active lane of the issuing warp; sfu_next_lane/sfu_more =
    // the lowest active lane strictly above the one in flight, and whether one remains.
    logic [NL-1:0]    sfu_mask;           // active mask of the warp parked on the SFU
    logic [LIDXW-1:0] sfu_first_lane, sfu_next_lane;
    logic             sfu_more;
    always_comb begin
        sfu_first_lane = '0;
        for (int l = NL-1; l >= 0; l--) if (cur_mask[l]) sfu_first_lane = l[LIDXW-1:0];
    end
    always_comb begin
        sfu_next_lane = sfu_lane;
        sfu_more      = 1'b0;
        for (int l = NL-1; l >= 0; l--)
            if ((l[LIDXW-1:0] > sfu_lane) && sfu_mask[l]) begin
                sfu_next_lane = l[LIDXW-1:0];
                sfu_more      = 1'b1;
            end
    end

    // SFU scoreboard: which warp is parked, its active mask + dest f-reg + resume PC,
    // and the held result between `done` and its f-file writeback.
    typedef enum logic [1:0] { SFU_IDLE, SFU_RUN, SFU_WB } sfu_st_e;
    sfu_st_e          sfu_state;
    logic [WIDXW-1:0] sfu_w;
    logic [4:0]       sfu_rd;
    logic [31:0]      sfu_resume_pc;
    logic [31:0]      sfu_hold [0:NL-1];
    logic             sfu_wb_fire;    // SFU result drives the f-file this cycle

    // ── M15→B2: pipelined FP-compute (add/sub/mul/FMA/cvt/cmp/...) ────────────────────
    // The FPU multiply/FMA cone was the longest path; simt_fpu is now a 5-STAGE pipeline
    // (operands in cycle T -> result `fpu_res` in cycle T+5), the depth set by making the
    // significand multiply a fully-pipelined DSP (clean DRC, B2). To consume the late
    // result correctly, at issue the operands are captured and the op's tag enters a
    // delay line; at its end the result is queued, then written back when the destination
    // port is free (it YIELDS the f-file/VRF port to the memory and SFU engines). The
    // register scoreboard (v3 B2) stops later instructions from using it too early.
    logic        do_fp;             // issue is an FP-compute op (not div/sqrt, not mem)
    logic        sb_stall;          // v3 B2: X-stage instr held back by the scoreboard
    logic        do_mul;            // issue is an RV32M `mul` (integer-multiply unit)
    logic        do_dot;            // issue is a `pdot8` INT8 dot (dot unit)
    // v3 B2: the FPC unit is PIPELINED. simt_fpu carries its control down its own delay
    // line, so a new FP-compute warp instruction may enter every cycle. A result queue
    // (wp_resq, end of this file) carries the op's tag in step with the FPU and queues the
    // result; its head writes back when its port is free. The issuing warp does not wait:
    // its PC advances at issue and the register scoreboard (pend_x/pend_f, below) holds
    // back any later instruction that reads or rewrites the pending register. The
    // multiply, dot and shuffle units below use the same scheme.
    typedef struct packed {
        logic [WIDXW-1:0] w;
        logic [4:0]       rd;
        logic             isfp;       // 1: result -> f-file; 0: -> integer VRF
        logic [NL-1:0]    we;         // per-lane writeback enable (mask + x0 guard)
    } mc_tag_t;
    localparam int    RQ_DEPTH = 8;   // ops in flight per unit (pipe + result queue)
    localparam int    FPC_LAT = 6;    // issue -> fpu_res: q-capture (1) + FPU stages (5)
    mc_tag_t          fpc_hd;         // result-queue head
    logic             fpc_vld;        // result queue not empty
    logic             fpc_rdy;        // unit can take another op
    logic [WIDXW-1:0] fpc_w;
    logic [4:0]       fpc_rd;
    logic             fpc_isfp;
    logic [NL-1:0]    fpc_we;
    logic [31:0]      fpc_data [0:NL-1];
    logic             fpc_wb_fire;    // queue head drives its port this cycle

    // ── B1: pipelined integer multiply ───────────────────────────────────────────────
    // Mirrors the FPC unit: operands captured at issue (q_mul_a/b), the decomposed DSP
    // tree computes, then the per-lane products are queued and written
    // back to the INTEGER VRF when the port is free (yields to the memory + FPC
    // engines). mul is always integer-dest. A new mul may enter every cycle (v3 B2).
    localparam int    MUL_LAT = 7;    // issue -> mul_res: q-capture (1) + 6 stages
    mc_tag_t          mul_hd;
    logic             mul_vld, mul_rdy;
    logic [WIDXW-1:0] mul_w;
    logic [4:0]       mul_rd;
    logic [NL-1:0]    mul_we;         // per-lane writeback enable (mask + x0 guard)
    logic [31:0]      mul_data [0:NL-1];
    logic             mul_wb_fire;    // queue head drives the integer VRF this cycle

    // ── AI: pipelined INT8 dot product ────────────────────────────────────────────────
    // Mirrors the multiply unit: operands captured at issue (q_dot_a/b), each lane's
    // four DSP byte-products and adder tree compute, then the per-lane
    // dot results are queued and written back to the INTEGER VRF when the port is free
    // (yields to the memory + FPC + MUL engines). pdot8 is always integer-dest.
    // Latency: q-capture (1) + byte extend (1) + M (1) + P (1) + two adds (2) = 6.
    localparam int    DOT_LAT = 6;
    mc_tag_t          dot_hd;
    logic             dot_vld, dot_rdy;
    logic [WIDXW-1:0] dot_w;
    logic [4:0]       dot_rd;
    logic [NL-1:0]    dot_we;         // per-lane writeback enable (mask + x0 guard)
    logic [31:0]      dot_data [0:NL-1];
    logic             dot_wb_fire;    // queue head drives the integer VRF this cycle

    // ── v2: cross-lane shuffle engine ───────────────────────────────────────────────
    // Same shape as the multiply unit. At issue each lane's source index is
    // computed from its rs2 and captured with every lane's rs1, so the 8:1 lane
    // crossbar reads registers and stays off the VRF-read critical path. The cycle
    // after issue the crossbar output is queued; the head writes the integer VRF when
    // the port is free.
    localparam int    SHF_LAT = 1;
    mc_tag_t          shf_hd;
    logic             shf_vld, shf_rdy;
    logic [WIDXW-1:0] shf_w;
    logic [4:0]       shf_rd;
    logic [NL-1:0]    shf_we;         // per-lane writeback enable (mask + x0 guard)
    logic [31:0]      q_shf_val [0:NL-1];   // captured rs1 of every lane
    logic [LIDXW-1:0] q_shf_src [0:NL-1];   // captured source lane per lane
    logic [NL-1:0]    q_shf_ok;             // source in range (else keep own value)
    logic [31:0]      shf_data  [0:NL-1];
    logic             shf_wb_fire;
    logic             do_shf;         // issue is a warp shuffle (shuffle unit)
    logic             do_bar;         // issue is a block barrier (parks on W_BAR)

    logic [LIDXW-1:0] shf_src [0:NL-1];
    logic [NL-1:0]    shf_ok;
    always_comb begin
        for (int l = 0; l < NL; l++) begin
            logic [31:0] s;
            unique case (funct3)
                SHFL_IDX:  s = rv2[l] & (NL - 1);
                SHFL_UP:   s = l - rv2[l];
                SHFL_DOWN: s = l + rv2[l];
                default:   s = l ^ rv2[l];          // SHFL_XOR
            endcase
            shf_ok[l]  = (s < NL);                  // UP below 0 wraps to a large value
            shf_src[l] = s[LIDXW-1:0];
        end
    end

    // RV32A read-modify-write: new memory word from the old word m and rs2 value v.
    always_comb begin
        for (int l = 0; l < NL; l++) begin
            logic [31:0] a, b, y;
            rv1[l] = (rs1 == 5'd0) ? 32'd0 :
                     (reg_written[issue_w][l][rs1] ? vrf_rd1[l]
                                                   : seed_val(issue_w, l[LIDXW-1:0], rs1));
            rv2[l] = (rs2 == 5'd0) ? 32'd0 :
                     (reg_written[issue_w][l][rs2] ? vrf_rd2[l]
                                                   : seed_val(issue_w, l[LIDXW-1:0], rs2));
            // FP sources: no x0 hardwiring (f0 is real); unwritten reads 0.
            frv1[l] = freg_written[issue_w][l][rs1] ? frf_rd1[l] : 32'd0;
            frv2[l] = freg_written[issue_w][l][rs2] ? frf_rd2[l] : 32'd0;
            frv3[l] = freg_written[issue_w][l][rs3] ? frf_rd3[l] : 32'd0;

            unique case (opcode)
                OP_OP:     begin a = rv1[l]; b = rv2[l]; end
                OP_OPIMM:  begin a = rv1[l]; b = i_imm;  end
                OP_LOAD,
                OP_LOADFP: begin a = rv1[l]; b = i_imm;  end
                OP_STORE,
                OP_STOREFP:begin a = rv1[l]; b = s_imm;  end
                OP_AMO:    begin a = rv1[l]; b = 32'd0;  end   // AMO address = rs1
                OP_LUI:    begin a = 32'd0;  b = u_imm;  end
                OP_AUIPC:  begin a = cur_pc; b = u_imm;  end
                default:   begin a = rv1[l]; b = rv2[l]; end
            endcase

            unique case (alu_ctrl)
                ALU_ADD:  y = a + b;
                ALU_SUB:  y = a - b;
                ALU_AND:  y = a & b;
                ALU_OR:   y = a | b;
                ALU_XOR:  y = a ^ b;
                ALU_SLT:  y = ($signed(a) < $signed(b)) ? 32'd1 : 32'd0;
                ALU_SLTU: y = (a < b) ? 32'd1 : 32'd0;
                ALU_SLL:  y = a << b[4:0];
                ALU_SRL:  y = a >> b[4:0];
                ALU_SRA:  y = $signed(a) >>> b[4:0];
                ALU_PASSB:y = b;
                ALU_MUL:  y = 32'd0;            // B1: `mul` executes in the DSP multiply unit
                default:  y = 32'd0;
            endcase

            addr[l]  = y;
        end
    end

    logic [31:0] x_res [0:NL-1];
    always_comb begin
        for (int l = 0; l < NL; l++) begin
            logic lt;
            lt = funct3[0] ? (rv1[l] < rv2[l]) : ($signed(rv1[l]) < $signed(rv2[l]));
            if (x_sh)      x_res[l] = rv2[l] + (rv1[l] << funct3[2:1]);
            else if (x_mm) x_res[l] = (lt ^ funct3[1]) ? rv1[l] : rv2[l];
            else           x_res[l] = ((rv2[l] == 32'd0) ^ funct3[1]) ? 32'd0 : rv1[l];
        end
    end

    // Integer-VRF writeback value/enable for the single-cycle INTEGER compute ops
    // (ALU, jal/jalr link, csr tid). FP-compute results no longer commit here in the
    // issue cycle — they are registered and written back through the FPC pipeline
    // (u_fpc_q), so this block is integer-only. Kept SEPARATE from the operand reads
    // above to avoid a false UNOPTFLAT loop (fpu_res depends on rv1).
    always_comb begin
        for (int l = 0; l < NL; l++) begin
            logic [31:0] tid_l;
            tid_l = warp_base[issue_w] + l[31:0];
            wb_val[l] = 32'd0;
            wb_en[l]  = 1'b0;
            unique case (opcode)
                OP_OP, OP_OPIMM, OP_LUI, OP_AUIPC: begin wb_val[l] = x_op ? x_res[l] : addr[l];
                                                         wb_en[l] = 1'b1; end
                OP_JAL, OP_JALR:                   begin wb_val[l] = cur_pc + 32'd4; wb_en[l] = 1'b1; end
                OP_SYSTEM: if (is_csr)             begin wb_val[l] = tid_l;         wb_en[l] = 1'b1; end
                default: ;
            endcase
            if (rd == 5'd0)        wb_en[l] = 1'b0;
            if (!cur_mask[l])      wb_en[l] = 1'b0;   // masked-off lanes do nothing

            // Per-lane FP-compute writeback enable, captured at issue into fpc_we:
            // f-dest writes f0..f31 (no x0 guard), int-dest (cmp/cvt.w/fmv.x.w)
            // honors rd!=x0. Masked-off lanes never write.
            fwb_en[l]  = cur_mask[l] && (wb_is_fp || (rd != 5'd0));
            // B1: per-lane integer-mul writeback enable, captured at issue into mul_we.
            // mul is integer-dest, so honor rd!=x0; masked-off lanes never write.
            mwb_en[l]  = cur_mask[l] && (rd != 5'd0);
            // AI: per-lane INT8-dot writeback enable, captured at issue into dot_we.
            // pdot8 is integer-dest, same rd!=x0 + mask guards as mul.
            dwb_en[l]  = cur_mask[l] && (rd != 5'd0);
        end
    end

    // ── Per-lane branch decision + divergence masks ─────────────────────────────────
    logic [NL-1:0] btaken;     // active lanes whose branch condition is true
    always_comb begin
        for (int l = 0; l < NL; l++) begin
            logic t;
            unique case (funct3)
                3'b000:  t = (rv1[l] == rv2[l]);
                3'b001:  t = (rv1[l] != rv2[l]);
                3'b100:  t = ($signed(rv1[l]) <  $signed(rv2[l]));
                3'b101:  t = ($signed(rv1[l]) >= $signed(rv2[l]));
                3'b110:  t = (rv1[l] <  rv2[l]);
                3'b111:  t = (rv1[l] >= rv2[l]);
                default: t = 1'b0;
            endcase
            btaken[l] = cur_mask[l] & t;
        end
    end

    logic [NL-1:0] taken_mask;            // (not taken: br_mask & ~br_taken, in stage B)
    assign taken_mask  = btaken;

    // Branch/jump targets (relative to the issuing warp's TOS PC).
    logic [31:0] fallthru, br_target, jal_target, jalr_target;
    assign fallthru    = cur_pc + 32'd4;
    assign br_target   = cur_pc + b_imm;
    assign jal_target  = cur_pc + j_imm;
    assign jalr_target = (rv1[first_l] + i_imm) & ~32'd1;   // assumed uniform

    // A memory op targets the scratchpad if the leader lane's effective address
    // is in the SCRATCH_BASE aperture (bits[31:30]==2'b01). A given instruction
    // is assumed uniformly scratch-or-global across its active lanes.
    logic issue_is_scratch, issue_is_shared;
    assign issue_is_scratch = (addr[first_l][31:30] == 2'b01);
    assign issue_is_shared  = issue_is_scratch && addr[first_l][29];   // SHARED_BASE

// ── Memory engine ───────────────────────────────────────────────────────────────
    // A memory op is handed over when the X stage resolves it. For a store or AMO the
    // warp parks in W_MEM until the engine resumes it; for a load (v3) it goes on and
    // the load's rd stays pending until the engine reports the load finished (rs_ld).
    // See mem_engine.sv.
    assign me_in_valid = issue_valid && !do_pop && !sb_stall && !is_ecall && is_mem;
    always_comb
        for (int l = 0; l < NL; l++)
            me_sdata[l] = is_store_fp ? frv2[l] : rv2[l];   // fsw stores an f-register

    logic [31:0] me_dbg [0:DBG_ME-1];          // its debug-window words
    mem_engine #(.NC(MEM_CTX), .AGG(AMO_AGG), .APAR(AMO_PAR), .BYP(MEM_BYP)) u_mem (
        .clk        (clk),
        .rst        (rst),
        .blk_lg     (blk_lg),
        .in_valid   (me_in_valid),
        .in_ready   (me_in_ready),
        .in_w       (issue_w),
        .in_mask    (cur_mask),
        .in_store   (is_store),
        .in_scratch (issue_is_scratch),
        .in_shared  (issue_is_shared),
        .in_fp      (is_fp_mem),
        .in_amo     (is_amo),
        .in_amo_op  (amo_op),
        .in_funct3  (funct3),
        .in_rd      (rd),
        .in_next_pc (fallthru),
        .in_addr    (addr),
        .in_sdata   (me_sdata),
        .wb_lane    (mem_wb_lane),
        .wb_data    (mem_wb_data),
        .wb_w       (me_wb_w),
        .wb_rd      (me_wb_rd),
        .wb_fp      (me_wb_fp),
        .rs_valid   (me_rs_valid),
        .rs_w       (me_rs_w),
        .rs_pc      (me_rs_pc),
        .rs_rd      (me_rs_rd),
        .rs_fp      (me_rs_fp),
        .rs_ld      (me_rs_ld),
        .busy       (me_busy),
        .fp_busy    (me_fp_busy),
        .dmem_req   (dmem_req),
        .dmem_gnt   (dmem_gnt),
        .dmem_tag   (dmem_tag),
        .dmem_addr  (dmem_addr),
        .dmem_wdata (dmem_wdata),
        .dmem_we    (dmem_we),
        .dmem_be    (dmem_be),
        .dmem_rvalid(dmem_rvalid),
        .dmem_rtag  (dmem_rtag),
        .dmem_rdata (dmem_rdata),
        .gtxn       (me_gtxn),
        .stxn       (me_stxn),
        .dbg_state  (me_dbg)
    );

    // ── "Anything still running?" (combinational over current state) ────────────────
    logic any_busy;
    always_comb begin
        any_busy = (next_wid != total_warps);   // warps still to spawn
        for (int k = 0; k < NW; k++)
            // A warp reaches W_DONE only with nothing pending (ecall waits), so the
            // unit queues are empty once every warp is done.
            if ((wstate[k] == W_RUN) || (wstate[k] == W_MEM) ||
                (wstate[k] == W_SFU) || (wstate[k] == W_BAR)) any_busy = 1'b1;
        if (me_busy) any_busy = 1'b1;             // a memory op still in flight
    end

    // ── VRF write arbiter (one write port per lane bank) ────────────────────────────
    // Two producers may target the file in the same cycle: the issue stage's compute
    // writeback (warp issue_w) and the memory engine's load result (warp mem_w). A
    // LUTRAM bank has ONE write port, so the memory writeback wins and the compute
    // writeback is squashed that cycle — the instruction simply re-issues next cycle
    // (it is idempotent: same VRF in → same result out). Stores and rd==x0 never
    // write the file.
    logic             do_compute;             // issue is a committing compute instr
    logic             squash_wb;              // its writeback is squashed by a mem write

    logic             v_we [0:NL-1];          // per-lane VRF write enable
    logic [VAW-1:0]   v_wa [0:NL-1];          // …address {warp,reg}
    logic [31:0]      v_wd [0:NL-1];          // …data
    logic [WIDXW-1:0] v_ww [0:NL-1];          // …warp (for the valid bit)
    logic [4:0]       v_wr [0:NL-1];          // …reg  (for the valid bit)

    // M14.0: FP-file write port (separate bank → no contention with the integer
    // VRF). The only FP writer in M14.0 is an `flw` load result; M14.1 adds the
    // FPU compute writeback through the same signals.
    logic             fv_we [0:NL-1];
    logic [VAW-1:0]   fv_wa [0:NL-1];
    logic [31:0]      fv_wd [0:NL-1];
    logic [WIDXW-1:0] fv_ww [0:NL-1];
    logic [4:0]       fv_wr [0:NL-1];

    assign mem_wb_act     = |mem_wb_lane;

    // ── v3 B2 step 2: register scoreboard ──────────────────────────────────────────
    // pend_x / pend_f mark, per warp, the integer / FP registers whose value is still in
    // the FP, multiply, dot or shuffle unit or its result queue: set at issue, cleared
    // at writeback. The X-stage instruction is held back (sb_stall: the warp re-enters
    // the fetch pool and retries, like a busy memory engine) when a register it reads
    // or writes is pending, when its unit is full, or when it is an ecall with results
    // still outstanding (they must land before the warp slot can be reused). Only the
    // registers the opcode really reads are checked: an immediate field that happens to
    // name a pending register must not stall.
    logic [31:0] pend_x [0:NW-1];
    logic [31:0] pend_f [0:NW-1];
    logic        use_x1, use_x2, use_f1, use_f2, use_f3, def_x, def_f;
    logic        cls_fp, cls_mul, cls_dot, cls_shf;   // unit the instruction goes to
    logic        fp_src_x;                            // OP-FP whose rs1 is an x-reg
    assign fp_src_x = is_fp_op && ((fp_funct5 == FP_CVT_S) || (fp_funct5 == FP_FMVWX));
    assign use_x1 = (opcode == OP_OP)     || (opcode == OP_OPIMM)   || (opcode == OP_JALR)  ||
                    (opcode == OP_BRANCH) || (opcode == OP_LOAD)    || (opcode == OP_STORE) ||
                    (opcode == OP_LOADFP) || (opcode == OP_STOREFP) || (opcode == OP_AMO)   ||
                    (opcode == OP_CUSTOM0) || is_csr || fp_src_x;
    assign use_x2 = (opcode == OP_OP)     || (opcode == OP_BRANCH)  || (opcode == OP_STORE) ||
                    (opcode == OP_AMO)    || (opcode == OP_CUSTOM0);
    assign use_f1 = (is_fp_op && !fp_src_x) || is_fma_op;
    assign use_f2 = (is_fp_op && ((fp_funct5 == FP_ADD)  || (fp_funct5 == FP_SUB)    ||
                                  (fp_funct5 == FP_MUL)  || (fp_funct5 == FP_DIV)    ||
                                  (fp_funct5 == FP_SGNJ) || (fp_funct5 == FP_MINMAX) ||
                                  (fp_funct5 == FP_CMP))) ||
                    is_fma_op || (opcode == OP_STOREFP);
    assign use_f3 = is_fma_op;
    assign def_x  = (opcode == OP_OP)  || (opcode == OP_OPIMM) || (opcode == OP_LUI)  ||
                    (opcode == OP_AUIPC) || (opcode == OP_JAL) || (opcode == OP_JALR) ||
                    (opcode == OP_LOAD) || (opcode == OP_AMO)  ||
                    ((opcode == OP_CUSTOM0) && !is_bar) || is_csr || fp_int_dest;
    assign def_f  = (opcode == OP_LOADFP) || is_fma_op || (is_fp_op && !fp_int_dest);
    assign cls_fp  = !is_mem && ((is_fp_op && !is_sfu_op) || is_fma_op);
    assign cls_mul = !is_mem && !is_sfu_op && is_mul;
    assign cls_dot = !is_mem && !is_sfu_op && is_dot;
    assign cls_shf = !is_mem && !is_sfu_op && is_shfl;
    logic sb_haz, sb_full;            // a register is pending / the unit is full
    // v3: loads in flight per warp. A warp may have LD_MAX loads outstanding; a store,
    // AMO, barrier or ecall waits until it has none, so a warp's own memory accesses
    // keep their order where it matters (a store never overtakes an earlier load of
    // the same warp, and a barrier orders loads before it against stores after it).
    localparam int LD_MAX = (MEM_CTX / NW > 0) ? MEM_CTX / NW : 1;
    logic [3:0]  ld_out [0:NW-1];
    logic        ld_inc;              // a load is handed to the memory engine this cycle
    assign ld_inc = me_in_valid && me_in_ready && is_load;
    assign sb_haz =
        (use_x1 && pend_x[issue_w][rs1]) || (use_x2 && pend_x[issue_w][rs2]) ||
        (use_f1 && pend_f[issue_w][rs1]) || (use_f2 && pend_f[issue_w][rs2]) ||
        (use_f3 && pend_f[issue_w][rs3]) ||
        (def_x && pend_x[issue_w][rd])   || (def_f && pend_f[issue_w][rd])   ||
        (is_ecall && ((pend_x[issue_w] != '0) || (pend_f[issue_w] != '0))) ||
        (is_load && (ld_out[issue_w] >= 4'(LD_MAX))) ||
        ((is_store || is_amo || is_bar || is_ecall) && (ld_out[issue_w] != '0));
    assign sb_full =
        (cls_fp && !fpc_rdy) || (cls_mul && !mul_rdy) ||
        (cls_dot && !dot_rdy) || (cls_shf && !shf_rdy);
    assign sb_stall = sb_haz || sb_full;
    // Wake-up: a register-hazard sleeper waits for a pending result of its own (one
    // exists, or it would not have stalled); a unit-full sleeper for any writeback.
    // sb_wfull holds the reason of the CURRENT sleep, so sb_wake is only used for warps
    // already asleep; a warp that stalls this cycle is judged by this cycle's reason
    // (sb_haz) in the issue step. (Using the stored reason there missed the wake-up of a
    // load-hazard stall whose last sleep was unit-full: 8-warp GEMM-RB hung.)
    always_comb begin
        sb_any = fpc_wb_fire || mul_wb_fire || dot_wb_fire || shf_wb_fire;
        for (int k = 0; k < NW; k++) begin
            sb_own[k]  = (fpc_wb_fire && (fpc_w == WIDXW'(k))) || (mul_wb_fire && (mul_w == WIDXW'(k))) ||
                         (dot_wb_fire && (dot_w == WIDXW'(k))) || (shf_wb_fire && (shf_w == WIDXW'(k))) ||
                         (me_rs_valid && me_rs_ld && (me_rs_w == WIDXW'(k)));
            sb_wake[k] = sb_wfull[k] ? sb_any : sb_own[k];
        end
    end
    // An FP-compute op (add/sub/mul/FMA/sgnj/min/max/cmp/cvt/fmv/fclass — NOT div/
    // sqrt, NOT a load/store): retires through the pipelined FPC unit (u_fpc_q).
    assign do_fp          = issue_valid && !do_pop && !sb_stall && !is_ecall && !is_mem &&
                            ((is_fp_op && !is_sfu_op) || is_fma_op);
    // B1: an RV32M `mul` — retires through the pipelined integer-multiply engine.
    assign do_mul         = issue_valid && !do_pop && !sb_stall && !is_ecall && !is_mem &&
                            !is_sfu_op && is_mul;
    // AI: a `pdot8` — retires through the pipelined INT8 dot engine.
    assign do_dot         = issue_valid && !do_pop && !sb_stall && !is_ecall && !is_mem &&
                            !is_sfu_op && is_dot;
    // A single-cycle INTEGER compute: not a pop/ecall/memory/divide-sqrt/FP-compute/
    // mul/dot.
    // v2: a warp shuffle and a block barrier (W_BAR).
    assign do_shf         = issue_valid && !do_pop && !sb_stall && !is_ecall && !is_mem &&
                            !is_sfu_op && is_shfl;
    assign do_bar         = issue_valid && !do_pop && !sb_stall && !is_ecall && !is_mem &&
                            !is_sfu_op && is_bar;
    logic do_ctl;   // a committed branch / jal / jalr (its stack update is in stage B)
    assign do_ctl = do_compute && !squash_wb &&
                    ((opcode == OP_BRANCH) || (opcode == OP_JAL) || (opcode == OP_JALR));
    assign do_compute     = issue_valid && !do_pop && !sb_stall && !is_ecall && !is_mem &&
                            !is_sfu_op && !do_fp && !do_mul && !do_dot &&
                            !do_shf && !do_bar;

    // The held SFU result drives the f-file when the unit is in writeback and the
    // memory engine is not using the FP port this cycle (mem wins; SFU result waits).
    assign sfu_wb_fire = (sfu_state == SFU_WB) && !me_fp_busy;

    // The held FP-compute result drives its destination port when ready. It YIELDS to
    // the (non-deferrable) memory engine on the relevant port, and to the SFU on the
    // f-file — so it never collides; if blocked, the result simply waits at the head of
    // its queue (its register stays pending).
    assign fpc_wb_fire = fpc_vld &&
                         ( fpc_isfp ? !((mem_wb_act && me_wb_fp) || sfu_wb_fire)
                                    : !(mem_wb_act && !me_wb_fp) );

    // B1: the held integer-mul result drives the integer VRF when the unit is in
    // writeback and that port is free. It is deferrable like FPC: it yields to the
    // (non-deferrable) integer memory writeback and to the integer-dest FPC writeback,
    // so it never collides; if blocked it waits at the head of its result queue.
    assign mul_wb_fire = mul_vld &&
                         !((mem_wb_act && !me_wb_fp) || (fpc_wb_fire && !fpc_isfp));

    // AI: the held INT8-dot result drives the integer VRF when the unit is in writeback
    // and the port is free. Deferrable like MUL: it yields to the integer memory
    // writeback, the integer-dest FPC writeback, AND the integer-mul writeback (it sits
    // one tier below mul in the same port); if blocked it waits at the queue head.
    assign dot_wb_fire    = dot_vld &&
                         !((mem_wb_act && !me_wb_fp) || (fpc_wb_fire && !fpc_isfp) ||
                           mul_wb_fire);

    // A single-cycle integer compute (always integer-VRF dest now) is squashed when
    // its port is taken this cycle by an integer memory load, the integer-dest FPC
    // writeback, or the integer-mul writeback. It re-issues next cycle (idempotent).
    // v2: the shuffle result sits one tier below the dot result on the integer port.
    assign shf_wb_fire    = shf_vld &&
                         !((mem_wb_act && !me_wb_fp) || (fpc_wb_fire && !fpc_isfp) ||
                           mul_wb_fire || dot_wb_fire);

    assign squash_wb      = do_compute &&
                            ((mem_wb_act && !me_wb_fp) || (fpc_wb_fire && !fpc_isfp) ||
                             mul_wb_fire || dot_wb_fire || shf_wb_fire);

    // v3 B2: one result queue per multi-cycle unit (wp_resq, end of this file). An op
    // enters its unit in the issue cycle; its tag is formed from the issue signals.
    logic [NL-1:0][31:0] fpc_res_p, mul_res_p, dot_res_p, shf_res_p;
    logic [NL-1:0][31:0] fpc_hd_d, mul_hd_d, dot_hd_d, shf_hd_d;
    mc_tag_t             fpc_in, int_in;
    logic                q_clr;
    always_comb
        for (int l = 0; l < NL; l++) begin
            fpc_res_p[l] = fpu_res[l];
            mul_res_p[l] = mul_res[l];
            dot_res_p[l] = dot_res[l];
            shf_res_p[l] = q_shf_ok[l] ? q_shf_val[q_shf_src[l]] : q_shf_val[l];
            fpc_data[l]  = fpc_hd_d[l];
            mul_data[l]  = mul_hd_d[l];
            dot_data[l]  = dot_hd_d[l];
            shf_data[l]  = shf_hd_d[l];
        end
    // mul uses mwb_en, pdot8 and the shuffle dwb_en; both are the mask + rd != x0.
    assign fpc_in = '{w: issue_w, rd: rd, isfp: wb_is_fp, we: fwb_en};
    assign int_in = '{w: issue_w, rd: rd, isfp: 1'b0, we: do_mul ? mwb_en : dwb_en};
    assign q_clr  = rst || start;
    wp_resq #(.LAT(FPC_LAT), .NL(NL), .DEPTH(RQ_DEPTH), .TW($bits(mc_tag_t))) u_fpc_q (
        .clk(clk), .clr(q_clr), .push(do_fp && running), .tag(fpc_in), .res(fpc_res_p),
        .pop(fpc_wb_fire), .rdy(fpc_rdy), .vld(fpc_vld), .hd_tag(fpc_hd), .hd_data(fpc_hd_d));
    wp_resq #(.LAT(MUL_LAT), .NL(NL), .DEPTH(RQ_DEPTH), .TW($bits(mc_tag_t))) u_mul_q (
        .clk(clk), .clr(q_clr), .push(do_mul && running), .tag(int_in), .res(mul_res_p),
        .pop(mul_wb_fire), .rdy(mul_rdy), .vld(mul_vld), .hd_tag(mul_hd), .hd_data(mul_hd_d));
    wp_resq #(.LAT(DOT_LAT), .NL(NL), .DEPTH(RQ_DEPTH), .TW($bits(mc_tag_t))) u_dot_q (
        .clk(clk), .clr(q_clr), .push(do_dot && running), .tag(int_in), .res(dot_res_p),
        .pop(dot_wb_fire), .rdy(dot_rdy), .vld(dot_vld), .hd_tag(dot_hd), .hd_data(dot_hd_d));
    wp_resq #(.LAT(SHF_LAT), .NL(NL), .DEPTH(RQ_DEPTH), .TW($bits(mc_tag_t))) u_shf_q (
        .clk(clk), .clr(q_clr), .push(do_shf && running), .tag(int_in), .res(shf_res_p),
        .pop(shf_wb_fire), .rdy(shf_rdy), .vld(shf_vld), .hd_tag(shf_hd), .hd_data(shf_hd_d));
    assign fpc_w = fpc_hd.w;  assign fpc_rd = fpc_hd.rd;  assign fpc_isfp = fpc_hd.isfp;
    assign fpc_we = fpc_hd.we;
    assign mul_w = mul_hd.w;  assign mul_rd = mul_hd.rd;
    assign mul_we = mul_hd.we;
    assign dot_w = dot_hd.w;  assign dot_rd = dot_hd.rd;
    assign dot_we = dot_hd.we;
    assign shf_w = shf_hd.w;  assign shf_rd = shf_hd.rd;
    assign shf_we = shf_hd.we;
    logic unused_int_isfp;            // the integer units' tags carry isfp = 0
    assign unused_int_isfp = mul_hd.isfp ^ dot_hd.isfp ^ shf_hd.isfp;

    always_comb begin
        for (int l = 0; l < NL; l++) begin
            v_we[l] = 1'b0;
            v_wa[l] = '0;
            v_wd[l] = 32'd0;
            v_ww[l] = '0;
            v_wr[l] = 5'd0;
            fv_we[l] = 1'b0;
            fv_wa[l] = '0;
            fv_wd[l] = 32'd0;
            fv_ww[l] = '0;
            fv_wr[l] = 5'd0;
            // The FP file (fv_we) and the integer VRF (v_we) are SEPARATE write ports.
            // FP-file port priority: flw load result > SFU div/sqrt > pipelined
            // FP-compute (fpc, f-dest). The two deferrable engines (SFU, FPC) yield to
            // the memory engine and, for FPC, to the SFU — see *_wb_fire above.
            if (mem_wb_lane[l] && me_wb_fp) begin                     // FP load writeback
                fv_we[l] = 1'b1;
                fv_ww[l] = me_wb_w;
                fv_wr[l] = me_wb_rd;
                fv_wa[l] = vaddr(me_wb_w, me_wb_rd);
                fv_wd[l] = mem_wb_data[l];
            end else if (sfu_wb_fire && sfu_mask[l]) begin             // SFU div/sqrt result
                fv_we[l] = 1'b1;
                fv_ww[l] = sfu_w;
                fv_wr[l] = sfu_rd;
                fv_wa[l] = vaddr(sfu_w, sfu_rd);
                fv_wd[l] = sfu_hold[l];
            end else if (fpc_wb_fire && fpc_isfp && fpc_we[l]) begin   // pipelined FP-compute (f)
                fv_we[l] = 1'b1;
                fv_ww[l] = fpc_w;
                fv_wr[l] = fpc_rd;
                fv_wa[l] = vaddr(fpc_w, fpc_rd);
                fv_wd[l] = fpc_data[l];
            end
            // Integer VRF port priority: integer load result > pipelined FP-compute
            // (fpc, int-dest: cmp/cvt.w/fmv.x.w/fclass) > single-cycle integer compute
            // (ALU/jal/jalr/csr). A colliding integer compute is squashed (squash_wb).
            if (mem_wb_lane[l] && !me_wb_fp) begin                    // integer mem writeback
                v_we[l] = 1'b1;
                v_ww[l] = me_wb_w;
                v_wr[l] = me_wb_rd;
                v_wa[l] = vaddr(me_wb_w, me_wb_rd);
                v_wd[l] = mem_wb_data[l];
            end else if (fpc_wb_fire && !fpc_isfp && fpc_we[l]) begin  // pipelined FP-compute (int)
                v_we[l] = 1'b1;
                v_ww[l] = fpc_w;
                v_wr[l] = fpc_rd;
                v_wa[l] = vaddr(fpc_w, fpc_rd);
                v_wd[l] = fpc_data[l];
            end else if (mul_wb_fire && mul_we[l]) begin               // pipelined integer-mul
                v_we[l] = 1'b1;
                v_ww[l] = mul_w;
                v_wr[l] = mul_rd;
                v_wa[l] = vaddr(mul_w, mul_rd);
                v_wd[l] = mul_data[l];
            end else if (dot_wb_fire && dot_we[l]) begin               // pipelined INT8-dot
                v_we[l] = 1'b1;
                v_ww[l] = dot_w;
                v_wr[l] = dot_rd;
                v_wa[l] = vaddr(dot_w, dot_rd);
                v_wd[l] = dot_data[l];
            end else if (shf_wb_fire && shf_we[l]) begin               // warp shuffle
                v_we[l] = 1'b1;
                v_ww[l] = shf_w;
                v_wr[l] = shf_rd;
                v_wa[l] = vaddr(shf_w, shf_rd);
                v_wd[l] = shf_data[l];
            end else if (do_compute && !squash_wb && wb_en[l]) begin   // int compute writeback
                v_we[l] = 1'b1;
                v_ww[l] = issue_w;
                v_wr[l] = rd;
                v_wa[l] = vaddr(issue_w, rd);
                v_wd[l] = wb_val[l];
            end
        end
    end

    // ── Per-lane VRF banks (distributed RAM) ────────────────────────────────────────
    // One 1D array per lane: a single sync write port + two async read ports. This is
    // the canonical LUTRAM pattern; the ram_style attribute pins it to distributed RAM.
    genvar gl;
    generate
        for (gl = 0; gl < NL; gl++) begin : g_vrf
            (* ram_style = "distributed" *)
            logic [31:0] bank [0:VDEPTH-1];
            always_ff @(posedge clk)
                if (v_we[gl]) bank[v_wa[gl]] <= v_wd[gl];
            assign vrf_rd1[gl] = bank[vaddr(issue_w, rs1)];
            assign vrf_rd2[gl] = bank[vaddr(issue_w, rs2)];
        end
    endgenerate

    // ── Per-lane FP register-file banks (distributed RAM) — M14.0 ────────────────────
    // Same LUTRAM pattern as the integer VRF, but THREE async read ports (fs1/fs2/
    // fs3) feed the future FMA. One sync write port; in M14.0 the only writer is an
    // flw load result (fv_we), M14.1 adds the FPU compute writeback.
    genvar gf;
    generate
        for (gf = 0; gf < NL; gf++) begin : g_frf
            (* ram_style = "distributed" *)
            logic [31:0] bank [0:VDEPTH-1];
            always_ff @(posedge clk)
                if (fv_we[gf]) bank[fv_wa[gf]] <= fv_wd[gf];
            assign frf_rd1[gf] = bank[vaddr(issue_w, rs1)];
            assign frf_rd2[gf] = bank[vaddr(issue_w, rs2)];
            assign frf_rd3[gf] = bank[vaddr(issue_w, rs3)];
        end
    endgenerate

    // ── Sequential update ───────────────────────────────────────────────────────────
    always_ff @(posedge clk) begin
        if (rst) begin
            running        <= 1'b0;
            busy           <= 1'b0;
            done           <= 1'b0;
            next_wid       <= 32'd0;
            total_warps    <= 32'd0;
            rr_ptr         <= '0;
            sfu_state      <= SFU_IDLE;
            sfu_core_start <= 1'b0;
            for (int k = 0; k < NW; k++) pend_x[k] <= '0;
            for (int k = 0; k < NW; k++) pend_f[k] <= '0;
            sb_wait        <= '0;
            sb_wfull       <= '0;
            for (int k = 0; k < NW; k++) ld_out[k] <= '0;
            blk_lg         <= '0;
            issue_valid    <= 1'b0;
            instr          <= 32'd0;
            for (int k = 0; k < NW; k++) inflight[k] <= 1'b0;
            br_v           <= 1'b0;
            dbg_retire_a0  <= 32'd0;
            dbg_mem_txns   <= 32'd0;
            dbg_divergences<= 32'd0;
            dbg_scratch_txns<= 32'd0;
            dbg_issued_insns<= 32'd0;
            dbg_active_lanes<= 32'd0;
            for (int k = 0; k < NW; k++) wstate[k] <= W_EMPTY;
            // Two single-statement loops (NOT one begin/end body): Verilator's
            // array-init pass only accepts a lone delayed array write per for loop
            // (BLKLOOPINIT on 5.020), so reg/freg clears stay separate.
            for (int k = 0; k < NW; k++)
                for (int l = 0; l < NL; l++)
                    for (int r = 0; r < 32; r++) reg_written[k][l][r] <= 1'b0;
            for (int k = 0; k < NW; k++)
                for (int l = 0; l < NL; l++)
                    for (int r = 0; r < 32; r++) freg_written[k][l][r] <= 1'b0;
        end else begin
            done <= 1'b0;                         // default: 1-cycle pulse

            if (start) begin
                // Latch the grid and arm the spawner; clear all slots.
                arg_a       <= base_a;
                arg_b       <= base_b;
                arg_c       <= base_c;
                arg_n       <= n_threads;
                arg_pc      <= kernel_pc;
                total_warps <= (n_threads + WSZ - 1) / WSZ;
                next_wid       <= 32'd0;
                rr_ptr         <= '0;
                sfu_state      <= SFU_IDLE;
                sfu_core_start <= 1'b0;
                for (int k = 0; k < NW; k++) pend_x[k] <= '0;
                for (int k = 0; k < NW; k++) pend_f[k] <= '0;
                sb_wait        <= '0;
                sb_wfull       <= '0;
                for (int k = 0; k < NW; k++) ld_out[k] <= '0;
                blk_lg         <= (block_log2 > 3'(LOGNW)) ? 3'(LOGNW) : block_log2;
                issue_valid    <= 1'b0;
                for (int k = 0; k < NW; k++) inflight[k] <= 1'b0;
                br_v           <= 1'b0;
                dbg_mem_txns   <= 32'd0;
                dbg_divergences<= 32'd0;
                dbg_scratch_txns<= 32'd0;
                dbg_issued_insns<= 32'd0;
                dbg_active_lanes<= 32'd0;
                running        <= 1'b1;
                busy           <= 1'b1;
                for (int k = 0; k < NW; k++) wstate[k] <= W_EMPTY;
            end else if (running) begin
                // 1) Spawn step: drop the next block into the free group fill_g (slots
                //    chosen by spawn_en). No VRF clear here (that 1-cycle 32-register
                //    write blocked RAM inference). Instead mark every register unwritten
                //    so reads return their spawn seed (a0=tid, a1..a4=args, else 0).
                //    One single-statement loop per array (see BLKLOOPINIT note); 5.020
                //    accepts the nested clears only with the if outside the l/r loops.
                for (int k = 0; k < NW; k++)
                    if (spawn_en[k])
                        for (int l = 0; l < NL; l++)
                            for (int r = 0; r < 32; r++) reg_written[k][l][r] <= 1'b0;
                for (int k = 0; k < NW; k++)
                    if (spawn_en[k])
                        for (int l = 0; l < NL; l++)
                            for (int r = 0; r < 32; r++) freg_written[k][l][r] <= 1'b0;
                for (int k = 0; k < NW; k++) if (spawn_en[k]) warp_base[k] <= spawn_base[k];
                // Seed the SIMT stack: base frame = whole warp at kernel_pc.
                for (int k = 0; k < NW; k++) if (spawn_en[k]) sp[k] <= '0;
                for (int k = 0; k < NW; k++) if (spawn_en[k]) stk_npc[k][0] <= arg_pc;
                for (int k = 0; k < NW; k++) if (spawn_en[k]) stk_rpc[k][0] <= RPC_BOTTOM;
                for (int k = 0; k < NW; k++) if (spawn_en[k]) stk_mask[k][0] <= spawn_mask[k];
                for (int k = 0; k < NW; k++) if (spawn_en[k]) wstate[k] <= W_RUN;
                if ((next_wid < total_warps) && fill_valid)
                    next_wid <= ((total_warps - next_wid) < (32'd1 << blk_lg))
                              ? total_warps : next_wid + (32'd1 << blk_lg);

                // 1a) Barrier release: the whole group has arrived (or exited).
                for (int k = 0; k < NW; k++)
                    if (bar_release[k]) wstate[k] <= W_RUN;

                // 1b) Fetch step (F): capture the selected warp's instruction and
                //     TOS context into the X-stage registers; it executes NEXT
                //     cycle. The warp is marked in-flight so it is not re-fetched
                //     before X resolves it (and updates its PC/state). fetch_w can
                //     never equal the resolving issue_w below (an in-flight warp is
                //     skipped by the fetch select), so the inflight set/clear never
                //     collide. Round-robin advances at fetch.
                issue_valid <= fetch_valid;
                if (fetch_valid) begin
                    issue_w  <= fetch_w;
                    instr    <= imem_data;
                    cur_pc   <= fetch_pc;
                    cur_sp   <= fetch_sp;
                    cur_mask <= stk_mask[fetch_w][fetch_sp];
                    cur_rpc  <= stk_rpc[fetch_w][fetch_sp];
                    inflight[fetch_w] <= 1'b1;
                    rr_ptr   <= fetch_w + 1'b1;
                end

                // 2) Issue step (X): resolve the in-flight instruction — commit it,
                //    park its warp on an engine, or (engine busy / squashed
                //    writeback) do nothing so the warp re-enters the fetch pool and
                //    retries. Every outcome resolves in this one cycle.
                br_v <= 1'b0;
                if (issue_valid) begin
                    if (!do_ctl) inflight[issue_w] <= 1'b0;   // a jump/branch: at B
                    // M7 energy accounting: a committed datapath instruction clocks
                    // n_active lanes under gating vs all NL lanes ungated. A pop is
                    // bookkeeping (no datapath); a memory op or an fdiv/fsqrt that
                    // finds its engine busy re-attempts later (don't count the stall).
                    if (!do_pop && !sb_stall && !(is_mem && !me_in_ready) && !squash_wb &&
                        !(is_sfu_op && sfu_state != SFU_IDLE)) begin
                        dbg_issued_insns <= dbg_issued_insns + 32'd1;
                        dbg_active_lanes <= dbg_active_lanes +
                                            {{(31-LIDXW){1'b0}}, n_active};
                    end
                    if (do_pop) begin
                        // Pushed frame reached its join: reconverge into the frame
                        // below (which already holds the union mask at this PC).
                        sp[issue_w] <= cur_sp - 1'b1;
                    end else if (sb_stall) begin
                        // v3 B2: a register it uses is pending, its unit is full, or an
                        // ecall waits for results: nothing changes and the warp sleeps
                        // until a writeback can unblock it (step 3d), then retries.
                        sb_wait[issue_w]  <= !(sb_haz ? sb_own[issue_w] : sb_any);
                        sb_wfull[issue_w] <= !sb_haz;
                    end else if (is_ecall) begin
                        wstate[issue_w] <= W_DONE;
                        dbg_retire_a0   <= warp_base[issue_w];
                    end else if (do_fp) begin
                        // FP-compute: capture the operands + control into the FPU input
                        // registers this cycle (A1); the registered operands then feed the
                        // 5-stage FPU, so the result is valid FPC_LAT cycles after issue.
                        // The op's tag enters the result queue's delay line (u_fpc_q), rd
                        // is marked pending (step 3d) and the warp moves on.
                        stk_npc[issue_w][cur_sp] <= fallthru;
                        // A1: latch this op's operands + control into the FPU input
                        // registers, so stage-1 starts from a clean register boundary.
                        for (int l = 0; l < NL; l++) begin
                            q_frv1[l] <= frv1[l]; q_frv2[l] <= frv2[l];
                            q_frv3[l] <= frv3[l]; q_rv1[l]  <= rv1[l];
                        end
                        q_fp_funct5       <= fp_funct5;
                        q_fp_cvt_unsigned <= fp_cvt_unsigned;
                        q_fp_cvt_src_h    <= fp_cvt_src_h;
                        q_fp_rm           <= fp_rm;
                        q_fp_fmt          <= fp_fmt;
                        q_is_fma_op       <= is_fma_op;
                        q_fma_np          <= fma_np;
                        q_fma_nc          <= fma_nc;
                    end else if (do_mul) begin
                        // B1: RV32M `mul` — capture the operands into the multiply
                        // pipeline's input registers; rd is pending until the product is
                        // written (u_mul_q) and the warp moves on.
                        stk_npc[issue_w][cur_sp] <= fallthru;
                        for (int l = 0; l < NL; l++) begin
                            q_mul_a[l] <= rv1[l];
                            q_mul_b[l] <= rv2[l];
                        end
                    end else if (do_dot) begin
                        // AI: `pdot8` — capture the packed-INT8 operands into the dot
                        // engine's input registers; rd is pending until the result is
                        // written (u_dot_q) and the warp moves on.
                        q_dot_mode      <= dot_mode;   // signedness variant for the op
                        stk_npc[issue_w][cur_sp] <= fallthru;
                        for (int l = 0; l < NL; l++) begin
                            q_dot_a[l] <= rv1[l];
                            q_dot_b[l] <= rv2[l];
                        end
                    end else if (do_shf) begin
                        // v2: warp shuffle — capture every lane's rs1 and source index,
                        // rd is pending until the result is written (u_shf_q).
                        stk_npc[issue_w][cur_sp] <= fallthru;
                        for (int l = 0; l < NL; l++) begin
                            q_shf_val[l] <= rv1[l];
                            q_shf_src[l] <= shf_src[l];
                        end
                        q_shf_ok        <= shf_ok;
                    end else if (do_bar) begin
                        // v2: block barrier — advance past `bar` now and wait in W_BAR;
                        // the release step returns the warp to W_RUN.
                        stk_npc[issue_w][cur_sp] <= fallthru;
                        wstate[issue_w]          <= W_BAR;
                    end else if (is_sfu_op) begin
                        // Divide / square-root: capture every lane's f-operands now (they
                        // are live this cycle but move on with the scheduler), park the
                        // warp, and arm the shared serial SFU on its first active lane.
                        // The scheduler keeps issuing other warps. If the SFU is busy with
                        // another warp, this warp waits (stays W_RUN).
                        if (sfu_state == SFU_IDLE) begin
                            sfu_w         <= issue_w;
                            sfu_mask      <= cur_mask;
                            sfu_rd        <= rd;
                            sfu_resume_pc <= fallthru;
                            sfu_is_sqrt_r <= is_fsqrt;
                            sfu_fmt_r     <= fp_fmt;
                            for (int l = 0; l < NL; l++) begin
                                sfu_opa[l] <= frv1[l];
                                sfu_opb[l] <= frv2[l];
                            end
                            sfu_lane       <= sfu_first_lane;
                            sfu_core_start <= 1'b1;        // launch the first lane next cycle
                            wstate[issue_w] <= W_SFU;
                            sfu_state      <= SFU_RUN;
                        end
                        // else: SFU busy → warp waits.
                    end else if (is_mem) begin
                        // Hand the op to a free memory context (mem_engine captures
                        // its operands); if none is free the warp retries.
                        if (me_in_ready) begin
                            if (is_load) stk_npc[issue_w][cur_sp] <= fallthru;  // v3: goes on
                            else         wstate[issue_w] <= W_MEM;
                        end
                    end else if (!squash_wb) begin
                        // Compute commit. The register writeback is performed by the
                        // central VRF write arbiter below (a memory writeback this
                        // cycle would have set squash_wb and deferred us instead).
                        // Control flow / next-PC for the TOS frame.
                        // Control flow goes to stage B (below) with its outcome;
                        // every other op advances its PC now.
                        if (do_ctl) begin
                            br_v     <= 1'b1;
                            br_kind  <= (opcode == OP_BRANCH) ? BK_BR : BK_JUMP;
                            br_w     <= issue_w;
                            br_sp    <= cur_sp;
                            br_taken <= taken_mask;
                            br_mask  <= cur_mask;
                            br_tgt   <= (opcode == OP_BRANCH) ? br_target :
                                        (opcode == OP_JAL)    ? jal_target : jalr_target;
                            br_fall  <= fallthru;
                            br_fwd   <= !b_imm[31] && (b_imm != 32'd0);   // br_target > cur_pc
                        end else begin
                            stk_npc[issue_w][cur_sp] <= fallthru;
                        end
                    end
                end

                // 2b) Stage B: the SIMT stack update of last cycle's branch / jump. Its
                //     warp is still in flight, so no other step touches its stack.
                if (br_v) begin
                    inflight[br_w] <= 1'b0;
                    if (br_kind == BK_JUMP) begin
                        stk_npc[br_w][br_sp] <= br_tgt;
                    end else if (br_taken == br_mask) begin
                        stk_npc[br_w][br_sp] <= br_tgt;                   // uniform taken
                    end else if (br_taken == '0) begin
                        stk_npc[br_w][br_sp] <= br_fall;                  // uniform not-taken
                    end else begin
                        // Divergent: push a "continue" frame; the rest of the lanes
                        // wait, reconverging at RPC.
                        dbg_divergences <= dbg_divergences + 32'd1;
                        stk_mask[br_w][br_sp] <= br_mask;                 // union @ join
                        if (br_fwd) begin
                            // forward `if`: join = target; run the fall-through
                            // (not-taken) lanes first.
                            stk_npc [br_w][br_sp]        <= br_tgt;
                            stk_npc [br_w][br_sp + 1'b1] <= br_fall;
                            stk_mask[br_w][br_sp + 1'b1] <= br_mask & ~br_taken;
                            stk_rpc [br_w][br_sp + 1'b1] <= br_tgt;
                        end else begin
                            // backward loop: join = fall-through (exit); run the
                            // taken (still-looping) lanes.
                            stk_npc [br_w][br_sp]        <= br_fall;
                            stk_npc [br_w][br_sp + 1'b1] <= br_tgt;
                            stk_mask[br_w][br_sp + 1'b1] <= br_taken;
                            stk_rpc [br_w][br_sp + 1'b1] <= br_fall;
                        end
                        sp[br_w] <= br_sp + 1'b1;
                    end
                end

                // 3) Memory engine: a finished load clears its rd's pending bit (v3);
                //    a finished store or AMO resumes its parked warp.
                if (me_rs_valid) begin
                    if (me_rs_ld) begin
                        if (me_rs_fp) pend_f[me_rs_w][me_rs_rd] <= 1'b0;
                        else          pend_x[me_rs_w][me_rs_rd] <= 1'b0;
                    end else begin
                        stk_npc[me_rs_w][sp[me_rs_w]] <= me_rs_pc;
                        wstate[me_rs_w]               <= W_RUN;
                    end
                end
                if (me_gtxn) dbg_mem_txns     <= dbg_mem_txns + 32'd1;
                if (me_stxn) dbg_scratch_txns <= dbg_scratch_txns + 32'd1;

                // 3c) SFU (divide/sqrt) engine step. RUN: the single shared core works
                //     one active lane at a time; on each core `done` latch that lane's
                //     result and, if another active lane remains, advance and relaunch
                //     (the core is back in S_IDLE the cycle it pulses done, so the restart
                //     costs only a 1-cycle bubble); otherwise go to writeback. WB: drive
                //     the held results onto the f-file (the arbiter gives the memory
                //     engine priority, so this may wait a cycle), then resume the warp.
                unique case (sfu_state)
                    SFU_IDLE: ;   // armed in the issue step (captures operands, enters RUN)
                    SFU_RUN: begin
                        sfu_core_start <= 1'b0;            // 1-cycle launch pulse default-low
                        if (sfu_core_done) begin
                            sfu_hold[sfu_lane] <= sfu_core_res;
                            if (sfu_more) begin
                                sfu_lane       <= sfu_next_lane;
                                sfu_core_start <= 1'b1;   // launch the next active lane
                            end else begin
                                sfu_state <= SFU_WB;
                            end
                        end
                    end
                    SFU_WB:   if (sfu_wb_fire) begin
                        stk_npc[sfu_w][sp[sfu_w]] <= sfu_resume_pc;
                        wstate[sfu_w]             <= W_RUN;
                        sfu_state                 <= SFU_IDLE;
                    end
                    default: sfu_state <= SFU_IDLE;
                endcase

                // 3d) FPC, MUL, DOT and SHF writeback and scoreboard. Each unit's result
                //     queue (wp_resq) holds finished results in order; when the head's port
                //     is free (the *_wb_fire arbitration above) it is written and its
                //     register stops being pending. Several units may retire in one cycle,
                //     and never for the same register (a pending rd is not reissued). The
                //     op issued this cycle marks its rd pending.
                if (fpc_wb_fire) begin
                    if (fpc_isfp) pend_f[fpc_w][fpc_rd] <= 1'b0;
                    else          pend_x[fpc_w][fpc_rd] <= 1'b0;
                end
                if (mul_wb_fire) pend_x[mul_w][mul_rd] <= 1'b0;
                if (dot_wb_fire) pend_x[dot_w][dot_rd] <= 1'b0;
                if (shf_wb_fire) pend_x[shf_w][shf_rd] <= 1'b0;
                if (do_fp && wb_is_fp)
                    pend_f[issue_w][rd] <= 1'b1;
                if (((do_fp && !wb_is_fp) || do_mul || do_dot || do_shf) && (rd != 5'd0))
                    pend_x[issue_w][rd] <= 1'b1;
                if (ld_inc && is_load_fp)                      pend_f[issue_w][rd] <= 1'b1;
                if (ld_inc && !is_load_fp && (rd != 5'd0))     pend_x[issue_w][rd] <= 1'b1;
                for (int k = 0; k < NW; k++)
                    ld_out[k] <= ld_out[k] + 4'(ld_inc && (issue_w == WIDXW'(k)))
                                           - 4'(me_rs_valid && me_rs_ld && (me_rs_w == WIDXW'(k)));
                // Wake sleepers (only warps already asleep: the warp stalling this
                // cycle was decided in the issue step).
                for (int k = 0; k < NW; k++) if (sb_wait[k] && sb_wake[k]) sb_wait[k] <= 1'b0;

                // 3b) Mark written registers valid. The VRF data write itself happens
                //     in the per-lane distributed-RAM banks (see the generate block);
                //     here we only record that the register is no longer at its seed.
                //     Kept as two single-statement loops (see BLKLOOPINIT note above).
                for (int l = 0; l < NL; l++)
                    if (v_we[l])  reg_written [v_ww[l]][l][v_wr[l]] <= 1'b1;
                for (int l = 0; l < NL; l++)
                    if (fv_we[l]) freg_written[fv_ww[l]][l][fv_wr[l]] <= 1'b1;

                // 4) Completion: nothing left to spawn and no slot running.
                if (!any_busy) begin
                    running <= 1'b0;
                    busy    <= 1'b0;
                    done    <= 1'b1;
                end
            end
        end
    end

    // ── Debug window: warp state (up to 8 warps), then the memory engine ─────────
    //   0: state per warp (nibbles: 0 empty, 1 run, 2 mem, 3 sfu, 4 done, 5 bar)
    //   1: asleep | asleep-on-full-unit << 8 | in X << 16 | fetch, issue valid << 24 |
    //      issue warp << 28      2: loads in flight per warp (nibbles)
    //   3: integer regs pending | FP regs pending << 8 | SFU state << 16
    //   4-11: pending integer registers per warp   12-19: base thread id per warp
    //   20-27: next PC per warp       28-43: memory engine (mem_engine.sv)
    always_comb begin
        for (int i = 0; i < 28; i++) dbg_state[i] = '0;
        for (int k = 0; k < NW && k < 8; k++) begin
            dbg_state[0][k*4 +: 4] = 4'(wstate[k]);
            dbg_state[1][k]        = sb_wait[k];
            dbg_state[1][8 + k]    = sb_wfull[k];
            dbg_state[1][16 + k]   = inflight[k];
            dbg_state[2][k*4 +: 4] = ld_out[k];
            dbg_state[3][k]        = (pend_x[k] != '0);
            dbg_state[3][8 + k]    = (pend_f[k] != '0);
            dbg_state[4 + k]       = pend_x[k];
            dbg_state[12 + k]      = warp_base[k];
            dbg_state[20 + k]      = stk_npc[k][sp[k]];
        end
        dbg_state[1][24]       = fetch_valid;
        dbg_state[1][25]       = issue_valid;
        dbg_state[1][28 +: 4]  = 4'(issue_w);
        dbg_state[3][16 +: 4]  = 4'(sfu_state);
        for (int i = 0; i < DBG_ME; i++) dbg_state[28 + i] = me_dbg[i];
    end

endmodule : warp_pool

// =============================================================================
// wp_resq  -  result queue for one fixed-latency multi-cycle unit (v3 B2)
//
// The FP-compute, integer-multiply, INT8-dot and shuffle units of warp_pool are
// fixed-latency pipelines that accept a new warp instruction every cycle. For each
// unit this module carries the issuing op's tag down a delay line in step with the
// unit, pushes tag + per-lane results into a queue when the result appears (LAT
// cycles after `push`), and presents the queue head for writeback. `rdy` is low
// while DEPTH ops are in the pipe and the queue together; the issue stage then holds
// the op back, so the DEPTH-entry queue never overflows.
// =============================================================================
/* verilator lint_off DECLFILENAME */
module wp_resq #(
    parameter int LAT = 6,              // push -> `res` valid, in cycles (>= 1)
    parameter int NL  = 8,              // lanes
    parameter int DEPTH = 8,            // queue entries = most ops in flight
    parameter int TW  = 8               // tag width
) (
    input  logic                 clk,
    input  logic                 clr,       // synchronous clear (reset, kernel launch)
    input  logic                 push,      // an op entered the unit this cycle
    input  logic [TW-1:0]        tag,
    input  logic [NL-1:0][31:0]  res,       // unit output, for the op pushed LAT cycles ago
    input  logic                 pop,       // the head was written back this cycle
    output logic                 rdy,       // room for another op (push allowed)
    output logic                 vld,       // queue not empty
    output logic [TW-1:0]        hd_tag,
    output logic [NL-1:0][31:0]  hd_data
);
    localparam int PW = (DEPTH > 1) ? $clog2(DEPTH) : 1;

    // Delay line: dv[LAT-1] / dtag[LAT-1] belong to the op whose result is on `res`.
    logic [LAT-1:0]   dv;
    logic [TW-1:0]    dtag [0:LAT-1];
    if (LAT == 1) begin : g_lat1
        always_ff @(posedge clk) dv <= clr ? 1'b0 : push;
    end else begin : g_latn
        always_ff @(posedge clk) dv <= clr ? '0 : {dv[LAT-2:0], push};
    end
    always_ff @(posedge clk) begin
        dtag[0] <= tag;
        for (int i = 1; i < LAT; i++) dtag[i] <= dtag[i-1];
    end

    // Queue: storage without reset (distributed RAM), pointers and count with it.
    logic [TW-1:0]        qtag  [0:DEPTH-1];
    logic [NL-1:0][31:0]  qdata [0:DEPTH-1];
    logic [PW-1:0]        hd, tl;
    logic [PW:0]          n;                // results waiting in the queue
    logic [PW:0]          cnt;              // ops in the pipe + the queue
    function automatic logic [PW-1:0] inc(input logic [PW-1:0] p);
        return (p == PW'(DEPTH - 1)) ? '0 : p + 1'b1;
    endfunction
    always_ff @(posedge clk)
        if (dv[LAT-1]) begin
            qtag[tl]  <= dtag[LAT-1];
            qdata[tl] <= res;
        end
    always_ff @(posedge clk) begin
        if (clr) begin
            hd  <= '0;
            tl  <= '0;
            n   <= '0;
            cnt <= '0;
        end else begin
            if (dv[LAT-1]) tl <= inc(tl);
            if (pop)       hd <= inc(hd);
            n   <= n   + (PW+1)'(dv[LAT-1]) - (PW+1)'(pop);
            cnt <= cnt + (PW+1)'(push)      - (PW+1)'(pop);
        end
    end
    assign rdy     = (cnt < (PW+1)'(DEPTH));
    assign vld     = (n != '0);
    assign hd_tag  = qtag[hd];
    assign hd_data = qdata[hd];
endmodule
/* verilator lint_on DECLFILENAME */
