Krishna-Gorai/simtix/baselines/ara/rtl/ara_ps_wrap.v

// ara_ps_wrap.v - Verilog-2001 wrapper of ara_ps_top for a Vivado block design (a
// module reference must have a Verilog top). 2 lanes, VLEN 2048, FP64/32/16.
//
//   s_axi : AXI4-Lite slave (A53 host registers, see ara_ps_top.sv)
//   m_axi : AXI4 master, 64-bit data, 5-bit ID, to DDR4 through S_AXI_HP0_FPD
//
// No parameters: the widths are fixed here, so the block design cannot evaluate
// them differently from synthesis (cf. the SIMTiX IDW lesson).
`timescale 1ns/1ps
module ara_ps_wrap (
    (* X_INTERFACE_INFO = "xilinx.com:signal:clock:1.0 clk CLK" *)
    (* X_INTERFACE_PARAMETER = "ASSOCIATED_BUSIF s_axi:m_axi, ASSOCIATED_RESET aresetn" *)
    input  wire         clk,
    (* X_INTERFACE_INFO = "xilinx.com:signal:reset:1.0 aresetn RST" *)
    (* X_INTERFACE_PARAMETER = "POLARITY ACTIVE_LOW" *)
    input  wire         aresetn,

    input  wire [15:0]  s_axi_awaddr,
    input  wire [2:0]   s_axi_awprot,
    input  wire         s_axi_awvalid,
    output wire         s_axi_awready,
    input  wire [31:0]  s_axi_wdata,
    input  wire [3:0]   s_axi_wstrb,
    input  wire         s_axi_wvalid,
    output wire         s_axi_wready,
    output wire [1:0]   s_axi_bresp,
    output wire         s_axi_bvalid,
    input  wire         s_axi_bready,
    input  wire [15:0]  s_axi_araddr,
    input  wire [2:0]   s_axi_arprot,
    input  wire         s_axi_arvalid,
    output wire         s_axi_arready,
    output wire [31:0]  s_axi_rdata,
    output wire [1:0]   s_axi_rresp,
    output wire         s_axi_rvalid,
    input  wire         s_axi_rready,
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
