Krishna-Gorai/simtix/(commit log)

2026-06-02 M0: scaffold SIMTiX — GPU-inspired SIMT accelerator for RISC-V
    Repo skeleton, docs (architecture/ISA/roadmap), Apache-2.0, GitHub CI.
    Reuses the existing 5-stage RISC-V core as the host. Accelerator MMIO
    command/status registers + launch/done handshake (stub engine) pass a
    self-checking Verilator regression; CPU + accel RTL lint clean.
2026-06-02 M1.1: single SIMT lane (single-cycle RV32I integer core)
    Adds rtl/accel/lane.sv: fetch/decode/execute for the RV32I integer
    subset (LUI/AUIPC/OP/OP-IMM/branches/JAL/JALR/csrr tid/ecall), seeded
    by the a0=tid,a1..a3=base,a4=n convention and retiring on ecall.
    ISA decode constants added to simtix_pkg. Unit test tb_lane runs a
    kernel (a0=3*tid+7) across 5 thread ids; lint clean, regression green.
    Loads/stores + accelerator integration follow in M1.2.
2026-06-03 M1.2: integrate lane into accelerator + RV32I LSU, vector-add end-to-end
    - lane.sv: add full RV32I load/store unit (lb/lh/lw/lbu/lhu, sb/sh/sw) with
    byte-enable generation and sign/zero extension; data-memory master port.
    - simt_accel.sv: replace the M0 stub engine with a real datapath -- one lane
    driven by a sequential dispatcher that launches threads 0..N-1, seeds each
    thread, and tallies CYCLES. Accelerator is now a master onto shared memory
    (instruction-fetch + data ports).
    - tb_simt_accel.sv: end-to-end integration test -- preload vadd kernel + arrays
    A,B into shared memory, launch via MMIO, verify C[tid] = A[tid] + B[tid].
    - tb_lane.sv: add byte (sb/lb/lbu) and halfword (sh/l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
    [lane.sv, simt_accel.sv, tb_lane.sv, tb_simt_accel.sv]
2026-06-03 M1.3: SoC integration -- host CPU launches the accelerator over MMIO
    - soc_top.sv: new system top wiring the reused 5-stage RISC-V pipeline to the
    accelerator on the CPU data bus. Address decode splits accesses: >= MMIO_BASE
    (0x8000_0000) -> accelerator command/status regs, else -> CPU local data RAM.
    A normal RISC-V program launches a kernel purely via loads/stores to the MMIO
    aperture (no custom instructions). Host I-fetch and the accelerator's
    shared-memory master ports are exposed at the boundary.
    - tb_soc_top.sv: full-system regression. The host CPU runs a hand-assembled
    RV32I driver (program command block, set GO, poll STATUS.DONE, halt); the
    vadd kernel + arrays A,B live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
2026-06-03 M2: 8-lane SIMT warp with a banked vector register file
    - warp.sv: new lockstep warp -- ONE shared PC / instruction fetch drives
    NUM_LANES (8) per-lane datapaths over a banked VRF (vrf[lane][reg]). Lanes
    execute the same instruction every cycle; each computes from its own registers
    and tid. Convergent control flow assumed for M2 (shared next-PC follows lane 0;
    per-thread divergence is M5). A static tail mask handles a partial final warp
    (tid >= N). Per-lane loads/stores are serialized onto the single data port
    (one lane/cycle) -- coalescing them is the M4 contribution, so the external
    memory interface is unchanged from the M1 single-lane core.
    - simt_accel.sv: dispatcher now la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
    [simt_accel.sv, tb_simt_accel.sv, tb_warp.sv, warp.sv]
2026-06-03 M3: multi-warp pool with a round-robin scheduler (latency hiding)
    Grow the single M2 warp into a resident pool of NUM_WARPS warp slots that
    share one fetch/decode/ALU datapath and one data port. A round-robin
    scheduler issues one warp per cycle; a background memory engine replays an
    in-flight load/store one lane per cycle. Because the replay runs in the
    background, the scheduler keeps issuing other warps compute on the otherwise
    idle datapath, so one warps serialized memory cost is overlapped with
    another warps useful work.
    - rtl/accel/warp_pool.sv: NUM_WARPS contexts (per-warp PC, banked VRF, tail
    mask), round-robin issue, background single-port memory replay, slot
    spawning/recycling f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
    [simt_accel.sv, tb_warp_pool.sv, warp_pool.sv]
2026-06-03 M4: memory coalescing on a line-wide data port
    Turn the per-lane memory replay into a coalescing engine. The data port now
    carries a whole cache line (LINE_WORDS words); each cycle the memory engine
    takes the line of the lowest still-pending active lane and services every
    pending lane sharing that line in ONE line transaction. A contiguous warp
    access (A[tid]) collapses from NUM_LANES transactions to 1; a scattered
    access still costs one transaction per distinct line.
    - simtix_pkg.sv: LINE_WORDS/LINE_BITS/LINE_BE/LINE_OFF coalescing-line params.
    - warp_pool.sv: line-wide dmem port; leader/group line selection; merged
    per-lane load extraction and store byte-enable build; dbg_mem_txns count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
    [simt_accel.sv, simtix_pkg.sv, soc_top.sv, tb_simt_accel.sv, tb_soc_top.sv, tb_warp_pool.sv, warp_pool.sv]
2026-06-03 M5: control divergence via a per-warp SIMT reconvergence stack
    Each warp slot now owns a small SIMT stack instead of a single PC. The
    top-of-stack frame defines the warp PC and the active lane mask; a branch
    is resolved per lane:
    - uniform (all active lanes agree): retarget the TOS PC, no divergence.
    - divergent: push a "continue" frame so the two lane groups run in turn
    and reconverge at a join PC (RPC) stored in the frame. The reconv frame
    holds the union mask at RPC; the pushed frame pops when its PC reaches
    RPC, restoring the full warp.
    Convention (compiler-free): single-sided if (forward branch -> RPC=target,
    run the fall-through lanes) and divergent loops (backward br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
    [simt_accel.sv, tb_warp_pool.sv, warp_pool.sv]
2026-06-03 M6: shared-memory scratchpad + matmul reuse benchmark
    Add a per-warp on-chip scratchpad and an RV32M multiply so a kernel can
    stage reused operands on-chip and cut global memory traffic.
    - simtix_pkg: SCRATCH_BASE (0x4000_0000 aperture, bits[31:30]==01),
    SCRATCH_WORDS/SCRATCH_AW, and ALU_MUL for RV32M `mul`.
    - warp_pool: per-warp scratch SRAM serviced in one cycle for the whole
    warp (never touches the global data port); decode/execute `mul`; new
    dbg_scratch_txns counter separate from dbg_mem_txns.
    - simt_accel: propagate dbg_scratch_txns (observability only).
    - kernels/matmul: 8x8 matmul-row, naive (A_row reloaded from global each
    k) vs smem (A_row staged once in scratch, reused). H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
    [simt_accel.sv, simtix_pkg.sv, tb_warp_pool.sv, warp_pool.sv]
2026-06-03 M7a: divergence-aware lane clock-gating energy study
    The micro-architectural research contribution: reuse the SIMT active mask as a
    per-lane clock-enable and quantify the dynamic energy a gated design saves as
    branch divergence masks off lanes.
    - warp_pool: lane_ce = cur_mask is the per-lane ICG enable (synthesis maps each
    bit to an integrated clock gate). Two counters account the opportunity:
    dbg_issued_insns (committed datapath instructions; pops and port-stalls
    excluded) and dbg_active_lanes (Σ popcount(active mask)). An ungated design
    clocks NUM_LANES every instruction; a gated one clocks only active lanes, so
    1 - active/(NL*insns) is the lane-datapath dynamic energy saved.
    -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
    [simt_accel.sv, tb_warp_pool.sv, warp_pool.sv]
2026-06-04 M7b: OOC Vivado synthesis + PPA of simt_accel on ZCU104
    Out-of-context synth on xczu7ev-ffvc1156-2-e (Vivado 2025.1, 200 MHz target):
    - 170,868 LUT (74.2%), 44,112 FF (9.6%), 24 DSP48E2, 0 BRAM/URAM
    - Fmax ~122 MHz (setup WNS -3.213 ns @ 5.0 ns); 1.673 W on-chip (vectorless)
    - warp_pool dominates: the 32,768-reg variable-indexed VRF synthesises to a
    128:1-per-lane mux fabric -> ~74% device LUTs at ~10% FF; banking the VRF to
    RAM is the obvious next optimisation.
    Flow tuned for the 8 GB host: -flatten_hierarchy none -no_timing_driven plus
    maxThreads 2 completes in ~27 min (a timing-driven run thrashed 4 h at a
    4.25 GB peak and produced nothing). Raw reports under fpga/reports/. Closes M7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
2026-06-04 M8: move vector register file into distributed RAM (LUTRAM) + close timing
    The flip-flop VRF (NUM_WARPS*NUM_LANES*32 = 32,768 FFs, variable-indexed) was the
    LUT hog and critical path in M7b (74% LUTs, WNS -3.213 ns @ 200 MHz). Bank it into
    per-lane distributed RAM and relax the clock to a frequency the single-cycle
    datapath can actually meet.
    RTL (warp_pool.sv), behaviour bit-identical (full sim suite green):
    - per-lane 1D (* ram_style="distributed" *) banks in a generate block (a 2D array
    written in a for-loop is misread as 3D-RAM and dissolves to registers).
    - valid bits (reg_written) replace the 1-cycle 32-register spawn clear; an unwritten
    register reads its spawn seed (a0=tid, a1..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
    [warp_pool.sv]
2026-06-05 M9: move scratchpad into distributed RAM (LUTRAM) + timing-driven synth
    Flatten the per-warp scratchpad into one single-port (* ram_style=distributed *) RAM (256x32, addr {warp,sidx}); the memory engine now serializes one lane per cycle (lowest pending 'lead' lane), mirroring the global coalescing drain. Shared-memory semantics are preserved exactly: within one SIMT memory instruction all lanes do the same op, so there is no intra-instruction lane-to-lane forwarding to lose, and store/store collisions still resolve last-writer-wins. Cost: a scratch op touching k lanes now takes k cycles instead of 1.
    Re-enable timing-driven optimization in fpga/synth_ooc.tcl: with both VRF (M8) and scratchp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
    [warp_pool.sv]
2026-06-05 M10: complete chip integration (host CPU + accelerator + shared memory)
    Turn the system into a self-contained SoC. New rtl/soc/ modules: shared_mem.sv (4 KB on-chip shared memory split into 8 distributed-RAM banks, one per word-lane, so an accelerator line access reads one word per bank in parallel; serves the accel line/imem ports + the CPU word port; preloaded via synthesizable initial; synthesizes to 0 flip-flops), cpu_driver_rom.sv (29 hand-assembled RV32I instructions: program the command block, launch, poll DONE, read C back, sum, publish), and chip_top.sv (RISC-V pipeline + driver ROM + simt_accel + shared_mem with the 0x9=result / 0x8=MMIO / else=shared address decode and the result/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
    [chip_top.sv, cpu_driver_rom.sv, shared_mem.sv, tb_chip_top.sv]
2026-06-05 M11: full implementation + bitstream (place & route -> chip_top.bit)
    Take the complete chip (chip_top) through the real device flow on the ZCU104's
    xczu7ev: in-context synth -> opt -> place -> phys_opt -> route -> write_bitstream.
    - fpga/impl_chip.tcl: full P&R flow + post-route sign-off reports + bitstream
    - fpga/constr/chip_top_impl.xdc: 100 MHz clock, CFGBVS/CONFIG_VOLTAGE, auto-placed
    I/O with NSTD-1/UCIO-1 downgraded (ZCU104 board files not installed locally)
    - Post-route: all timing constraints MET @ 100 MHz (setup WNS +0.000, hold +0.005,
    0 of 37,516 failing; 0 errors/0 critical warnings), 34.9k LUT / 6.1k FF / 24 DSP /
    0 BRAM, 1.09 W; 19 MB chip_top.bit (git-ignored build arti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
2026-06-05 M12: CPU-side input loading (host populates the working set at runtime)
    The host CPU now writes the A/B operand arrays into shared memory itself before
    launching the accelerator, instead of relying on the memory's initial preload.
    - cpu_driver_rom.sv: prepend a 14-instruction RV32I store loop writing
    A[i]=10+i @0x300 and B[i]=100+2i @0x340 (i=0..7); program/launch/poll/readback
    shifted down accordingly (relative branches unchanged)
    - shared_mem.sv: drop the A/B preload from init_word() (A/B power up as 0); keep
    only the kernel code and the C poison, so a passing test now PROVES the CPU
    populated the inputs
    - result=964 unchanged; chip cycle count ~114 -> ~198 (the host's input loop)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
2026-06-05 M13: post-implementation functional sim of the routed chip (xsim)
    Simulate the real placed-and-routed gate-level netlist (UNISIM LUT6/FDRE/RAMD64E/
    DSP48E2 + glbl GSR) with the same self-checking testbench to sign off that synth +
    P&R preserved behaviour on the implemented hardware.
    - impl_chip.tcl: after route_design, emit postimpl/chip_top_funcsim.v (gate netlist)
    + chip_top_funcsim.sdf (routed delays) [both git-ignored, regenerable]
    - run_postimpl_sim.bat: xsim flow (xvlog netlist+tb+glbl, xelab -L unisims_ver
    -L secureip, xsim -runall)
    - Result: gate-level chip computes result=964 (~204 cyc), identical to RTL
    - reports_impl refreshed for the M12 RTL: this P&R run closed hold (WHS +0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
2026-06-05 fpga: add create_project.tcl to generate a Vivado GUI project for the chip
    Builds a managed .xpr (chip_top hierarchy + chip_top_impl.xdc + tb_chip_top sim)
    so the design can be opened and driven from the Vivado GUI Flow Navigator. Single
    paths wrapped in [list ...] to survive the space in the 'Verilog Projects' path.
    Generated project lives under fpga/vivado_project/ (git-ignored).
2026-06-17 eval: add benchmark suite, measured CPU baseline, and figures
    Add a six-kernel benchmark suite for publication-grade evaluation of the
    SIMT accelerator, spanning distinct microarchitectural axes:
    vadd/saxpy streaming, perfect coalescing (saxpy uses mul)
    fir 3-tap stencil, partial coalescing
    relu data-dependent light divergence
    collatz data-dependent heavy divergence (capped step count)
    reduce scratchpad inter-lane comm + lane-0 reduction
    New:
    kernels/{vadd,saxpy,fir,relu,collatz,reduce}/*.S accelerator kernels (rv32im)
    kernels/scalar/s_*.S scalar host baselines (rv32i)
    kernels/build_kernels.sh as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
    [bench.csv, bench_cpu.csv]
2026-06-17 dse: parameterize lanes/warps and add throughput design-space sweep
    Make NUM_LANES and NUM_WARPS overridable at elaboration
    (+define+SIMTIX_NUM_LANES / SIMTIX_NUM_WARPS; WARP_SIZE tracks NUM_LANES).
    Absent any define the package reproduces the committed 8-lane/4-warp config
    byte-for-byte, so existing tests and the FPGA flow are unaffected.
    tests/tb_dse.sv + `make dse LANES=.. WARPS=..` - runs the five
    lane-count-agnostic kernels (vadd/saxpy/fir/relu/collatz) with a fully
    line-size-parametric memory model; verifies bit-exact; emits DSE CSV rows.
    docs/plot_dse.py + docs/dse_perf.csv + docs/figs/dse_*.png
    Swept NUM_LANES in {4,8,16,32} x NUM_WARPS in {2,4,8} (12 configs, all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
    [dse_perf.csv]
2026-06-18 M14.0: floating-point register file + flw/fsw data path
    First step of RV32F/Zfh support on the SIMT engine. Adds a separate,
    NaN-box-ready FP register file and the FP load/store data path; FP
    arithmetic is decoded but inert until M14.1 (per-lane FPU).
    simtix_pkg.sv:
    - FP ISA constants: FLEN/NUM_FREGS, OP-FP/flw/fsw/FMA opcodes,
    OP-FP funct5 operation set, FMT_S/FMT_H format codes.
    warp_pool.sv:
    - Separate per-lane FP register file (distributed RAM, {warp,freg}
    addressed, 3 async read ports for a future FMA + 1 sync write),
    mirroring the integer VRF. f0 is a real register; an unwritten
    f-register reads 0 (freg_written valid bits, no spawn seed).
    - Full FP instruction d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
    [simtix_pkg.sv, tb_fp.sv, warp_pool.sv]
2026-06-18 M14.0 fix: split reg/freg_written clears for Verilator 5.020 (CI)
    CI runs Verilator 5.020, which rejects BLKLOOPINIT — a delayed (<=)
    assignment to an array inside a for loop is only accepted when it is
    the lone statement in the loop body (its array-init optimization pass
    cannot handle a multi-statement begin/end body). My M14.0 reset and
    spawn clears combined reg_written and freg_written into one begin/end
    loop body, which broke that pattern (local Verilator 5.030 accepts it,
    so it passed here but failed CI).
    Restore the single-statement form that was green before by clearing
    reg_written and freg_written in separate loops (reset, spawn, and the
    mark-written step). No functional change; f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
    [warp_pool.sv]
2026-06-18 M14.1: per-lane FP32 FPU + integration into warp_pool
    Add a compact single-cycle IEEE-754 single-precision unit (simt_fpu.sv), one
    per lane, executing the OP-FP datapath: add/sub/mul (RNE, FTZ subnormals),
    sign-inject, min/max (IEEE minNum/maxNum), compares (feq/flt/fle), int<->float
    convert (saturating RTZ / RNE), and bit moves (fmv.x.w / fmv.w.x) + fclass.
    Wire it into warp_pool: FP-dest results commit to the separate f-file, FP->int
    results (compares/convert/fmv.x.w) to the integer VRF. The two write ports
    arbitrate independently; a compute writeback is squashed only when it contends
    for the same port as a memory writeback (wb_is_fp == mem_is_fp). Operand reads
    are split from the fpu_res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
    [fpu_ref.c, simt_fpu.sv, tb_fparith.sv, tb_fpu.sv, warp_pool.sv]
2026-06-18 paper: add floating-point (FP32+FP16) contribution with results
    Fold the M14.1/M14.2 floating-point extension into the living manuscript:
    - New section on the FP extension: per-lane single-cycle FP unit + a second
    NaN-boxed f-register file in LUTRAM; FP16 via widen-compute-narrow with the
    Figueroa double-rounding argument for correct single-rounding; verification
    (76,048 bit-exact checks vs an IEEE reference) and an operation coverage
    table; FP throughput results.
    - Two new figures from a new FP benchmark (tb_fpbench + make fp-bench): FP32 and
    FP16 streaming add and multiply-add throughput vs N (fp_throughput.png) and
    the FP16-equals-FP32 cycle-cost comparison (fp_cost.png), plu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
    [fp_bench.csv]
2026-06-22 M14.1b: fused multiply-add (single-cycle, single-rounded)
    Add fmadd/fmsub/fnmsub/fnmadd to the per-lane FPU, computing +/-(a*b) +/- c
    with a SINGLE rounding. The 48-bit product is exact and anchored in a 128-bit
    accumulator at bits [75:28]; the addend is shifted to its true relative position
    (sticky-capturing any bits driven below bit 0), then one normalize + round.
    Key cases handled:
    - Effective subtraction borrows one LSB when the aligned-out addend has a
    non-zero sticky (true = (big-small) - frac, frac in (0,1)) and forces sticky.
    - Addend-dominant (pos0 >= 77, i.e. the product MSB sits below half a ULP of the
    addend): result is the sign-adjusted addend exactly, which also bounds the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
2026-06-22 M14.3: multi-cycle divide / square-root SFU + stall scoreboard
    Add genuinely iterative FP32 (+ FP16) divide and square-root, the first
    multi-cycle operations in the engine, behind a stall scoreboard that parks the
    issuing warp while the scheduler keeps issuing OTHER warps — the same
    latency-hiding structure as the background memory engine.
    rtl/accel/fp_divsqrt.sv: a digit-recurrence core. Divide does one integer-bit
    compare (siga>=sigb) then 26 restoring fractional iterations (remainder < sigb
    held), giving {Qint, 26 frac bits} + a remainder sticky. Square-root does a
    restoring integer sqrt of the radicand shifted up by 48, two radicand bits per
    cycle, 37 root bits + remainder. RNE, FTZ;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
    [fp_divsqrt.sv, fpu_ref.c, tb_divsqrt.sv, tb_fpdivsqrt.sv, warp_pool.sv]
2026-06-22 M14.4: realistic FP application kernels + golden verification
    Toolchain-assembled (rv32imf / rv32imf_zfh) floating-point kernels that exercise
    the full M14 FP datapath end-to-end through warp_pool, each checked bit-exact
    against a DPI reference at N=8/64/256:
    fsaxpy C = 3*A + B FP32, one fused multiply-add per element
    fsaxpy16 C = 3*A + B FP16 (fmadd.h), NaN-boxed operands
    fnorm C = A / sqrt(B) FP32, both multi-cycle SFU ops per element
    fdot C[w] = sum A*B FP32, fmul + scratchpad cross-lane reduction
    New harness tests/tb_fpkernels.sv (make test-fpkernels, in the regression) loads
    the kernels, golden-checks every output, and prints FPKCSV me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
    [fp_kernels.csv]
2026-06-22 M15: 2-stage pipelined FPU + W_FPC scoreboard (61 -> 88 MHz)
    Pipeline the FP-compute datapath to cut the longest path in the design.
    simt_fpu is now a 2-STAGE pipeline: the add/sub and fused-multiply-add datapaths
    are split at their significand `mag` boundary -- stage 1 unpacks and forms the
    aligned magnitude (and the full result of every shallow op: mul/sgnj/min-max/
    compare/convert/move/classify), stage 2 does the leading-zero normalize + round +
    format mux. The arithmetic is identical (tb_fpu still passes all 96,066 bit-exact
    checks); only the register boundary is new, roughly halving the FP critical path.
    warp_pool consumes the 1-cycle-late result via a single-slot scoreboard (W_FPC)
    t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
    [fp_kernels.csv]
2026-06-23 M15: fold pipelined-FPU timing result into paper (placed 78 MHz, route-bound)
    Place-and-route sign-off of the 2-stage FPU (commit 19ad49f) on xczu7ev:
    closes at 12.8 ns / 78 MHz, not 100 MHz. The placed critical path is the
    first FMA stage and is now routing-dominated (7.4 of 12.8 ns, 58% wire),
    because the FP-enlarged fabric (2.5x integer LUTs, 8 wide FP lanes) makes
    interconnect the binding constraint, not logic depth (logic alone 5.3 ns).
    Paper (docs/paper/simtix.tex):
    - sec:fppa: replace the "pipelining left as future work / 16.2 ns" text
    with a Timing-closure paragraph: 2-stage split at the FMA mag boundary,
    W_FPC single-slot park, FF 7.9k->12.4k, synth 61->88 MHz, placed 78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
    [fp_bench.csv]
2026-06-23 M16: fold 8 per-lane div/sqrt cores into one shared serial SFU
    M14.3 instantiated a full fp_divsqrt in every lane (8 cores ~= 5.5k LUT)
    running in lockstep. M15 place-and-route showed the FP datapath is
    interconnect-bound (placed 78 MHz, critical path 58% wire), so logic-depth
    pipelining is the wrong lever; reducing FP area/congestion is the right one.
    This folds the eight cores into ONE shared core fed lane-by-lane:
    - At fdiv/fsqrt issue, capture every lane's f-operands into sfu_opa/opb[]
    (the live frv* reads track the issuing warp and move on to other warps
    while the SFU iterates for tens of cycles), plus the op type and format.
    - A lane sequencer (priority encoders sfu_first_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
    [warp_pool.sv]
2026-06-23 M16: fold shared-serial-SFU PPA result into paper (78 -> 84 MHz)
    Place-and-route of the shared serial divide/sqrt SFU (commit e786aee) on
    xczu7ev confirms the M15 interconnect-bound diagnosis by acting on it:
    metric M15 (8 cores) M16 (1 shared)
    placed Fmax 78.0 MHz 84.1 MHz (WNS -2.816 -> -1.890 ns)
    LUT 72,573 68,914 (-3,659)
    FF 12,347 11,153 (-1,194)
    power 1.525 W 1.219 W
    near-crit EP 8,664 3,166
    The FMA critical path is structurally unchanged (same g_fpu[*]/r_fma_mag
    cone, logic ~5.3 ns) but its ROUTING delay drops 7.36 -> 6.52 ns purely from
    de-congesting the fabric -- same logic, l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
2026-06-23 FP DSE: lane count is not the frequency lever (per-lane FMA is the floor)
    Placed PPA of the FP-enabled accel vs lane count (xczu7ev, 4 warps):
    lanes LUT DSP power placed Fmax throughput
    4 36,785 20 0.98 W 79.7 MHz 3.06 w/cyc
    8 68,914 40 1.22 W 84.1 MHz 5.85 w/cyc
    Halving the FP fabric halves the area but does NOT raise the placed
    frequency -- 4 lanes (79.7 MHz) is marginally BELOW 8 lanes (84.1), and the
    router still flags CLB congestion at 4 lanes. The critical path is a single
    lane's FMA cone (logic depth + locally-dense 128-bit datapath), independent
    of lane count; fewer lanes just replicate it fewer times, and the smaller
    design packs denser, gi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
    [dse_fp.csv]
2026-06-23 M17: 3-stage FMA pipeline (split product / align / normalize)
    The FP DSE showed the binding constraint is a single lane's FMA cone -- an
    intra-lane floor independent of lane count -- so the lever for 100 MHz is the
    FMA microarchitecture, not the fabric size. This splits the FMA across THREE
    pipeline stages (the M15 2-stage put product + 128-bit align + add all in
    stage 1, the heavy half):
    stage 1: 48-bit significand product + alignment amount (pos0) + specials
    stage 2: 128-bit align (barrel shift) + add -> magnitude
    stage 3: leading-zero normalize + round + format mux
    ADD/SUB and the shallow ops compute fully in stage 1 and ride a second
    register (reg2) to the stage-3 mux, so every o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
    [simt_fpu.sv, tb_fpu.sv, warp_pool.sv]
2026-06-23 M17: fold 100 MHz closure into paper (3-stage FMA meets timing)
    Place-and-route of the 3-stage FMA (commit 283e2f0) on xczu7ev MEETS 100 MHz:
    step FP datapath Fmax WNS FF crit path
    M15 2-stage FMA 78.0 MHz -2.816 ns 12.3k FMA cone
    M16 + shared SFU 84.1 MHz -1.890 ns 11.2k FMA cone
    M17 (this) 3-stage FMA 100.7 MHz +0.071 ns 15.0k VRF LUTRAM
    Splitting the FMA across three stages (product / 128-bit align+add / normalize+
    round) drops it out of the critical path entirely: the placed worst slack is
    +0.071 ns at 100 MHz and the binding path is now the vector-register-file LUTRAM
    read mux -- the SAM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
2026-06-23 paper: consolidate FP timing-closure PPA into one comprehensive table
    Replace the two thin tables (FF+Fmax; LUT+DSP+power) with a single full-width
    table (tab:fpclose) giving complete placed resource utilization and achieved
    frequency for every FP design point, and tidy the explanation to walk it:
    # FP datapath Lanes LUT LUTRAM FF DSP BRAM Power Fmax
    1 Two-stage FMA 8 72,573 3,348 12,347 40 0 1.53 78.0
    2 + shared serial SFU 8 68,914 3,348 11,153 40 0 1.22 84.1
    3 Three-stage FMA 8 69,987 3,348 14,954 40 0 1.22 100.7 (MET)
    DSE: four lanes 4 36,785 1,748 6,953 20 0 0.98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
2026-06-25 docs: add draw.io architecture diagrams (whole-chip + per-lane datapath)
    Three editable draw.io sources of the SIMTiX architecture:
    - simtix_arch: simple whole-chip block diagram
    - simtix_arch_detailed: detailed view with a schematic-symbol per-lane
    datapath (MUX / ALU / multiplier / adder / pipeline registers)
    - simtix_arch_detailed_blocks: same detailed view with plain blocks
    FP datapath tinted; color legend for FP / storage / front-end / control.
2026-06-26 FP timing Stage A: pipeline-balance fmul (A2) + register FPU operand boundary (A1)
    First step toward closing 100 MHz on the full FP chip. Placed timing showed the
    worst path was: warp-state -> f-file LUTRAM read -> 24x24 DSP multiply ->
    normalize+round, all in one cycle (~12.0 ns / 82.5 MHz, route-dominated).
    A2 (simt_fpu.sv): the standalone fmul was the one op doing multiply AND round in
    stage 1 (the FMA already spreads its work across S1/S2/S3). Split it — stage 1
    forms the exact 48-bit product, stage 2 does the prod[47] select + exponent +
    round. Isolates the significand multiply on a clean register boundary so it can
    pack into a registered DSP later; arithmetic is unchanged.
    A1 (warp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
    [simt_fpu.sv, warp_pool.sv]
2026-06-27 fpga: add full-chip FP impl flows; Stage A measured at 90.3 MHz
    Add the two in-context whole-chip FP implementation scripts used to
    measure Stage A1+A2 on the ZCU104 (xczu7ev):
    * impl_chip_fp.tcl default-directive flow (publication-grade,
    but synth Timing-Optimization is impractical
    on the 8 GB host: >2.75 h, compute-bound).
    * impl_chip_fp_fast.tcl synth_design -directive RuntimeOptimized
    (synth 2.75 h -> ~19 min); full place +
    phys_opt + route kept at default effort so
    the PLACED WNS (the real metric) stands.
    Stage A result (fast flow, post-rout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
2026-06-28 accel: de-fanout issue_w + instr via MAX_FANOUT -> 96.4 MHz
    Placed timing on the full FP chip showed the critical path's two
    worst nets were broadcast nets in warp_pool: the round-robin warp
    select issue_w (drives every VRF/FRF distributed-RAM read address
    via vaddr(); top bit fanned out to ~2419 endpoints) and instr (=
    imem_data, the async-LUTRAM instruction fetch; ~1324 endpoints).
    Route/congestion was 61% of the critical-path delay.
    Annotate both signal declarations with (* max_fanout = 80 *) so
    Vivado replicates the drivers into physically-local clusters. This
    is a logic-equivalent synthesis directive (no functional change;
    Verilator -Wall clean on pool/accel/soc/chip), so no functional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
    [warp_pool.sv]
2026-06-29 accel: B1 — pipelined decomposed integer multiply on W_MUL scoreboard
    RV32M `mul` used to execute as a single-cycle `a*b` in the per-lane ALU,
    placing a DSP48 directly in the fetch->execute->writeback combinational
    cloud (the placed critical path) and — being un-pipelined — emitting
    DPIP-2/DPOP-3/DPOP-4 DRC advisories on every inferred multiplier.
    Pull `mul` out into a background engine that mirrors the W_FPC pattern:
    operands are captured at issue (q_mul_a/q_mul_b), the warp parks on a new
    W_MUL state + single-slot MUL scoreboard, and the product writes back to
    the integer VRF when the port is free (yields to the memory + FPC engines).
    The low-32 product is DECOMPOSED into three 16x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
    [dsp_pack_probe.sv, warp_pool.sv]
2026-06-29 accel: B2 — share + fully pipeline the FP significand multiply (clean DSP)
    The standalone fmul (s1_mul_prod) and the FMA (s1f_P) both computed the
    identical siga*sigb. Compute it ONCE and share it (one 24x24 DSP cascade
    per lane instead of two), through an input register + three output
    registers (MREG/PREG/cascade) — the depth-4 pattern proven 0-warning in
    tests/dsp_pack_probe.sv — so the inferred DSP packs fully (AREG/BREG/
    MREG/PREG) and emits no DPIP-2/DPOP-3/DPOP-4 advisories.
    This puts the product 4 cycles after the operands, making simt_fpu a
    5-stage pipeline (T+5, was T+2). The stage-0 results (add-front, mul/FMA
    exponent + specials, shallow ops, passthrough) ride a packed-stru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
2026-06-29 fpga: add OOC DSP pipeline/DRC checker; confirms B1+B2 pack all 40 DSPs
    check_dsp_drc.tcl synthesizes simt_accel out-of-context, inventories every
    inferred DSP48's pipeline registers (AREG/BREG/MREG/PREG), and runs
    report_drc -checks {DPIP-2 DPOP-3 DPOP-4}. On the B1+B2 netlist: 40/40 DSPs
    fully packed, 0 partial, Checks found: 0 — the entire DSP-pipelining warning
    bucket (was 168: 96 DPIP-2 + 32 DPOP-3 + 40 DPOP-4) is eliminated.
2026-07-02 accel: task#23 — 2-stage Fetch/Execute pipeline in warp_pool
    Split the single-cycle fetch->decode->VRF-read->ALU->writeback cloud (placed
    critical path: 26 logic levels, 82% route) at a new F/X register boundary:
    stage F selects a runnable warp round-robin and fetches from the async imem;
    stage X decodes/executes/commits the NEXT cycle from registered copies of the
    instruction + warp context (instr, issue_w, cur_pc/sp/mask/rpc).
    A per-warp in-flight bit keeps a warp out of the fetch pool until X resolves
    its instruction (PC/state update at resolve), so the fetched TOS context is
    stable across F->X. X always resolves in one cycle: commit, park on an
    engine, or (engine-busy / writeback-squa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
    [warp_pool.sv]
2026-07-03 fpga: task#25/#28 - deployable full-chip build: real pins + clean DRC + 100 MHz MET
    Final FP full-chip implementation (impl_chip_fp.tcl, non-project batch):
    default synth directive (full DSP pipeline-register absorption - kills the
    8 DPIP-2 warnings RuntimeOptimized left) + real ZCU104 pin constraints in
    constr/chip_top_zcu104.xdc. Pin LOCs are extracted from the placer's own
    choices in the unconstrained 107.3 MHz run (reports_fp_chip_fast/
    post_route_io.rpt): result[31:0] in HP bank 68, clk/rst/done in HD bank 88
    with clk on the clock-capable HDGC pin E4 - so NSTD-1/UCIO-1 pass with no
    severity downgrade and the dedicated clock route is legal with no
    CLOCK_DEDICATED_ROUTE override.
    reports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
2026-07-03 paper: fold full-SoC deployable closure into both variants (103.7 MHz, clean DRC)
    Extends sec:fppa past the OOC accelerator result with the final arc: the
    integrated FP SoC first places at 82.5 MHz, congestion-bound in the warp
    scheduler's single-cycle fetch->execute cloud (82% route on the two broadcast
    nets); a fetch/execute pipeline register (per-warp in-flight bit, re-issue
    semantics preserved, <=0.3% cycle cost at N=1024) restores closure; the
    deployable build with full ZCU104 pin constraints and a warning-free DRC signs
    off at +0.360 ns (103.7 MHz), 71.6k LUT / 40 DSP / 0 BRAM / 1.20 W.
    tab:fpclose gains the deployable-SoC row; abstract, contributions, and
    conclusion updated in both s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
2026-07-05 paper: pull Table IV onto page 5 and shorten its caption
    The closure-PPA table (tab:fpclose) was defined after the SoC
    paragraph, so as a double-column float it could not appear before
    page 6, where it sat stranded above the references. Move the
    environment to just after its first reference (processed on page 4),
    which places it at the top of page 5, directly above the closure
    walk-through it summarizes.
    Cut the ten-line caption to two sentences; the row-reading details
    (steps 1-3 OOC at eight lanes, DSE at four, final row = in-context
    SoC, LUTRAM = distributed-RAM subset incl. shared memory, zero BRAM,
    device-percentage basis) move into the section intro where the table
    is introduced. Stil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
2026-07-05 fpga: gate-level funcsim of the deployable FP netlist PASSES
    New run_postimpl_fp_sim.bat (mirror of the M13 integer flow) compiles
    postimpl_fp/chip_top_fp_funcsim.v - the exact placed-and-routed
    netlist the 103.7 MHz clean-DRC bitstream was written from - against
    the self-checking tb_chip_top.sv in xsim. The routed FP-enabled chip
    boots its host CPU, drives the offload, and computes result = 964 in
    ~216 cycles, bit-exact with RTL. The deployable build is now verified
    functionally, not just timing-clean.
2026-07-05 paper: add quantitative comparison table vs Vortex to Related Work
    New Table V places the complete SIMTiX SoCs (placed-and-routed, host CPU
    and shared memory included) next to Vortex's published per-core synthesis
    numbers (MICRO'21 Table 3), matched at 4 warps x 8 lanes/threads. Rewrote
    the Related Work paragraph around it: Vortex's FMA maps onto Intel's
    hardened FP DSP blocks, so placed FP timing is absorbed by hard macros;
    on UltraScale+ the FP datapath is DSP48 multipliers + fabric
    align/normalize/round, which is why the placed, signed-off FP closure
    study is the datum larger cores do not report. Still exactly 6 pages.
2026-07-06 kernels: add verified FP32 GEMM and softmax (MLP-inference primitives)
    fgemm.S one warp = one 8x8 FP32 matmul row, C[col]=sum_k A_row[k]*B[k*8+col],
    fused fmadd.s accumulation, A_row staged once in the scratchpad and
    reused across K (the matmul_smem trick in floating point).
    fsoftmax.S numerically-stable softmax over one warp of 8 (max-subtract, exp,
    normalize). SIMTiX has no exp op, so exp(z) is synthesized from FMAs:
    2^(z*log2e) = 2^k * 2^f with a degree-4 Horner polynomial for 2^f and
    a bit-built exponent for 2^k. The two cross-lane reductions use the
    single-sided-if reconvergence convention and broadcast via scr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
    [tb_fpkernels.sv]
2026-07-17 AI-2: INT8 GEMM kernel (qgemm) + measured FPGA PPA / GOPS-per-W
    Add qgemm.S, the pdot8 twin of fgemm: a full 8x8 INT8 GEMM tile (K=16),
    one warp per output row and one lane per column, reducing K four elements
    at a time with pdot8. Operand layouts are chosen so both loads coalesce --
    A is row-major (shared row -> broadcast) and B is pre-packed [Kp][N] words
    (the standard inference weight layout; contiguous columns -> coalesced).
    tests/tb_qgemm.sv checks all 64 INT32 outputs bit-exact against a signed
    integer matmul reference; make -C sim test-qgemm. Measured: 538 cycles,
    72 global-mem transactions (= 8 warps x 9, matching the coalescing model
    exactly -- 8x less traffic than a naive 576).
    M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
    [tb_qgemm.sv]
2026-07-17 AI-3: INT32->INT8 requantization kernel (requant, FP-reuse)
    Add requant.S, the bridge that lets quantized layers chain: it rescales a
    layer's INT32 accumulator back to a signed byte,
    out = clamp(round(acc*scale + zero_point), -128, 127),
    as a branchless FP sequence reusing the existing pipeline (fcvt.s.w ->
    fmadd.s -> fmin.s/fmax.s -> fcvt.w.s rne). No new hardware: SIMTiX already
    has an FPU, so a dedicated fixed-point requantize datapath is not needed
    (the gemmlowp-style integer instruction is left as future work + a PPA/
    energy comparison point).
    Outputs are stored with sb at stride 1, so four lanes' bytes pack into one
    word -- exactly qgemm's packed-INT8 input layout -- letting requa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
    [tb_requant.sv]
2026-07-17 AI-4 step 2: INT8 GEMV + requant_relu kernels (MLP-layer primitives)
    Add the two operators an MLP layer needs, built on pdot8.
    qgemv.S: INT8 matrix-vector product out[n] = sum_k x[k]*W[k][n], one lane per
    output element, reducing K four at a time with pdot8. Generalizes qgemm to
    M=1 and arbitrary N,K -- the general fully-connected-layer primitive. It is
    parameterized: Kp = K/4 is read from a config word (byte addr 0x100) and N
    (the W column stride) from the seeded thread count a4, so one kernel serves
    both MLP layers. Layouts coalesce as in qgemm: x is broadcast (shared vector),
    Wpacked[Kp][N] gives contiguous columns per warp. Verified bit-exact
    (tests/tb_qgemv.sv, N=16 across 2 warps, K=3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
    [tb_qgemv.sv]
2026-07-17 AI-4 step 3: end-to-end quantized MNIST inference on the accelerator
    Wire the AI-1..AI-3 operators into a full INT8 MLP (784->128->10) forward
    pass running entirely on warp_pool's own kernels:
    x -> qgemv(K=784,N=128) -> requant_relu(M1) -> qgemv(K=128,N=10) -> argmax
    The host (tb, standing in for the CPU driver) only sets base pointers, the
    Kp config word, and launches each kernel.
    tests/tb_mnist.sv loads the packed weights/images/golden (hex, via $readmemh),
    runs all 64 test images through the pipeline, does the argmax, and checks each
    prediction against the integer-exact golden. Result:
    accelerator vs golden : 64 / 64 match
    accuracy vs labels : 63 / 64 = 98.4%
    RESULT: P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
    [tb_mnist.sv]
2026-07-17 AI-4 step 4a: BRAM weight ROM for the on-chip MNIST demo
    Add weight_rom.sv, a BRAM-backed (ram_style="block") read-only weight store
    for chip_top. The 4 KB LUTRAM shared_mem cannot hold the ~100 KB MNIST weights,
    and putting them in LUTRAM would cost ~50k LUTs; block RAM holds them in ~29
    RAMB36 (of 312) -- which is where real inference accelerators keep weights.
    The accelerator core (async single-cycle memory) is left untouched: the host
    CPU streams weight tiles from this ROM into the accelerator's working memory.
    BRAM read is synchronous (rdata + rvalid one cycle after en); chip_top will
    turn rvalid into the CPU's mem_ready handshake (the pipeline already stalls on
    !mem_ready), so the 1-c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
    [weight_rom.sv]
2026-07-17 AI-4 step 4b/4c: wire BRAM weight ROM into chip_top + enlarge shared memory
    Rewire the full chip for on-chip MNIST weight storage:
    - chip_top: add the 0xA.. weight-ROM address region and instantiate
    weight_rom, with a one-cycle CPU stall handshake (mem_ready held low
    for the first cycle of each synchronous BRAM read). Read-data mux now
    selects MMIO / weight-ROM / shared-memory. Shared memory grown from
    the 4 KB default to 16 KB (SHARED_WORDS=4096) for MNIST working set.
    - riscv_pipeline: expose MemReadM (ResultSrc==ReadData) so chip_top can
    gate the weight-ROM read enable; other instantiations leave it open.
    - sim/Makefile: add weight_rom.sv to the CHIP_RTL file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
    [chip_top.sv, riscv_pipeline.v]
2026-07-17 AI-4 step 4d: on-chip end-to-end MNIST inference (bit-exact, 64/64)
    The full chip now runs quantized MNIST MLP inference (784->128->10 INT8)
    end-to-end through the REAL datapath, with the host CPU streaming weights
    out of the BRAM store into the 16 KB LUTRAM working memory on demand:
    host CPU <-> BRAM weight store (0xA) <-> LUTRAM working mem (0x0)
    <-> MMIO (0x8) <-> SIMT accelerator
    Since the 98 KB of weights do not fit in the accelerator's 16 KB working
    memory, the driver TILES them: per output-column tile it copies that tile's
    weights (repacked to the tile stride) from BRAM into working memory, then
    launches qgemv on the tile -- exactly the weights-in-BRAM / tile-into-fabri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
    [chip_top.sv, driver_rom.sv, tb_chip_mnist.sv]
2026-07-22 AI-4: BRAM-inclusive PPA of the on-chip MNIST chip config
    Add the FPGA flow for the deployable MNIST chip (chip_top fixed to
    DRIVER="mnist" + 256 KB weight/data store) and fold the measured PPA
    into docs/ai4_mnist.md.
    - rtl/soc/chip_top_mnist.sv: synthesis/impl top wrapper (basename INIT
    files so $readmemh resolves in both the batch and GUI flows).
    - fpga/synth_chip_mnist.tcl: OOC timing-driven synth of the whole chip;
    reports LUT/FF/BRAM/DSP, Fmax estimate, power.
    - fpga/create_project_mnist.tcl: managed Vivado GUI project for
    elaborated-schematic browsing (every functional unit as its own box).
    - fpga/reports_chip_mnist/: post-synth util/timing/power reports.
    Result (xczu7ev, OOC s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
    [chip_top_mnist.sv]
2026-07-22 AI-4: fast reduced-image post-synthesis sim of the MNIST chip
    Add a minutes-not-hours post-synthesis gate-level sim path for the
    on-chip MNIST accelerator. Post-synth sim runs the synthesized netlist,
    so the fast run bakes a reduced image loop into the driver ROM; the
    netlist logic is identical to the PPA build (chip_top_mnist), only the
    ROM contents differ.
    - kernels/mnist/mnist_driver.S: parameterize the image count with a
    #define NIMG (default 64 -> the 64-image driver is byte-identical, a
    single-word diff). A -DNIMG=2 build shortens the loop.
    - sim/Makefile: mnist-driver-short (assembles the -DNIMG=2 driver) and
    test-chip-mnist-short (behavioral smoke test).
    - rtl/soc/chip_top_mni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
    [chip_top_mnist_short.sv, tb_chip_mnist_short.sv]
2026-07-22 docs: add M.Tech. thesis presentation + post-synth sim proof scripts
    - docs/slides/simtix_slides.tex + .pdf: 24-slide Beamer deck covering
    architecture, SIMT execution model, FP subsystem, the 100 MHz
    timing-closure study, the pdot8 AI extension, the quantized operator
    library, end-to-end MNIST (64/64 bit-exact), the full PPA tables
    (incl. the AI MNIST BRAM build), verification, and DSE findings.
    - fpga/synth_postsynth_mnist.tcl + run_postsynth_mnist_sim.bat: headless
    post-synthesis gate-level sim flow for the reduced-image MNIST config
    (synthesize chip_top_mnist_short, write funcsim netlist, xsim it).
    The reduced config is verified bit-exact behaviorally (2/2); the
    gate-level n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
2026-07-23 docs: drop the open-source framing from the VLSID paper
    The repository is staying closed, so every claim of public availability comes
    out. The timing-closure study is unaffected -- it never depended on the design
    being open -- but the framing did, in seven places.
    - Title: "An Open-Source SIMT Accelerator" -> "A Compact SIMT Accelerator".
    - Abstract, Introduction, Conclusion: "open-source" removed.
    - Index Terms: "open-source hardware" -> "place-and-route".
    - Contribution 1 recast on the mechanism set and compactness ("a design compact
    enough to carry through the entire RTL-to-bitstream flow") rather than on
    availability.
    - Conclusion's closing sentence ("The design and its evaluation i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
2026-07-23 docs: fix attribution, citation, and framing defects in the VLSID paper
    Four findings from a full pass over the built PDF (numbers, citations,
    cross-references, floats, and every page rendered and read).
    - Reclaim our own result. Section II gave the 22.5% lane clock-gating saving
    with \cite{gpuwattch} attached, so it read as GPUWattch's number; it is ours,
    from the M7a study (docs/m7_energy.md). It is now stated as measured, with
    GPUWattch cited for the activity-based modelling context instead. The claim is
    also scoped honestly: we measure lane utilization from RTL counters, and the
    energy figure follows from a first-order equal-energy-per-lane-instruction
    model (which ignores I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
2026-07-23 docs: add the AI-use declaration required by the VLSID CFP
    The VLSID 2027 call for papers states, twice, "You must explicitly declare the
    use of AI in the acknowledgments section of your manuscript," and the requirement
    applies to the submitted double-blind manuscript, not only the camera-ready. The
    paper had no acknowledgments section at all, so it was non-compliant and exposed
    to desk rejection independently of its technical merit.
    - New \section*{Acknowledgment} before the references, declaring that a large
    language model (Anthropic Claude, via Claude Code) assisted this work across
    RTL and testbench code, scripting, figure generation, and the drafting and
    editing of the manuscript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
2026-07-23 docs: de-enumerate the AI declaration
    Listing "figure generation" invited the misreading that the results figures were
    AI-produced, when Figs. 2 and 3 are generated by the authors' own plotting
    scripts from measured sign-off data. Replace the itemised list with the more
    usual general form -- assistance with "the preparation of this manuscript and
    with supporting build and analysis scripting" -- which covers the same ground
    without inviting that inference. The authorship and responsibility clauses are
    unchanged.
    Verified: 6 pages, zero overfull boxes; the word "figure" no longer appears in
    the acknowledgment.
2026-07-23 asic: add the sky130 synthesis flow (work in progress, no result yet)
    Yosys synthesis of the accelerator to sky130_fd_sc_hd via the OpenLane image.
    The toolchain now runs end to end up to abc, but no completed run exists yet, so
    nothing here should be quoted as a result. asic/README.md records the state.
    Three blockers had to be cleared to get this far, all captured in the scripts so
    they are not rediscovered:
    - Yosys 0.30 cannot parse a package import in a module header, and neither
    OpenLane image ships sv2v or the slang plugin. sv2v v0.0.13 (installed to
    ~/tools, no root) converts first; gen/ is regenerated every run so the RTL
    stays the single source of truth.
    - sv2v must run with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
2026-07-23 docs: ground the closure arc in a delay model and add an area-time metric
    The timing-closure section read as trial and error: pipeline, measure,
    share, measure, pipeline again. It now states the delay model first --
    T_placed = T_logic/S + t_reg + T_route(A_local) -- and presents each step
    as a prediction of it, including the four-lane point, which the model
    predicts will fail and which is what separates local density from total
    area as the binding term.
    Each microarchitectural choice now carries its reasoning:
    - two stages is the minimum depth conventional sizing admits, and the
    split at the FMA accumulator boundary is chosen for stage balance;
    Step 1 is the experiment that falsifies t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
2026-07-23 docs: broaden related work and evaluation, per thesis-guide review
    Related work. Adds the current Ventus reference (Li et al., IEEE TVLSI
    33(8), Aug 2025) alongside the original, and MIAOW. Table V gains a
    Ventus row -- one SM without tensor core on a VCU128, 329k LUT / 80.4k
    FF / 108 BRAM -- which puts the complete SIMTiX SoC at under a quarter of
    a single Ventus SM. Two findings from that literature corroborate ours
    and are now stated as such: Ventus reports its vector register file as
    the largest block of the SM at 54.4% of area, which is the same
    structure our closure arrives at from the timing side; and Ventus
    measures 0.47/0.40/0.32 IPC at 4/8/16 threads against our 0.78 by the
    same co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
2026-07-23 docs: restore the FP throughput figure, fold the kernel table into prose
    Brings back Fig. 3 (throughput versus problem size, FP16 markers on the
    FP32 curves). Paid for by folding Table II's four FP kernel rows into the
    surrounding paragraph, which keeps every measured number -- fsaxpy 419 and
    451, fnorm 2,396, fdot 1,991 at 45 percent -- and by tightening prose. Two
    long author lists shortened to et al.; Ventus has seven authors, so that
    is the correct IEEE form there anyway.
2026-09-27 docs: add a gate-level datapath figure of warp_pool with explanation
    docs/figs/datapath_tikz/gen_datapath_tikz.py draws the warp_pool datapath
    in TikZ at digital-block level: muxes, ALU, adders, comparators, AND/OR
    gates, capture and pipeline registers, and every wire between them. The
    drawing engine, dp_engine.py, refuses to build if a wire crosses a block,
    two nets overlap or run closer than 1.6 mm, or a label collides; wire
    crossings are drawn with hops.
    simtix_datapath_tikz.pdf has six pages: the figure, a step-by-step
    explanation of the datapath's operation (operation.tex), a connection
    table giving each block's inputs, outputs and role (connections.tex), and
    a glossary of block and si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
2026-09-29 docs: add a block-level chip_top diagram
    docs/figs/chip_top_tikz/gen_chip_top.py draws the complete SoC from
    chip_top.sv. The host side shows the 5-stage RV32I pipeline, driver ROM,
    host data bus, top-nibble address decode, result register, BRAM weight
    store and read-data return mux. simt_accel shows the MMIO registers,
    dispatcher FSM and a block view of warp_pool. The shared memory shows its
    CPU, instruction and 256-bit line ports over the 8 LUTRAM banks. It is
    built with the verified engine: 0 errors, 2 crossings drawn as hops.
    dp_engine.py gains dashed group frames, a mirrored mux for right-to-left
    data, group-aware compaction, and panels painted above groups. The
    datapath figure rebuild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
2026-09-29 docs: chip_top diagram shows block names only, no notation key
    Drop the secondary detail lines from the driver ROM, address decode, weight
    store, MMIO registers and dispatcher blocks, and remove the notation key.
    Still builds with 0 errors and 2 hopped crossings.
2026-10-21 v2 WP1: warp shuffle, barriers, thread blocks, shared scratch, RV32A atomics
    - shfl.{idx,up,down,xor} (custom-0, funct7=1) on a W_SHF engine with
    operands captured at issue
    - bar (custom-0, funct7=2): warps of a thread block wait in W_BAR
    - REG_BLOCK (0x20) = log2 warps per block; a block spawns whole into a
    slot group
    - block-shared scratchpad aperture at 0x6000_0000
    - RV32A word AMOs (no lr/sc), read-modify-write one lane per cycle on
    global memory and scratch
    - kernels/sync: shuffle/reduction/histogram/scan/AMO kernels, tb_sync
    (834 checks) and a make test-sync target
    - sim/run_xsim.py: Vivado xsim regression runner
    reduce, N=1024: 6026 -> 2953 cycles with the shuffle butterfly.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
2026-10-21 warp_pool: spawn step as single-statement loops for Verilator 5.020
    The block spawn wrote every slot of the group from one multi-statement
    for-loop body, which Verilator 5.020 (CI) rejects with BLKLOOPINIT. The
    per-slot enable, base and tail mask now come from an always_comb, and
    each array is written by its own single-statement loop. tb_sync cycle
    counts are unchanged.
2026-10-21 tests: make tb_fpkernels, tb_fpbench, tb_requant, tb_divsqrt xsim-safe
    - xsim evaluates mem[widx(X)+i] = f(i) inside an automatic task with the
    first iteration's value for every i; the preloads now go through a
    temporary
    - tb_divsqrt drives and samples 1 ns after the clock edge instead of in
    the same time step as the DUT's nonblocking updates
    All 19 xsim tests pass.
2026-10-21 Pass CI's Verilator 5.020: spawn clears and tb_sync histogram
    - warp_pool: the spawn-time reg_written/freg_written clears put the
    slot test outside the l/r loops, the only nested form 5.020 accepts
    (BLKLOOPINIT)
    - tb_sync: compute the histogram bin into a temporary (SIDEEFFECT)
    make lint and make test pass locally with Verilator 5.020.
2026-10-23 v2 WP2 step 4: AXI4 master behind the L1; L1 implementation numbers
    rtl/accel/axi_line_master.sv turns the L1's memory-side line port into
    AXI4 for a 128-bit slave (the ZCU104 S_AXI_HP ports into DDR4): a line is
    one 2-beat INCR burst, the line tag is the AXI ID, write strobes come
    from the byte enables, read beats are collected per ID, and err reports
    SLVERR/DECERR.
    tb_sync AXI = 1 runs engine -> L1 -> AXI4 master -> a behavioural AXI4
    slave with 24-cycle out-of-order responses and ready stalls; new test
    sync_axi (make test-sync-axi), 834 checks pass.
    fpga/impl_l1.tcl synthesises, places and routes the L1 alone on xczu7ev:
    2.7k LUTs, 1.7k flip-flops, 16 RAMB36, +3.97 ns slack at 100 MHz
    (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
2026-10-23 v2 WP2 step 5a: ZCU104 board top, block design and A53 host program
    rtl/soc/simt_ps_top.sv makes the accelerator a Zynq UltraScale+ PS
    peripheral: an AXI4-Lite slave for the A53 (command registers, L1 and
    AXI-error counters at 0x100, a 4 KB kernel instruction RAM at 0x1000)
    and the data path simt_accel -> l1_dcache -> axi_line_master -> AXI4
    master for S_AXI_HP0 into DDR4. Writing GO invalidates the L1.
    simt_ps_wrap.v is the Verilog top a block-design module reference needs.
    tests/tb_ps_top.sv drives it the way the host will, against
    tests/axi_mem_model.sv (24-cycle out-of-order AXI4 memory): loads two
    kernels over AXI4-Lite, runs reduce_shfl and histogram (N = 1024), then
    changes the data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
2026-10-23 Board build: ZCU104 bitstream meets 100 MHz; Vitis host build and JTAG run script
    Post-route (A53 PS + accelerator + L1 + AXI master): WNS +0.019 ns at
    100 MHz, 80.4k LUT / 22.8k FF / 16 RAMB36 / 72 DSP; accelerator 0.80 W of
    3.45 W dynamic. Reports in fpga/reports_ps/.
    sw/ps_host/build_vitis.py builds the standalone A53 platform and the host
    program with the Vitis 2025.1 Python API; main.c moves to the xiltimer
    API. run_board.tcl programs the PL and runs the ELF over JTAG.
    docs/board_zcu104.md has the build and lab steps.
2026-10-23 v2 WP4: application suite on the board top (GEMM, SpMV, stencil, k-means, BFS)
    kernels/apps/: FP32 GEMM (one thread per output), CSR SpMV (one thread per
    row, gathers, divergent loops), 5-point Jacobi stencil (ping-pong sweeps),
    integer k-means assignment with AMO accumulation, level-synchronous BFS
    (one launch per level, amoor flag). Arguments come in a parameter block
    whose address is passed in a1.
    sim/gen_apps.py writes the DDR4 images, the launches and the expected
    outputs; FP32 references round once per operation (exact fractions), so
    fmadd is fused and every result is checked bit-exact. tests/tb_apps.sv
    drives simt_ps_top over AXI4-Lite as the A53 will, with a 4 MB AXI4 DDR4
    model, an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
2026-10-23 v2 WP3: one AMO lane per cycle by default (APAR); WP4: multi-block scan
    The parallel lane rounds cost 3.4k LUT (mem_engine out of context: 16,628
    LUT against 13,256 for one lane per cycle and 10,705 before aggregation),
    and with them the board build missed 100 MHz by 0.119 ns
    (fpga/reports_ps_apar1/). APAR selects the round width: 0 (default) applies
    one lane per cycle through one AMO ALU, 1 keeps the parallel rounds. Both
    return the same values; histogram speedup over one read-modify-write per
    lane: 1.78x / 2.01x behind the L1, 1.71x / 1.86x through the AXI master.
    sim/amo_sweep.py compares base / ser / par; impl_mem_engine.tcl builds the
    variants by name. New regression targets: sync_apar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
2026-10-23 v2 WP4: application suite on the board host, with A53 baselines
    sw/ps_host/apps.c runs GEMM, SpMV, stencil, k-means, BFS and the
    multi-block scan on the accelerator at a medium and a DRAM-sized input
    (up to 256x256 GEMM, 64k-row SpMV, 512x512 stencil, 262k points, a
    262k-vertex graph, 1M-element scan), with data in a DDR4 window at
    0x1000_0000. Each run is timed against an ordinary sequential A53 code
    (queue BFS, running-sum scan, i-k-j GEMM) whose FP32 operations match the
    kernels' (fmaf, no contraction), and every output is compared exactly.
    kernels.h now also embeds kernels/apps/*.hex. Compiles and links against
    the standalone BSP with -Wall -Wextra and no warnings; not yet run on the
    boa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
2026-10-23 v2 WP4: INT8 MLP in the application suite; AMO variant reaches the board top
    kernels/apps/mlp.S: one fully connected INT8 layer for a batch (pdot8), with
    requantization and a fused ReLU between layers and INT32 logits at the end.
    gen_apps.py builds 784-128-10 (sim) and 784-256-128-10 (large) networks with
    synthetic weights; apps.c runs 784-256-128-10 on the board for batch 16 and
    256 against an A53 reference. The engine's fcvt.w.s truncates, so the
    kernel encodes rtz and the zero point carries +0.5.
    simt_accel and simt_ps_top pass AMO_AGG / AMO_PAR to the warp pool
    (defaults unchanged), and tb_apps takes AGG / APAR. 8 applications, 7679
    checks pass in xsim; make lint is clean under Verilato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
2026-10-24 Board build meets 100 MHz with line-aggregated AMOs (+0.102 ns)
    Yesterday's APAR = 0 board build missed 100 MHz by 2.478 ns
    (fpga/reports_ps_apar0/): the memory engine's request, formed from its
    pending-lane masks, ran through the L1 tag lookup into the block-RAM write
    port, and through the grant back into the warp resume, in one cycle.
    l1_dcache: an input register and one skid entry, so the lookup, the
    miss-register match and the block-RAM write start from flip-flops and the
    engine's grant is a flip-flop; the answer to a waiting read is chosen one
    cycle ahead, so the response tag is a flip-flop too. A hit now answers two
    cycles after its grant.
    mem_engine: BYP = 0 lets a context finish fr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
2026-10-24 FPU: float-to-int conversions round by the instruction's rounding mode
    fcvt.w / fcvt.wu truncated whatever rm said, so the kernels that ask for
    rne (quant/requant.S, requant_relu.S, fptest/fsoftmax.S) got truncation.
    Their tests could not show it: the requant data landed on integers,
    softmax is checked to 1e-3, and the MNIST test checks only the predicted
    digit. With truncation 2298 of the 8192 MNIST hidden activations (28%)
    are off by one; all 64 predictions still match the golden.
    simt_fpu: stage 0 forms the truncated magnitude, the first dropped bit
    and the OR of the rest; the stage before reg2 rounds by rm (RNE, RTZ,
    RDN, RUP, RMM; dyn and the reserved codes round to nearest even, frm's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
2026-10-24 Board build with the rounding fix meets 100 MHz (+0.098 ns)
    Rebuilt the PS board top on 002f19a. 81.1k LUT, 23.9k FF, 72 DSP,
    16 RAMB36, 4.19 W. The worst path moved into a lane FPU's stage-0
    add; the L1 input register and warp state follow at +0.36 ns.
2026-10-24 v2 WP5: Vortex baseline (application port, run and synthesis scripts)
    baselines/vortex/simtix_apps ports the eight kernels of kernels/apps to
    Vortex 3.0's vx_spawn2 API, one thread per output and the same order of
    FP operations. The host replays sim/gen_apps.py's cases: it copies each
    memory image into a device buffer, relocates the address fields of the
    parameter blocks, runs the launches with tb_apps' block shape and checks
    every .gold word. On simx all seven small cases match.
    run_apps.sh runs it through ci/blackbox.sh at 1 core x 4 warps x 8
    threads, RV32IMAF, one memory bank. syn/ builds the same configuration
    with Vortex's own Vivado flow for xczu7ev at 100 MHz, and can put
    SIMTiX's b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
2026-10-25 v2 WP5: Vortex rtlsim results and instruction counts on both machines
    All seven application cases match their .gold files on Vortex's RTL
    simulator. Two port fixes keep the baseline from being held back by the
    port: -fno-math-errno, without which clang called fmaf() in every inner
    loop (GEMM 3.4x SIMTiX's cycles, 2.0x after), and pointer-increment
    loops as in the assembly. run_apps.sh refreshes the build tree's copy
    of the app Makefile, takes WARPS, EXTRA_CONFIGS, HOST_ARGS and RUN_NAME,
    and the host's -b sets the block size (at most the core's 32 threads;
    8 and 32 differ by under 1%).
    tb_apps now prints the warp instructions the pool issued per launch,
    read hierarchically from the existing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
2026-10-25 warp_pool: size the reconvergence stack by the lane count
    A divergent branch pushes a frame whose mask is a strict, non-empty
    subset of the mask below it, so a warp never holds more than NUM_LANES
    frames. The stack had a fixed depth of 8, which is exactly enough at
    eight lanes. At 16 lanes SpMV overflowed it: a warp whose 16 rows have
    more than eight different lengths leaves its loop at more than eight
    trips, and 339 of 512 rows were never stored. SDEPTH is now NUM_LANES;
    the eight-lane RTL is unchanged.
2026-10-25 v2 WP6: application suite at 4, 8 and 16 lanes
    kernels/apps/lanes.h and build.py --lanes/--out assemble the kernels for
    L lanes: scan and scan_add use blocks of 4L threads, the stencil a line
    of padding. The 8-lane images are byte-identical to the committed .hex.
    gen_apps.py --lanes/--kdir lays the data out to match.
    l1_dcache keeps 16 KB at any line width (NSET = 16384 / (NWAY * line
    bytes), 128 at eight lanes). The AXI memory model of tb_apps and
    tb_ps_top now holds a whole line's burst (MAXB = LINE_BITS / DW; it was
    2, and a 16-lane line is four beats). tb_apps +SHOWALL lists every
    mismatch. run_xsim passes Verilog defines and xsim plusargs through
    options files.
    sim/lane_sweep.py runs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
2026-10-25 v2 WP5: SIMTiX and Vortex through the same Vivado flow
    sim/vortex_syn.py collects each build's synth_summary.csv and vectorless
    power into docs/vortex_syn.csv and prints Vortex / SIMTiX per
    application for cycles, run time (each design at its own Fmax) and
    energy. docs/plot_vortex.py draws run time and energy per application.
    Out of context, xczu7ev, 100 MHz, Vortex's project.tcl for both:
    SIMTiX 84,443 LUT / 31,959 FF / 16 RAMB36 / 72 DSP, 101.6 MHz, 1.10 W;
    Vortex 4/8/16 warps 80,119 / 91,831 / 110,158 LUT, 140.8 / 135.9 /
    134.0 MHz, 1.70 / 1.85 / 2.08 W. Geometric means, Vortex / SIMTiX:
    cycles 2.78 / 1.80 / 1.58, run time 2.01 / 1.34 / 1.20, energy
    4.32 / 3.04 / 3.00. From eight warps V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
2026-10-25 Board host: power readout from the ZCU104 monitors
    sw/ps_host/power.c reads the INA226 on the 12 V input (U183, 5 mOhm) and
    the five outputs of the two IRPS5401 PMICs (0x43, 0x44) behind the
    PCA9548 mux on the PS I2C1 bus, as in the board's Linux device tree. It
    writes only the mux channel, the PMBus PAGE command and the INA226
    configuration, each after identifying the device.
    After the checked runs, apps.c repeats the DRAM-sized run of every
    application with sampling: idle, accelerator and A53 phases are each
    repeated for two seconds and sampled at most every 50 ms, and POWER rows
    give the average voltage and power per phase and rail. Not yet run on
    the board; compiles with -Wall -Wextra a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
2026-10-25 v2 WP7: IEEE TVLSI manuscript draft
    docs/paper/simtix_tvlsi.tex (IEEEtran journal): architecture with the
    L1, memory engine, synchronization and FP datapath; line-aggregated
    AMOs; implementation and timing closure; evaluation on seven
    applications, against Vortex on the same device and flow, and across
    4, 8 and 16 lanes. Red \tbd{} marks what is still to be measured: the
    16-lane build and the board run.
2026-11-02 v3 B2-B4 RTL, board debug window, fix for a Vivado mis-synthesis
    B2: the FP, multiply, dot and shuffle units take a warp instruction every
    cycle (per-unit result queues, wp_resq); a register scoreboard (pend_x/pend_f)
    puts warps to sleep on a hazard and wakes them at writeback; loads are
    non-blocking (two memory contexts per warp; stores, AMOs, bar and ecall wait
    for the warp's loads).
    B3: lost wake-up at 8 warps fixed (the issue step used the reason of the
    previous sleep); regression test apps_w8.
    B4: L1 size, miss registers, memory tags and contexts per warp as defines
    (SIMTIX_L1_KB, SIMTIX_L1_MSHR, SIMTIX_MEM_TAGS, SIMTIX_MEM_CTX_PER_WARP),
    next-line prefetch (SIMTIX_L1_PF, off by default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
2026-11-02 ZCU102 board flow and the Cortex-A53 baseline
    fpga/create_bd_ps.tcl builds for the ZCU102 (default) or the ZCU104, with
    tag/warps/l1kb/mshr/mtags options; fpga/paths_at.tcl lists the worst paths.
    sw/ps_host: build_vitis.py and run_board.tcl per board (the console text is
    also kept in DDR and read back over JTAG, so one USB cable is enough),
    power.c reads the ZCU102 INA226 monitors (18 rails), apps.c adds GEMM-RB,
    the segmented scan and the power pass.
    sw/a53_zcu102: bare-metal A53 runs on the ZCU102 over JTAG (PS initialisation
    from U-Boot's psu_init_gpl.c, fetched at build time and not in the
    repository), -O2 and -O3 timings in docs/zcu102_a53*.
    sim/board_sim.py: SIMTiX cycle counts for the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
2026-11-02 First ZCU102 board run: all kernels pass, SIMTiX vs the A53 with power
    Board build of the fixed RTL (reports_ps_zcu102_fix): WNS +0.235 ns at 100 MHz,
    84,007 LUTs, 33,226 FFs, 16 BRAM tiles, 72 DSPs. docs/zcu102_board_run.txt:
    24 kernel/size cases, 0 errors, and the power pass of 9 applications
    (18 rails; idle, SIMTiX and A53 phases). Run time A53 / SIMTiX: GEMM-RB 3.4,
    MLP 2.6, GEMM 1.0 (64) and 0.8 (256); the memory-bound and reduction
    kernels run faster on the A53.
    Also the reports of the B2 builds on the ZCU104 (reports_ps_v3b2) and the
    ZCU102 (reports_ps_zcu102) and of the debug build (reports_ps_zcu102_dbg);
    docs/worklog.md (10-27 to 11-02), docs/v3_plan.md and docs/v3_steps.csv.
2026-11-02 TVLSI draft: new figures, lane utilisation, memory-engine area, PDF
    Fig. 1 redrawn (docs/figs/arch_v2_tikz/gen_arch_v3.py), new Fig. 2 for the
    AMO datapath (gen_amo_fig.py), graphs restyled through docs/plot_style.py;
    Table II gains lane utilisation (docs/lanes_apps.csv). Memory engine OOC
    area re-measured on the current RTL, including the board configuration
    (BYP = 0) at 4, 8 and 16 lanes (fpga/impl_mem_engine.tcl lanes<n>/byp0,
    fpga/reports_mem_engine). docs/paper/simtix_tvlsi.pdf built from the .tex
    (9 pages).
2026-11-04 v3 low-cost speed-up at 115 MHz and the AXI write-order fix, on the ZCU102
    AXI ordering. The B3+B4 board lost histogram atomic updates: writes with
    different AXI IDs, and a read after a write to the same line, could
    complete out of order. axi_line_master now issues every write with one ID
    and matches B responses through an in-order tag FIFO; the L1 holds a read
    miss while a write to the same line is in flight. The test slaves keep
    per-ID in-order B queues, and MEM_LATE=1 tests (ps_late, ps_b34_late,
    ps_b34_board, apps_b34_late) reproduce the bug.
    Kernels and ISA. stencil_rb.S (16-row strip per thread, two rows
    interleaved), kmeans_u.S (two points per thread, min + czero) and
    spmv_z.S (point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
2026-11-12 Rodinia and RiVEC on four machines, Vortex and Ara/CVA6 baselines on the ZCU102
    Rodinia (docs/rodinia_plan.md, docs/rodinia_results.md):
    - eight benchmarks with Rodinia's own data (pathfinder, backprop, bfs, hotspot, nn,
    hotspot3D, gaussian, kmeans) on SIMTiX, CVA6, Ara and Vortex, all measured on the
    board; SIMTiX kernels in kernels/rodinia, the shared FP32 reference rd_ref.h, the data
    blob (sim/rd_data.py), cases (sim/gen_rodinia.py), host driver sw/ps_host/rodinia.inc
    - results: baselines/ara/compare_rodinia.py -> docs/rodinia_results.csv; paper section
    "Rodinia on Four Machines", Table VIII and Fig. 5 (docs/plot_rodinia.py)
    - Ara: gaussian's Fan1 on CVA6's scalar divider (vector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
